ChristianLumby/Power2LabPowerSupply/Measurements/EMC/emc_setup.jpg

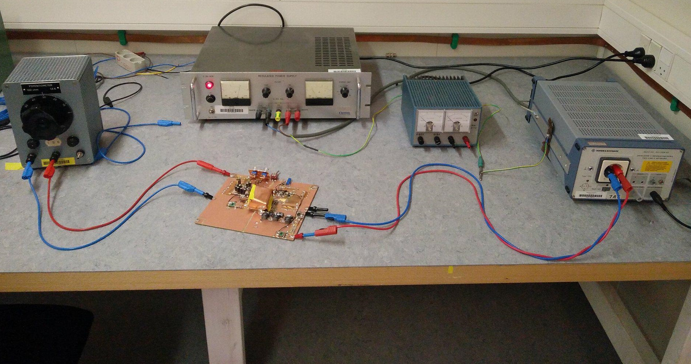
Measurements/EMC/emc_setup.jpg
