ChristianLumby/Power2LabPowerSupply/Measurements/Effeciency/eff_setup.jpg

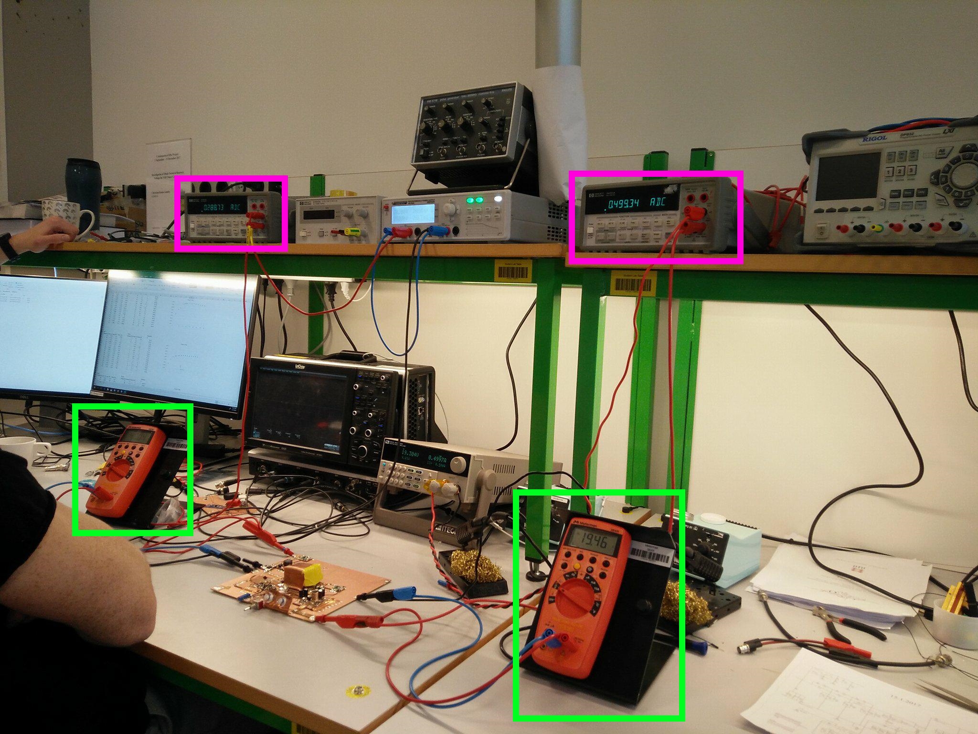
Measurements/Effeciency/eff_setup.jpg
