ChristianLumby/Power2LabPowerSupply/Notes/Notes.txt

Notes:

Pulldown resistor at gate (50k).
