ChristianLumby/Power2LabPowerSupply/31352_Power_Electronics_1_Final_Report.pdf

## Technical University of Denmark

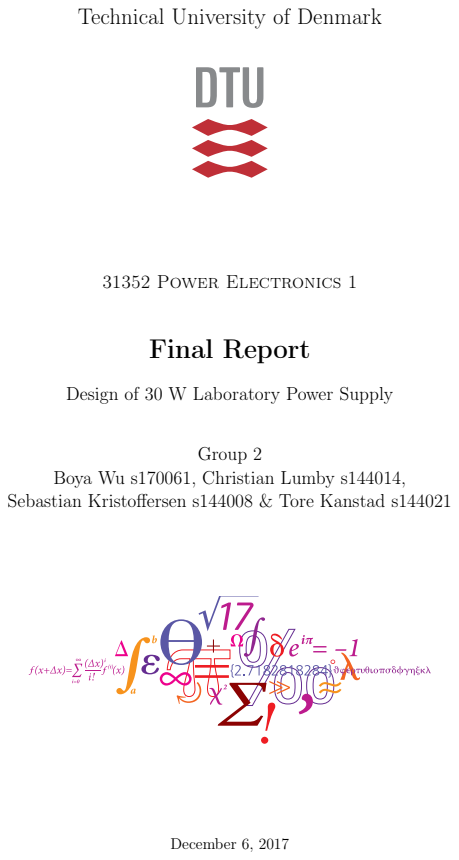
[picture p3: page 1]
31352 Power Electronics 1; Final Report; Group 2; December 6, 2017

Design of 30 W Laboratory Power Supply

Boya Wu s170061, Christian Lumby s144014,
Sebastian Kristoffersen s144008 & Tore Kanstad s144021

# Contents

1 Preface (SK, CL & TK) | 1
2 Topology Selection | 2
3 Magnetic Design (CL, SK, BW & TK) | 33

i

Contents | ii of 91
4 Filter Design | 48
5 Control Circuit (CL, SK & TK) | 68
6 Circuit Diagram and Bill of Materials (CL, SK, BW & TK) | 76
7 Performance Analysis (CL, SK & TK) | 79
8 Specification Comparison (CL, SK & TK) | 80
9 Discussion (CL, SK & TK) | 82
10 Conclusion (CL, SK & TK) | 83
A Magnetic Design: ETD-Cores | 84
B Magnetic Design: E-Cores | 86

Contents | iii of 91
C Efficiency Simulation Setup | 90

# List of Figures

2.1 The two cases of conversion ratios with the chosen transformer turns ratios marked
as black curves | | 3
2.2 Flyback converter | | 4
2.3 First subinterval of flyback converter | | 5
2.4 Second subinterval of flyback converter | | 5
2.5 Waveforms of Flyback Converter | | 6
2.6 The schematic of the SEPIC converter | | 11
2.7 First interval. Q1 is closed, D1 is blocking | | 11
2.8 Second interval. Q1 is open, D1 is conducting | | 11
2.9 Converter with LM | | 12
2.10 Waveforms of the isolated SEPIC converter | | 13
2.11 Isolated Ćuk converter with definitions of voltages and currents | | 18
2.12 Isolated Ćuk converter with MOSFET on | | 18
2.13 Isolated Ćuk converter with MOSFET off | | 18
2.14 Voltages and currents of the components in the Ćuk converter | | 19
2.15 Push-Pull converter with voltage and current definitions | | 24
2.16 First interval. Q1 is closed | | 24
2.17 Second and fourth interval. Both switches are open | | 25
2.18 Third interval. Q2 is closed | | 25
2.19 Current and voltage waveforms | | 26
3.1 Flyback converter with definitions of labels, polarities and directions | | 33
3.2 Magnetic flux density in the coupled inductor | | 33
3.3 Voltage and current waveforms | | 34
3.4 ETD-core and coil former dimension definitions | | 36
3.5 Minimum inductance to satisfy ripple current ratio | | 37
3.6 Relative core losses versus AC field flux density for N87, [1] p. 83 | | 43
3.7 Realizable ETD-core configurations with 2 primary layers | | 44
3.8 Cross section transformer. Grey: Core, Black: Bobbin, Red: Primary windings,
Yellow: Secondary windings, green: tertiary windings | | 45
3.9 Magnetization curves for N87, [1] p. 82 | | 46
4.1 Filter design overview | | 48
4.2 Minimum output capacitance, Coutmin [µF], as a function of Vin and Vout | | 50
4.3 PLECS simulation setup. Without input filter | | 52
4.4 Input Harmonics and CISPR 13 limits | | 53
4.5 Input Harmonics and CISPR 13 limits, zoomed in at the second and third harmonics.
Same colors as previous figure | | 54
4.6 Input filter topology | | 55
4.7 Small signal model of the Flyback converter | | 55
4.8 Impedance comparison for filter 2. Red: ZN , Black: ZD, Magenta: Zo2(undamped)

,
Blue: Zo2
| 56
4.9 Impedance comparison for filter 1. Red: ZN , Black: ZD, Magenta: Zo1(undamped)

,
Blue: Zo1
| 57
4.10 Impedance comparison for filter 0. Red: ZN , Black: ZD, Magenta: Zo0(undamped)

,
Blue: Zo0
| 57

iv

List of Figures | v of 91

4.11 Impedance comparison for entire filter. Red: ZN , Black: ZD, Blue: Zo, Magenta:
Margins | | 58
4.12 Filter gain, from transfer function, with the 200kHz point marked | | 59
4.13 Filter phase, from transfer function | | 59
4.14 PLECS simulation setup with input filter | | 60
4.15 Input Harmonics and CISPR 13 limits with input filter | | 61
4.16 Input Harmonics and CISPR 13 limits with filter, zoomed in at the second and third
harmonics. Same colors as previous figure | | 62
4.17 PLECS simulation setup for inrush current when starting the converter | | 63
4.18 Inrush current simulation results when starting the converter (at t = 0). Simulated
for two different input voltages | | 63
4.19 PLECS simulation setup for inrush current when connecting the converter | | 64
4.20 Inrush current simulation results when connecting the converter | | 64
4.21 Complete circuit with inrush limiter | | 65
4.22 Input current spike when connecting the converter. With inrush limiter | | 66
5.1 The TLV431 and the compensation network | | 69
5.2 Frequency response of the designed type 2 compensator | | 70
5.3 Model for loop response simulation in PLECS. Resistive parasitics are included in
this model | 70
5.4 Loop response of converter in the 4 corner cases in the case of the PLECS setup in
5.3. The vertical magenta lines are phase margins | | 71
5.5 The converter’s transient responses | | 72
5.6 The steady state ripple at output | | 72
5.7 Low pass filter for current sensing[9] | | 73
5.8 Compensating circuit[10] | | 74
6.1 Final circuit schematic | | 78
7.1 Efficiency estimation in PLECS. Based on eq. 7.1 | | 79
8.1 Output voltage during load step at 5V | | 80
8.2 Output voltage during load step at 30V | | 81
A.1 Realizable E-core configurations with 1 primary layer | | 85
B.1 Realizable E-core configurations with 1 primary layer | | 87
B.1 Realizable E-core configurations with 1 primary layer | | 88
B.2 Realizable E-core configurations with 2 primary layers | | 89
C.1 Complete circuit schematic for simulating efficiency, ripples and load steps | | 91

# List of Tables

1.1 Converter Specifications | | 1
2.1 Maximum, RMS and Average absolute values for the Components | | 9
2.2 Summary of the 4 corner cases | | 16
2.3 Maximum, RMS and average absolute values for the converter components | | 22
2.4 Maximum, RMS and average absolute values for the converter components . . . . | 29
2.5 Numerical comparison | | 32
3.1 ETD 29/16/10 parameters for N87 material | | 35
3.2 Conditions for determination of transformer configuration | | 44
4.1 Converter Specifications | | 48
4.2 Summary of transformer parameters | | 48
4.3 The four corner cases of operation | | 51
4.4 Capacitor RMS currents | | 66
4.5 Filter Parameters. See Fig. 4.21 | | 67
8.1 Converter Results | | 81
A.1 Conditions for determination of configurations in Fig. A.1 | | 84
B.1 Conditions for determination of configurations in Fig. B.1 | | 86
B.2 Conditions for determination of configurations in Fig. B.2 | | 86

vi

# 1 | Preface (SK, CL & TK)

The aim of this project was to design an isolated laboratory power supply. The converter’s efficiency and performance is for the most part considered more important than the size and weight of the laboratory supply. Firstly, four possible converter topologies are analyzed and compared for a final selection of a topology for further design. The analysis includes waveforms, modes of operation and component stress factors. For the chosen topology the magnetics are dimensioned and designed. This includes the physical configuration of windings and selection of core. This also includes an estimation of the winding and core losses based on more accurate current waveforms. An input and output filter of the converter is added to satisfy the specifications in table 1.1 while the impedance changes of the converter must also satisfy Middlebrook’s stability theorem. The design of the control loop of the converter using a peak current controller to achieve desired performance, and frequency analysis of the stability is done. Finally the report includes a review and summary of the work with a conclusion.

## 1.1 Specifications

| Condition | Minimum | Maximum
Vin | - | 20 V | 40 V
Vout | - | 5 V | 30 V
Iout | - | - | 1 A
∆Voutmax | Steady state | - | 50mV
∆Voutmax | Load step | - | 3 % of Vout
Input current harmonics | Steady state | - | CISPR 13 average
Inrush current spike | - | - | ETSI EN 300132-2

Table 1.1: Converter Specifications.

1

# 2 | Topology Selection

In this chapter, 4 different topologies for DC-DC switch mode converters are introduced and waveforms are analyzed with ideal components. The transformer ratios are determined from an analysis of the range of duty cycles required to meet the specifications in table 1.1. The stress factors of the components in the different topologies are calculated and finally a topology is chosen for the design of the laboratory power supply.

## 2.1 Transformer Turns Ratio (SK, CL & TK)

M is the DC conversion ratio.
M =

Vout

Vin

(2.1)

From the specifications it is seen that the minimum and maximum DC conversion ratios are:

Mmin =

5V
40V
= 0.125 | (2.2)

Mmax =

30V
20V
= 1.5 | (2.3)

As derived later, the conversion ratios of each converter are given by:

Mf lyback = MSEP IC = Mcuk =

nD
1 − D

(2.4)

Mpush−pull = nD | (2.5)

Where D is the duty cycle and n is the transformer ratio ns
np

. Expressions for the maximum and minimum duty cycles can be derived by using these formulas along with the minimum and maximum conversion ratios listed in equations (2.3) and (2.3).

Df lybackmin = DSEP ICmin = Dcukmin =

Mmin
n + Mmin

=

0.125
n + 0.125

(2.6)

Df lybackmax = DSEP ICmax = Dcukmax =

Mmax
n + Mmax

=

1.5
n + 1.5

(2.7)

Dpush−pullmin =

n

Mmin

=

0.125
n

(2.8)

Dpush−pullmax =

n

Mmax

=

1.5
n

(2.9)

From this it is seen that the range of duty cycles depends on the choice of transformer turns ratio. The limitations on the duty cycle are that it cannot be higher than 1 or lower than 0. One could argue that going close to zero duty cycle is preferable compared to going close to unity, because of the risk for shoot-through. But in this report, it is decided to place the range of duty cycles symmetrically. I.e. Dmax should be as close to 1 as Dmin is to 0.

D(Mmin) = 1 − D(Mmax) | (2.10)

Thus equation 2.6 and 2.7 are solved for the buck-boost types with the condition of equation 2.10. Similarly for the push-pull 2.8 and 2.9 are solved with the same conditions. The results are:

2

2.1. Transformer Turns Ratio (SK, CL & TK) | 3 of 91
nf lyback = nSEP IC = ncuk = 0.433 | (2.11)
npush−pull = 1.63 | (2.12)

Which gives the following duty cycle ranges.

Df lyback = DSEP IC = Dcuk ∈ [22%, 78%] | (2.13)
Dpush−pull ∈ [7.7%, 92%] | (2.14)

These transformer turns ratios are now chosen for the converters. Fig. 2.1 illustrates how the chosen values allow for a symmetric duty cycle to produce the needed minimum and maximum DC conversion ratios.

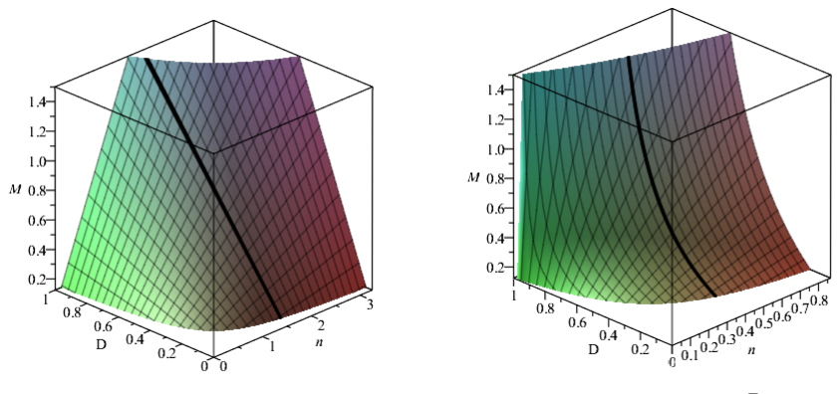
[picture p4: figure]

(a) M(n, D) = nD | (b) M(n, D) =

nD
1 − D

Figure 2.1: The two cases of conversion ratios with the chosen transformer turns ratios marked as black curves.

2.2. Flyback Converter (BW) | 4 of 91

## 2.2 Flyback Converter (BW)

### 2.2.1 Schematic & Operation

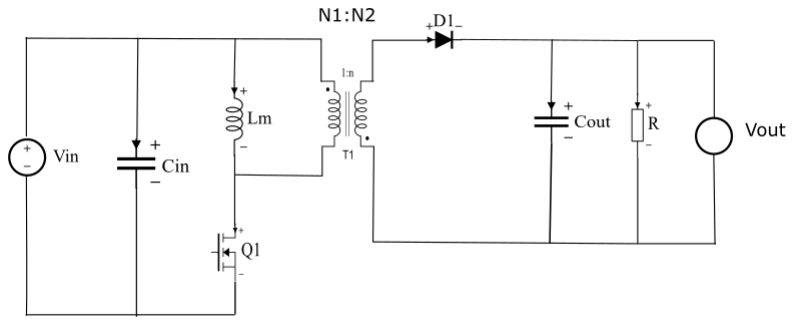
[picture p5: figure]

Figure 2.2: Flyback converter

The basic topology of flyback converter for the laboratory power supply is shown in Fig 2.2. According to introduction, the ratio is N1:N2= 1:n. There are two sub intervals in a duty circle. In the first interval, switch Q1 is turned on. The current flows from the source to the primary side of the transformer into the dot and then down to the Q1. The energy is stored into the transformer. In the secondary side, the current flows from the capacitor to the output and then go back to the capacitor. The diode D1 is in reverse bias in this condition so there is no current in D1.
In the second period, switch Q1 is turned off. The current flowing from the source to the input capacitor. And the voltage potential across Lm changes the direction. The current flowing through the primary side induces a current in the secondary side flowing from the transformer to D1, Cout, Rload and then back to the dot.

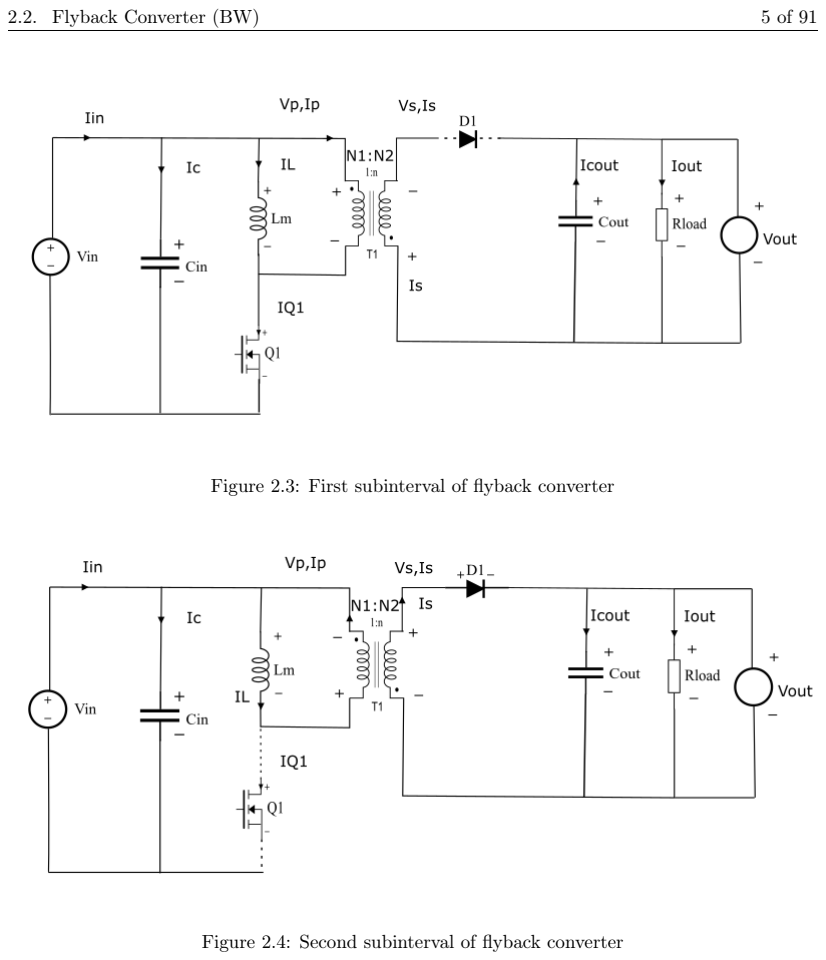
[picture p6: page 12]

2.2. Flyback Converter (BW) | 5 of 91

Figure 2.3: First subinterval of flyback converter

Figure 2.4: Second subinterval of flyback converter

2.2. Flyback Converter (BW) | 6 of 91

### 2.2.2 Voltage & Current Plots

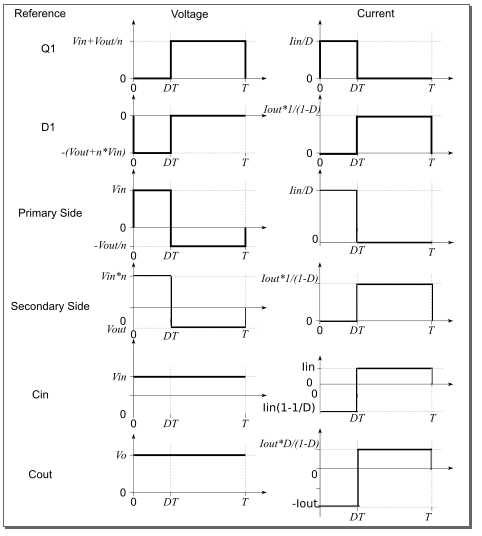
[picture p7: figure]

Figure 2.5: Waveforms of Flyback Converter

2.2. Flyback Converter (BW) | 7 of 91

### 2.2.3 Derivation of Equations

The calculation in the below are based on the CCM and the output voltage is 30V; output current is 1A. According to the Introduction, when the transformer turns ratio n = 0.43, the range of Df lyback is from 0.22 to 0.78.

Duty cycle and Transformer turns calculations:

From the voltage balance equation of primary windings the function can be got:

Vin ∗ DT = (Vo/n)(1 − D) ∗ T | (2.15)

Vo Vin
=
nD 1 − D | (2.16)

D =

Vo
Vin ∗ n + Vo

(2.17)

when Vin =40 V:

D =

Vo
Vin ∗ n + Vo

=

30
40 ∗ 0.43 + 30
= 0.63 | (2.18)

when Vin =20 V:

D =

Vo
Vin ∗ n + Vo

=

30
20 ∗ 0.43 + 30
= 0.78 | (2.19)

Input current calculations:

Because all components are consider to be ideal, therefore the input power is equal to the output power:

Vin ∗ Iin = Vo ∗ Iout | (2.20)

Iin =

Vo ∗ Iout

Vin

(2.21)

when Vin =40 V:

Iin =

30 ∗ 1
40
= 0.75 A | (2.22)

when Vin =20 V:

Iin =

30 ∗ 1
20
= 1.5 A | (2.23)

Switch voltages and currents calculations:

As it could be seen from the wave,

Vrms =

s
1
T

(

Z T

DT

((Vo/n) + Vin)

2dt = VinD

r
1
1 − D

(2.24)

Irms =

s
1
T

(

Z DT

0

(

Iin
D

)

2dt) = Iin
√
D

(2.25)

2.2. Flyback Converter (BW) | 8 of 91

Diode voltages and currents calculations

Vrms =

s
1
T

(

Z DT

0

(−(Vo + n ∗ Vin))²dt = Vout

1
√
D

(2.26)

Vmax = Vo + n ∗ Vin | (2.27)

Irms =

s
1
T

(

Z T

DT

(Iout ∗ (

1
1 − D

))²dt) = Ioutr
1
1 − D

(2.28)

Primary Windings voltages and currents calculations

Vrms =

1
T

[(Z DT

0

(Vin)dt +

Z T

DT

(Vo/n)dt] = 2Vout

1 − D
n

(2.29)

Irms =

s
1
T

(

Z DT

0

(

Iin
D

)

2dt = Iin

1
√
D

(2.30)

Secondary Windings voltages and currents calculations

Vrms =

1
T

(

Z T

DT

(Vin ∗ n)dt +

Z T

DT

kVokdt) = 2Vo(1 − D) | (2.31)

Irms =

s
1
T

(

Z T

DT

(Iout ∗

1
1 − D

)

2dt) = Ioutr
1
1 − D

(2.32)

Cin Voltages and currents calculations

Vmax = Vin | (2.33)

Irms = Irms =

s
1
T

(

Z T

DT

(Iin(1 −

1
D

))²dt +

Z T

DT

(Iin)

2dt) = Iinr
1 − D
D

(2.34)

CoutVoltages and currents calculations

Vmax = Vout | (2.35)

Irms =

s
1
T

[(Z DT

0

(−Iout)

2dt +

Z T

DT

(Iout ∗ (

D
1 − D

))²dt] = Ioutr
D
1 − D

(2.36)

2.2. Flyback Converter (BW) | 9 of 91

### 2.2.4 Summary of Formulas

| Symbol | Unit | Case 1 | Case 2 | Case 3 | Case 4 | Maximum | Expression
Turns ratio | n | - | 0.43 | 0.43 | 0.43 | 0.43 | 0.43 | -
Output voltage | Vout | V | 5.00 | 30.00 | 5.00 | 30.00 | 30.00 | -
Output current | Iout | A | 1.00 | 1.00 | 1.00 | 1.00 | 1.00 | -
Input voltage | Vin | V | 20.00 | 20.00 | 40.00 | 40.00 | 40.00 | -
Input current | Iin | A | 0.25 | 1.50 | 0.13 | 0.75 | 1.50 | VoutIout Vin
Duty-cycle | D | - | 0.37 | 0.78 | 0.23 | 0.63 | 0.78 | Vout Vin·n+V o
FET Q1 | max(VQ1) | V | 31.63 | 89.77 | 51.63 | 109.77 | 109.77 | Vo n + Vin
| RMS(IQ1) | A | 0.41 | 1.70 | 0.26 | 0.94 | 1.70 | √ Iin D
Diode D1 | |max(VD1)| | V | 13.60 | 38.60 | 22.20 | 47.20 | 47.20 | V out + nVin
| RMS(ID1) | A | 1.26 | 2.12 | 1.14 | 1.66 | 2.12 | Ioutq 1 1−D
Primary Winding | <|Vprim|> | V | 14.17 | 31.09 | 18.02 | 50.85 | 50.85 | 2Vout( 1−D n
)
| RMS(Iprim) | A | 0.41 | 1.70 | 0.26 | 0.94 | 1.70 | Iinq
| | | | | | | | 1 D
Secondary Winding | <|Vsec|> | V | 6.32 | 13.37 | 7.75 | 21.86 | 21.86 | 2Vo(1 − D)
| RMS(Isec) | A | 1.26 | 2.12 | 1.14 | 1.66 | 2.12 | Ioutq 1 1−D
Capacitor Cin | max(Vcin) | V | 20.00 | 20.00 | 40.00 | 40.00 | 40.00 | V in
| RMS(Icin) | A | 0.33 | 0.80 | 0.23 | 0.57 | 0.80 | Iinq 1−D D
Capacitor Cout | max(Vcout) | V | 5.00 | 30.00 | 5.00 | 30,00 | 30,00 | V out
| RMS(Icout) | A | 0.76 | 1.87 | 0.54 | 1.32 | 1.87 | Ioutq D 1−D
| Q1 CSF | | | | | | 38.76
| D1 CSF | | | | | | 11.11
| SCSF total | | | | | | 49.87
| Lprim CSF | | | | | | 8.32
| Lsec CSF | | | | | | 2.38
| WCSF total | | | | | | 10.7
| Cin CSF | | | | | | 1.15
| Cout CSF | | | | | | 3.49
| CCSF total | | | | | | 4.64

Table 2.1: Maximum, RMS and Average absolute values for the Components

2.2. Flyback Converter (BW) | 10 of 91

### 2.2.5 Components Stress Factor

SCSF voltages and currents calculations:

SCSFQ1 =

max(vQ1)

2 ∗ RMS(IQ1)

2
P²
= 38.76 | (2.37)

SCSFD1 =

max(vD1)

2 ∗ RMS(ID1)

2
P²
= 11.11 | (2.38)
SCSFtotal = 49.87 | (2.39)

WCSF voltages and currents calculations

W CSFLpri =

< |(vLpri| >² ∗RMS(ILpri)

2
P²
= 8.32 | (2.40)

W CSFLsec =

< |(vLsec| >² ∗RMS(ILsec)

2
P²
= 2.38 | (2.41)
W CSFtotal = 10.70 | (2.42)

CCSF voltages and currents calculations

CCSFCin =

(VCin )

2∗RMS(ICin )
2
P ² | = 1.15 | (2.43)

CCSFCo =

(VCo

)

2 ∗ RMS(ICo
)
| 2
P² | = 3.49 | (2.44)
CCSFtotal = 4.64 | | (2.45)

### 2.2.6 Advantages

- Compared with other three topologies the circuit of flyback converter is made up with fewer components which also decrease the size and the cost of the converter.
- Lower voltage rating on secondary components

### 2.2.7 Advantages

- Usually used in low power supply situation.
- Because of leakage inductance, the spike and ringing of current wave is high increasing the power loss.
- Half of core material B-H loop is utilized

2.3. SEPIC Converter (SK) | 11 of 91

## 2.3 SEPIC Converter (SK)

### 2.3.1 Schematic & Operation

The schematic of the SEPIC converter can be seen in fig 2.6. The operation mode of the converter when the switch is on can be seen in fig 2.7 and when the switch is off in fig 2.8.

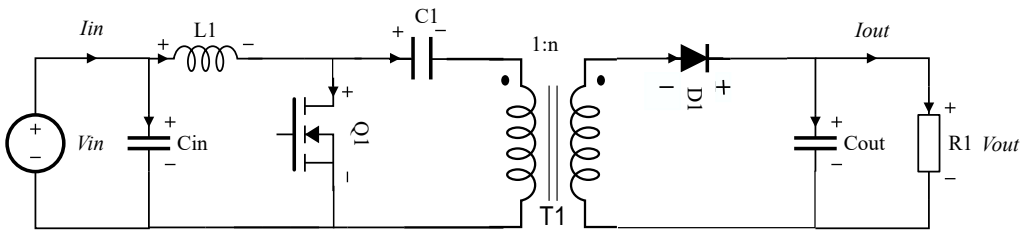
[picture p8: figure]
Vin; Iin; Iout; Cin; Cout; Vout

Figure 2.6: The schematic of the SEPIC converter

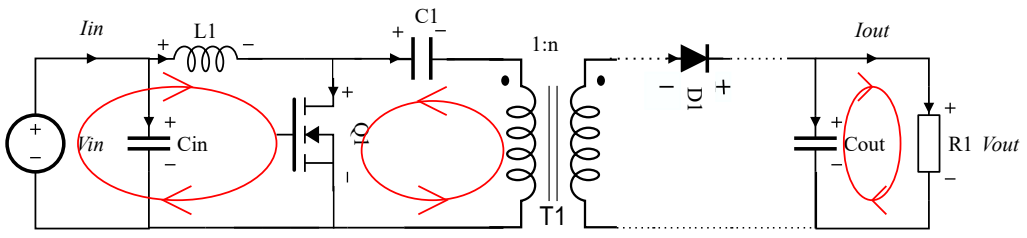
[picture p9: figure]
Vin; Iin; Iout; Cin; Cout; Vout

Figure 2.7: First interval. Q1 is closed, D1 is blocking

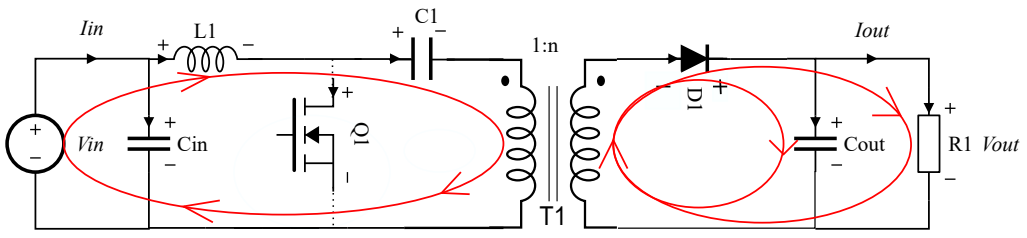
[picture p10: figure]
Vin; Iin; Iout; Cin; Cout; Vout

Figure 2.8: Second interval. Q1 is open, D1 is conducting

The analysis and calculations of the SEPIC is based on the model where the transformer primary side is replaced by an ideal transformer where all current and voltage is transformed to the secondary winding, in parallel with an ideal magnetisation inductor. This is seen in fig 2.9. The currents used for the analysis are labelled. I1 is the input current through L1 and i2 is the inductor current in LM. Both currents are assumed constant as capacitors and inductors in this analysis is assumed ideal. Is is the current through the diode on the secondary side. All currents are in the directions of the arrows in the figure.

2.3. SEPIC Converter (SK) | 12 of 91

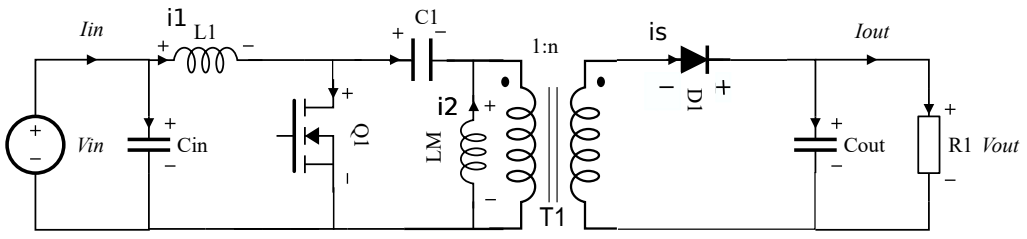
[picture p11: figure]
Vin; Iin; Iout; Cin; Cout; Vout

Figure 2.9: Converter with LM

2.3. SEPIC Converter (SK) | 13 of 91

### 2.3.2 Voltage & Current Plots

Vout (1-D)/(n D)

0
0 | DT | T

Q1

Reference | Voltage | Currrent

D1

L1

C1
-Iout n
0

Iout n D/(1-D)

Cin

Vin

0

DT | T

0
0 | DT | T

Iin

0
0 | DT | T

-Vin D/(1-D)
0

Vin

0

DT | T

Iout n/(1-D)

0
0 | DT | T

Vin/(1-D)

0
0 | DT | T

0
0 | DT | T

Iout/(1-D)

0
0 | DT | T

0

Vout/D

0 | DT | T

Primary Windings

n Iout D/(1-D)
0
0 | DT | T

-Vout (1-D)/(n D)
0

Vout/n
0
DT | T
Secondary Windings | Iout/(1-D)

0
0 | DT | T

-Vout (1-D)/D
0

Vout

0

DT | T

-Iout n

Cout

Vout

0
0 | DT | T

-Iout

0

0 | DT | T

Iout D/(1-D)

Figure 2.10: Waveforms of the isolated SEPIC converter

2.3. SEPIC Converter (SK) | 14 of 91

### 2.3.3 Derivation of Equations

The currents in the circuit were analyzed using the model of the transformer where there is a magnetization inductor in parallel with the primary windings of the transformer and then the currents are defined:
i1=Iin is the current in L1, i2 is the current in LM; the magnetisation inductor, Is is the current in the diode when it is conducting and Iout is the output current. Later the windings are just treated as the transformer in series with the capacitor; the current through C1 is equal to the current in the primary side, but when the diode is blocking on the secondary side a current still flows in the primary side, just only affecting LM.
Iin,i1,i2,Is are related to Iout:

i1 =

nD · Iout
1 − D

(2.46)

i2 = Iout · n | (2.47)

Is =

Iout 1 − D | (2.48)
Iin = i1 | (2.49)

When the switch is on the voltage across it is Vin. The voltage across the switch when it is off is found by using the voltage balance on L1, and is found to be:

V inD + (1 − D)(V in − Vq1,of f ) = 0 | (2.50)
m | (2.51)

Vq1,of f =

V in 1 − D | (2.52)

During the switch’s off-time the diode conducts; the voltage across it is 0. The voltage across the primary windings are equal to the output voltage divided by the turns ratio. The voltage across C1 is equal to Vq1,of f since the average voltage across the windings must be 0.

V in 1 − D
− V in =
V out n | (2.53)
m | (2.54)

D =

V out nV in + V out | (2.55)

RMS of currents

Iq1RMS =

s
1
T

Z T

0

iq1

2dt =

s
1
T

Z DT

0

(i1 + i2)²dt +

1
T

Z T

DT

0dt =

√
D

Ioutn
1 − D
| (2.56)

Id1RMS =

s
1
T

Z T

0

id1

2dt =

s
1
T

Z DT

0

0dt +

1
T

Z T
DT
i1 + i2
n

2
dt =

r
Iout²
1 − D

(2.57)

ICoutRMS =

s
1
T

Z T

0

Icout²dt =

s
1
T

Z DT

0

(−Iout)

2dt +

1
T

Z T

DT

(Is − Iout)

2dt = Ioutr
D
1 − D
(2.58)

2.3. SEPIC Converter (SK) | 15 of 91

IC1RMS =

s
1
T

Z T

0

IC1

2dt =

s
1
T

Z DT

0

i2

2dt +

1
T

Z T

DT

i1

2dt = nIoutr
D
1 − D

(2.59)

The primary windings are in series with C1 so they have the same currents, and the secondary windings are in series with D1 so they have the same currents. L1 is in series with the source so the RMS current is equal to the DC current Iin.

Average absolute voltage across inductors

1
T

Z T

0

|vL1|dt =

1
T

Z DT

0

|V in|dt +

1
T

Z T

DT

−V in D
1 − D

dt =

2V out(1 − D)
n

(2.60)

1
T

Z T

0

|vprim|dt =

1
T

Z DT

0

−

V out(1 − D)
nD

dt +

1
T

Z T

DT

V out
n

=

2V out(1 − D)
n

(2.61)

Since the voltage on the secondary side is transformed from the primary side the voltage is equal to the primary multiplied by n.

1
T

Z T

0

|vsec|dt = 2V out(1 − D) | (2.62)

### 2.3.4 Summary of Formulas and Component Stress Factors

A summary of the expressions for the different voltages and currents are listen below. The component stress factor is calculated from the values in the table based on the following equations, where P is the maximum output power of 30W. The maximum values are used.

Semiconductor component stress factor:

SCSF =

v

2
pk · I

2
RMS P² | (2.63)

Winding component stress factor:

W CSF =

< |v| >²
·I

2
RMS P² | (2.64)

Capacitor component stress factor:

CCSF =

v

2
pk · I

2
RMS P² | (2.65)

2.3. SEPIC Converter (SK) | 16 of 91

Table 2.2: Summary of the 4 corner cases

| Symbol | Unit | Case 1 | Case 2 | Case 3 | Case 4 | Max | CSF | Expression
Turns ratio | n | | 0,43 | 0,43 | 0,43 | 0,43 | 0,43
Output voltage | Vo | V | 5,00 | 5,00 | 30,00 | 30,00 | 30,00
Output current | Io | A | 1,00 | 1,00 | 1,00 | 1,00 | 1,00
Input voltage | Vin | V | 20,00 | 40,00 | 20,00 | 40,00 | 40,00
Input current | Iin | A | 0,25 | 0,13 | 1,50 | 0,75 | 1,50 | | V out·Iout V in
Duty cycle | D | | 0,37 | 0,22 | 0,78 | 0,63 | 0,78 | | V out V in·n+V out
FET Q1 | max(VQ1) | V | 31,55 | 51,55 | 89,28 | 109,28 | 109,28 | 38,48 | V in 1−D
| RMS(IQ1) | A | 0,41 | 0,26 | 1,70 | 0,94 | 1,70

√
| | | | | | | | | D·n·Iout 1−D
Diode D1 | max(VD1) | V | 13,66 | 22,32 | 38,66 | 47,32 | 47,32 | 11,11 | V out D
| RMS(ID1) | A | 1,26 | 1,14 | 2,11 | 1,65 | 2,11 | | √ Iout 1−D
Inductor L1 | <|VL1|> | V | 14,64 | 17,92 | 31,04 | 50,72 | 50,72 | 6,43 | 2(1−D)·V out n
| RMS(IL1) | A | 0,25 | 0,13 | 1,50 | 0,75 | 1,50 | | Iin
Primary | <|Vprim|> | V | 14,64 | 17,92 | 31,04 | 50,72 | 50,72 | 12,76 | 2(1−D)·V out n
Winding | RMS(Iprim) | A | 1,26 | 1,14 | 2,11 | 1,65 | 2,11 | | n · Iout ·

q D
| | | | | | | | | 1−D
Secondary | <|Vsec|> | V | 6,34 | 7,76 | 13,44 | 21,96 | 21,96 | 2,39 | 2(1 − D) · V out
Winding | RMS(Isec) | A | 1,26 | 1,14 | 2,11 | 1,65 | 2,11 | | √ Iout 1−D
Capacitor | max(Vcin) | V | 20,00 | 40,00 | 20,00 | 40,00 | 40,00 | 0,00 | V in
Cin | RMS(Icin) | A | 0,00 | 0,00 | 0,00 | 0,00 | 0,00 | | 0
Capacitor | max(Vcout) | V | 5,00 | 5,00 | 30,00 | 30,00 | 30,00 | 3,46 | V out
Cout | RMS(Icout) | A | 0,76 | 0,54 | 1,86 | 1,32 | 1,86 | | Iout ·

q D
| | | | | | | | | 1−D
Capacitor | max(VC1) | V | 20,00 | 40,00 | 20,00 | 40,00 | 40,00 | 1,15 | V in
C1 | RMS(IC1) | A | 0,33 | 0,23 | 0,81 | 0,57 | 0,81 | | n · Iout ·

q D
| | | | | | | | | 1−D

The total component stress factor is the sum of the individual CSF:
Semiconductor component stress factor (SCSF) is 49.58
Winding component stress factor (WCSF) is 21.58
Capacitative component stress factor (CCSF) is 4.62

2.3. SEPIC Converter (SK) | 17 of 91

### 2.3.5 Advantages

Buck-boost type converter. The input can be both higher and lower than the output.

The output is non-inverting.

Few active components.

The FET is lowside making it easier to control.

### 2.3.6 Disadvantages

All energy is transfered through a series capacitor which in turn must be able to handle the current.

Ringing is likely.

Rather high winding stresses.

Pulsating output current.

2.4. Ćuk Converter - (CL) | 18 of 91

## 2.4 Ćuk Converter - (CL)

The chapter is dedicated to the analysis of using an isolated Ćuk converter for a lab power supply with specifications as described in the introduction. For the sake of simplicity, it is assumed that all capacitors and inductors are of infinite size, and all other components are considered ideal.

### 2.4.1 Schematic & Operation

The Ćuk converter is shown in its isolated form in Fig. 2.11, where labels and directions of voltages and currents used throughout the analysis are defined.

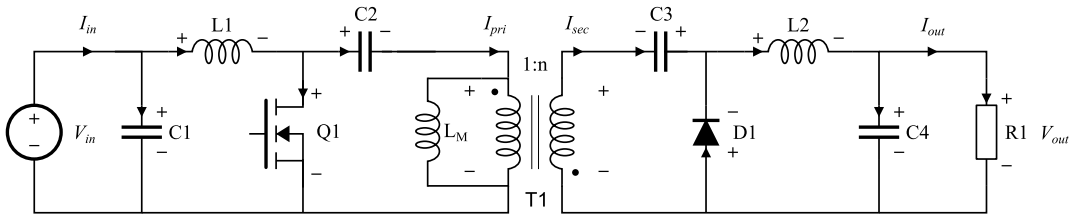
[picture p12: figure]

Figure 2.11: Isolated Ćuk converter with definitions of voltages and currents.

When the MOSFET is on (conducting), the circuit operates as shown in Fig. 2.12, where the diode is reverse biased and hence not conducting. In Fig. 2.13 the circuit operation with the MOSFET off is illustrated, in which case the diode is conducting.

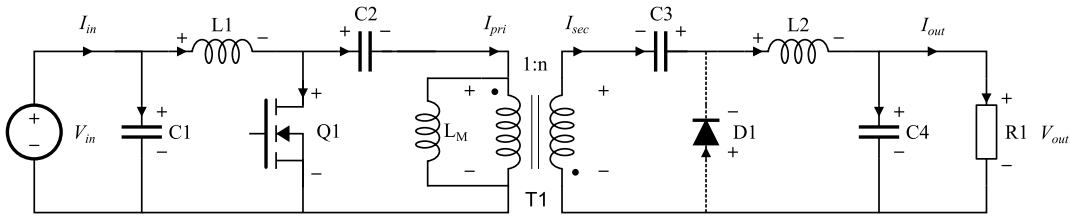
[picture p13: figure]

Figure 2.12: Isolated Ćuk converter with MOSFET on.

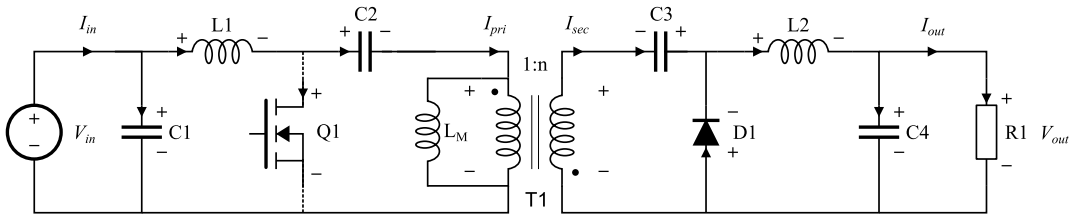
[picture p14: figure]

Figure 2.13: Isolated Ćuk converter with MOSFET off.

Since it is assumed that the inductors are infinitely large, the current through both L1 and L2 will be constant, and hence the capacitors C1 and C4 will never be charged or discharged during steady state operation. These capacitors will therefore be neglected for the rest of the analysis.

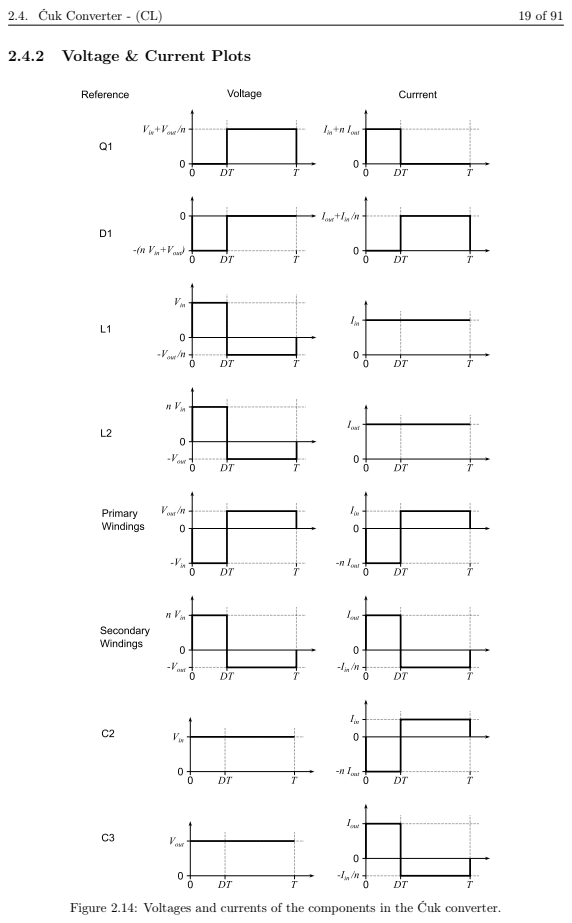
[picture p15: page 26]
2.4. Ćuk Converter - (CL)

2.4.2 Voltage & Current Plots

Figure 2.14: Voltages and currents of the components in the Ćuk converter.

2.4. Ćuk Converter - (CL) | 20 of 91

### 2.4.3 Derivation of Equations

Definitions

RMS Current
RMS(i(t)) = s
1
T

Z T

0

i(t)

2dt | (2.66)

Average Absolute Voltage

< |v(t)| >T =

1
T

Z T

0

|v(t)|dt | (2.67)

As the converter is assumed to have ideal components and 100% efficiency the power in must equal the power out. The input current is then:

Iin =

VoutIout Vin | (2.68)

Conversion Ratio

The principle of volt-second balance is applied to the inductor L2, see waveform in Fig. 2.14.

nVinDT − Vout(−DT + T) = 0 m

M(n, D) =

Vout

Vin

=

n D
1 − D

(2.69)

Reapplying the principle of conservation of power in an ideal converter, yields the following relation between input and output current, which will be used repeatedly to determine RMS currents expressed as functions of only Iout, n and D.

Iin =

Vout

Vin

Iout =

n D
1 − D
Iout | (2.70)

RMS Currents

The following calculations of RMS currents are based on the waveforms shown in Fig. 2.14.

Inductor L1
s
1
T

Z T

0

iL1(t)

2dt = Iin =

n D
1 − D
Iout | (2.71)

Inductor L2
s
1
T

Z T

0

iL2(t)

2dt = Iout | (2.72)

Primary Winding
s
1
T

Z T

0

iLpri(t)

2dt =

### vuut

1
T

Z DT

0

(−nIout)

2dt +

Z T

DT

I

2

indt!

= nIouts
D
1 − D

(2.73)

2.4. Ćuk Converter - (CL) | 21 of 91

Secondary Winding
s
1
T

Z T

0

iLsec(t)

2dt =

### vuuut

1
T

Z DT

0

I

2
outdt +

Z T

DT "
− Iin
n

#2

dt
- = Iouts
D
1 − D

(2.74)

Switch Q1
s
1
T

Z T

0

iQ1(t)

2dt =

### vuut

1
T

Z DT

0

(Iin + nIout)

2dt +

Z T

DT

0

2dt!
= nIout

√
D
1 − D

(2.75)

Diode D1
s
1
T

Z T

0

iD1(t)

2dt =

### vuuut

1
T

Z DT

0

0

2dt +

Z T

DT "

Iout +

Iin
n

#2

dt
- =

Iout √
1 − D

(2.76)

Capacitor C2
s
1
T

Z T

0

iC2(t)

2dt =

### vuut

1
T

Z DT

0

(−nIout)

2dt +

Z T

DT

I

2

indt!

= nIouts
D
1 − D

(2.77)

Capacitor C3
s
1
T

Z T

0

iC3(t)

2dt =

### vuuut

1
T

Z DT

0

I

2
outdt +

Z T

DT "
− Iin
n

#2

dt
- = Iouts
D
1 − D

(2.78)

2.4. Ćuk Converter - (CL) | 22 of 91

### 2.4.4 Summary of Formulas

The four most extreme combinations of input and output voltages are considered here.

| Symbol | Unit | Case 1 | Case 2 | Case 3 | Case 4 | Max | Expression
Turns
ratio | n | - | 0.433 | 0.433 | 0.433 | 0.433 | 0.433

Output
voltage | Vout | V | 5.00 | 30.00 | 5.00 | 30.00 | 30.00

Output
current | Iout | A | 1.00 | 1.00 | 1.00 | 1.00 | 1.00

Input
voltage | Vin | V | 20.00 | 20.00 | 40.00 | 40.00 | 40.00

Input

current | Iin | A | 0.25 | 1.50 | 0.13 | 0.75 | 1.50 | VoutIout
| | | | | | | | Vin
Duty-cycle | D | - | 0.37 | 0.78 | 0.22 | 0.63 | 0.78 | Vout
| | | | | | | | nVin + Vout
L1 | < |VL1| > | V | 14.64 | 31.04 | 17.92 | 50.72 | 50.72 | DVin + Vout(1 − D)
| | | | | | | | n
| RMS(IL1) | A | 0.25 | 1.5 | 0.13 | 0.75 | 1.50 | nD
| | | | | | | | 1 − D Iout
L2 | < |VL2| > | V | 6.34 | 13.44 | 7.76 | 21.96 | 21.96 | nDVin + Vout(1 − D)
| RMS(IL2) | A | 1 | 1 | 1 | 1 | 1 | Iout
Lpri | < |VLpri| > | V | 14.64 | 31.04 | 17.92 | 50.72 | 50.72 | DVin + Vout(1 − D)
| | | | | | | | n
| RMS(ILpri) | A | 0.33 | 0.81 | 0.23 | 0.57 | 0.81 | nIouts D
| | | | | | | | (1 − D)
Lsec | < |VLsec| > | V | 6.34 | 13.44 | 7.76 | 21.96 | 21.96 | nDVin + Vout(1 − D)
| RMS(ILsec) | A | 0.76 | 1.86 | 0.54 | 1.32 | 1.86 | Iouts D
| | | | | | | | 1 − D
Q1 | max(VQ1) | V | 31.55 | 89.28 | 51.55 | 109.28 | 109.28 | Vin + vout
| | | | | | | | n
| RMS(IQ1) | A | 0.41 | 1.7 | 0.26 | 0.94 | 1.7 | nIout

√
| | | | | | | | D
| | | | | | | | 1 − D
D1 | max(−VD1) | V | 13.66 | 38.66 | 22.32 | 47.32 | 47.32 | nVin + Vout
| RMS(ID1 ) | A | 1.26 | 2.11 | 1.14 | 1.65 | 2.11 | Iout √
| | | | | | | | 1 − D
C2 | max(VC2) | V | 20 | 20 | 40 | 40 | 40 | Vin
| RMS(IC2) | A | 0.33 | 0.81 | 0.23 | 0.57 | 0.81 | nIouts D
| | | | | | | | 1 − D
C3 | max(VC3) | V | 5.00 | 30.00 | 5.00 | 30.00 | 30.00 | Vout
| RMS(IC3) | A | 0.76 | 1.86 | 0.54 | 1.32 | 1.86 | Iouts D
| | | | | | | | 1 − D

Table 2.3: Maximum, RMS and average absolute values for the converter components.

2.4. Ćuk Converter - (CL) | 23 of 91

### 2.4.5 Component Stress Factor

The component stress factors are calculated from the results summarized in Table 2.3, while ignoring the weighting between components by setting the weighting fraction to unity in each term. The power used in these calculations is the highest output power, which is 30 W.

Winding Stress Factor

W CSFL1 =

< |(vL1| >²
·RMS(IL1)

2
P²
= 6.43 | (2.79)

W CSFL2 =

< |(vL2| >²
·RMS(IL2)

2
P²
= 0.54 | (2.80)

W CSFLpri =

< |(vLpri| >²
·RMS(ILpri)

2
P²
= 1.88 | (2.81)

W CSFLsec =

< |(vLsec| >²
·RMS(ILsec)

2
P²
= 1.85 | (2.82)
W CSFtotal = 10.7 | (2.83)

Semiconductor Stress Factor

SCSFQ1 =

max(vQ1)

2
- RMS(IQ1)

2
P²
= 38.3 | (2.84)

SCSFD1 =

max(vD1)

2
- RMS(ID1)

2
P²
= 11.1 | (2.85)
SCSFtotal = 49.4 | (2.86)

Capacitor Stress Factor

CCSFC2 =

(vC2peak )

2
- RMS(IC2)

2
P²
= 1.2 | (2.87)

CCSFC3 =

(vC3peak )

2
- RMS(IC3)

2
P²
= 3.5 | (2.88)
CCSFtotal = 4.7 | (2.89)

### 2.4.6 Advantages & Disadvantages

Some advantages and disadvantages of the Ćuk converter are:

Advantages

- Single low-side switch
- Inductors in series with input and output gives small current ripple, e.g. good for batteries

Disadvantages

- High switch blocking voltage
- Multiple LC-networks to cause resonance
- Both input and output current is transferred through capacitors, which means that they must be capable of handling quite a lot of current

2.5. Push-Pull Converter (TK) | 24 of 91

## 2.5 Push-Pull Converter (TK)

The push-pull converter is a buck type isolated converter unlike the other topologies discussed here.

### 2.5.1 Schematic & Operation

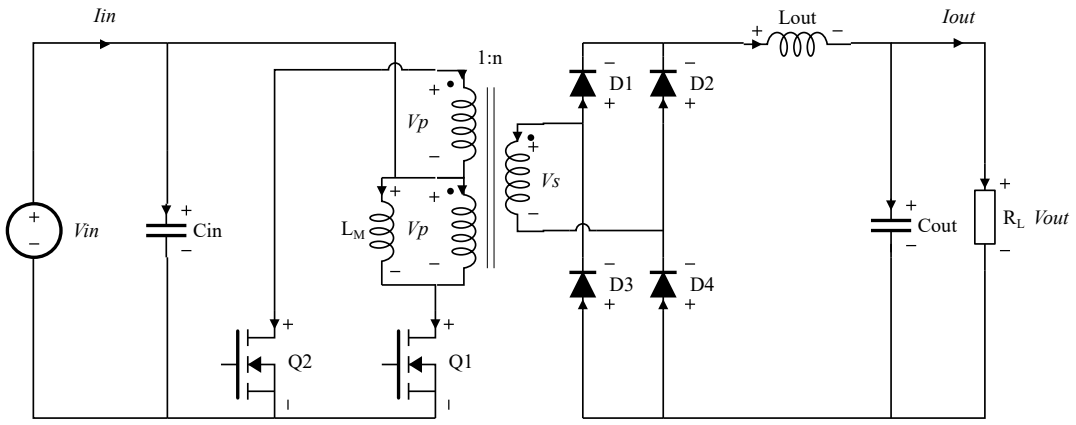
[picture p16: figure]
Vin; Iout; Vout Cin; Lout; Cout; Iin

Figure 2.15: Push-Pull converter with voltage and current definitions

The push-pull converter have two switches. The operation can be divided into four intervals. One where Q1 is closed, two where both are open and one where Q2 is closed. No current ever runs through the output capacitor because of the assumed constant inductor current.

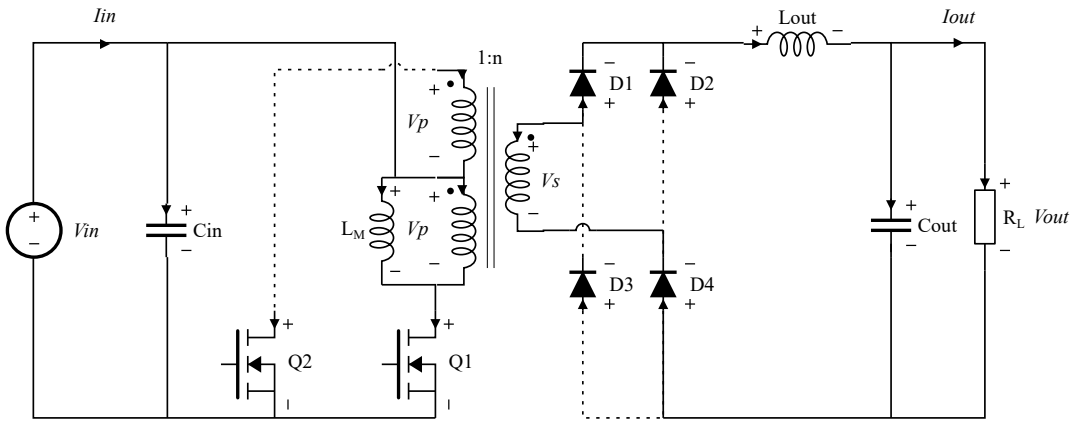
[picture p17: figure]
Vin; Iout; Vout Cin; Lout; Cout

Iin | Figure 2.16: First interval. Q1 is closed

When Q1 is closed, the voltage Vp over the primary winding is Vin. This voltage is transformed to the secondary side, Vs = nVin. This voltage forward biases D1 and D4 which makes it possible for a current to run (D2 and D3 are reverse biased). A current now runs from the voltage source and input capacitor and into the lower primary winding. The primary side current is transformed to the secondary winding with a factor 1
n

. This current runs through D1, D4, the output inductor and through the load.

2.5. Push-Pull Converter (TK) | 25 of 91

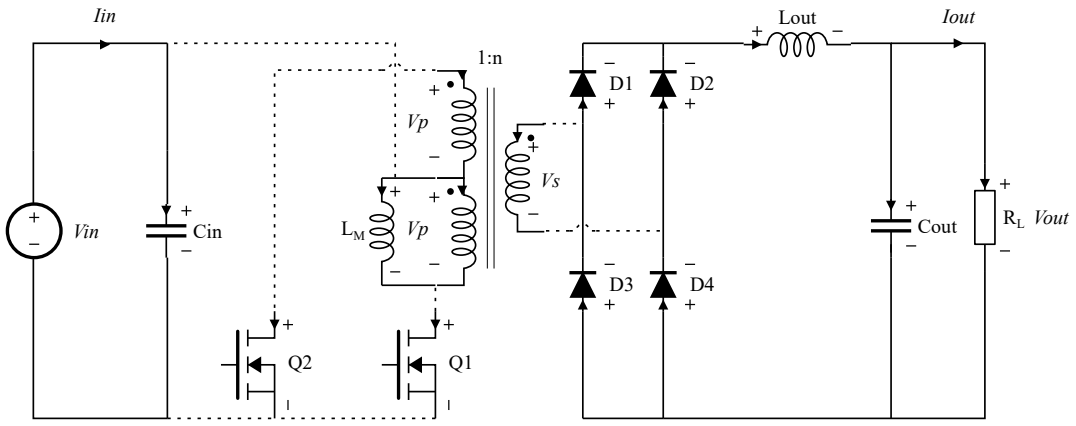
[picture p18: figure]
Vin; Iout; Vout Cin; Lout; Cout; Iin

Figure 2.17: Second and fourth interval. Both switches are open.

Both switches are open in the second interval. The output inductor causes a freewheeling current to go through all diodes and to the output. No currents are running through the transformer windings.

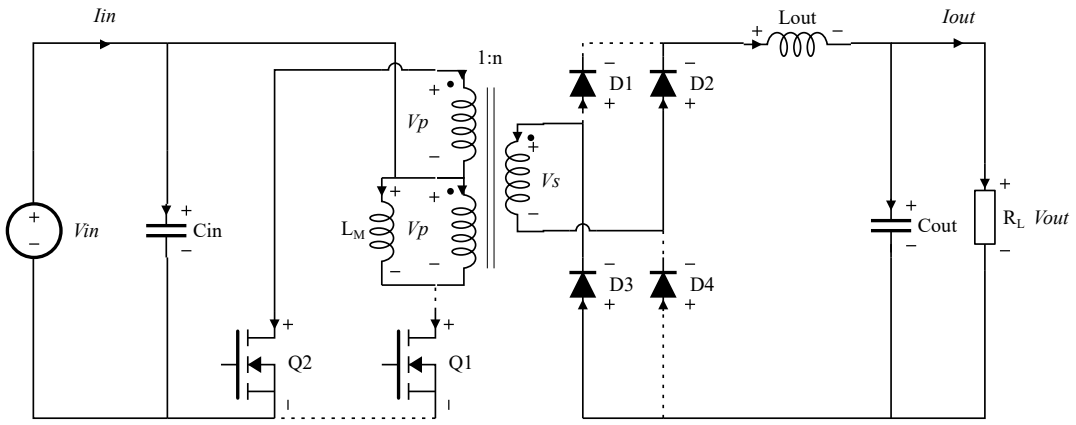
[picture p19: figure]
Vin; Iout; Vout Cin; Lout; Cout; Iin

Figure 2.18: Third interval. Q2 is closed.

In the third interval the second switch is closed. The primary winding voltage Vp is −Vin. The volt-second balance for the transformer is achieved by keeping both switches closed an equal amount of time. Interval 3 and 4 are quite similar to 1 and 2 except for the opposite transformer voltages.

### 2.5.2 Voltage & Current Plots

Q1 is closed in the interval [0, DT] and Q2 is closed in the interval [T, T + DT].

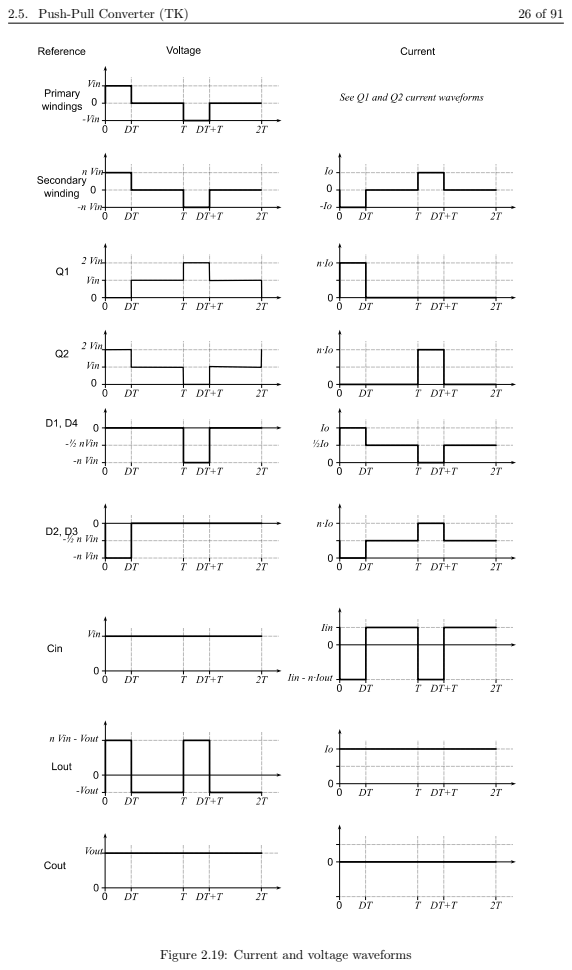
[picture p20: page 33]
2.5. Push-Pull Converter (TK)

Figure 2.19: Current and voltage waveforms

2.5. Push-Pull Converter (TK) | 27 of 91

### 2.5.3 Derivations of Equations

RMS Current Definition

RMS(i(t)) = s
1
T

Z T

0

i(t)

2dt | (2.90)

Average Absolute Voltage Definition

< |v(t)| >T =

1
T

Z T

0

|v(t)|dt | (2.91)

Input current

As the converter is assumed to have ideal components and 100% efficiency the power in must equal the power out. The input current is then:

Iin =

VoutIout

Vin

(2.92)

Conversion ratio M(D)

The principle of volt-second balance is applied to the output inductor. When one of the switches are closed its voltage is nVin − Vout. When all switches are open its voltage is −Vout.

D(nVin − Vout) = (1 − D)(−Vout) | (2.93)
⇐⇒
M(D) = Vout
Vin
= nD | (2.94)

Primary Winding Average Absolute Voltages

This is the same for the upper and lower primary windings.

< |Vp| >T =

1
T

Z DT

0

Vindt = DVin | (2.95)

RMS Current of Switches and Primary Windings

The current through the lower primary winding equals the current through Q1. The same is valid for the upper primary winding and Q2, except for the sign change. Furthermore, since both switches are closed an equal amount of time, their RMS currents will be the same.

RMS(IQ2) = RMS(IQ1) = s
1
2T

Z DT

0

(nIout)

2dt =

r
D
2
nIout | (2.96)

Secondary Winding Average Absolute Voltage

< |Vs| >T = nDVin | (2.97)

Secondary Winding RMS Current

RMS(Is) = s
1
T

Z DT

0

(Iout)

2dt =

√
DIout | (2.98)

2.5. Push-Pull Converter (TK) | 28 of 91

RMS Currents of Diodes

The notation Dx is used as the RMS currents are identical for all four diodes.

RMS(IDx) = q
1
2T

(

R DT
0

I

2

outdt + 2 R T
DT (

Iout
2

)

2dt) = q
D
2

I

2

out + (1 − D)( Iout
2

)

2
⇐⇒
RMS(IDx) = Iout
2

√
D + 1 | (2.99)

Input Capacitor RMS Current

The expression for Iout in (2.92) is used here.

RMS(ICin) = q
1
T

R DT
0

(Iin − nIout)

2dt +

R T
DT I

2
indt
⇐⇒
RMS(ICin) = Ioutq
Dn² −

2DVoutn
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
| (2.100)
⇐⇒
RMS(ICin) = Iouts
Vout · n

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
| (2.101)

Output Inductor Average Absolute Voltage

< |VLout | >T =

1
T

(

R DT
0

|nVin − Vout|dt +

R T
DT | − Vout|dt)
⇐⇒
< |VLout | >T = D · (nVin − Vout) + (1 − D) · Vout
⇐⇒
< |VLout | >T = (nVin − 2Vout)D + Vout | (2.102)
⇐⇒
< |VLout | >T = −2

V

2
out n · Vin | (2.103)

Output Capacitor RMS Current

The current through the output capacitor is zero because the output current and output inductor current are constant.

2.5. Push-Pull Converter (TK) | 29 of 91

### 2.5.4 Summary of Formulas

The four most extreme combinations of input and output voltages are considered here.

| Symbol | Unit | Case 1 | Case 2 | Case 3 | Case 4 | Maximum | Expression
Turns
ratio | n | - | 1.63 | 1.63 | 1.63 | 1.63 | 1.63 | -

Output
voltage | Vout | V | 5.00 | 30.00 | 5.00 | 30.00 | 30.00 | -

Output
current | Iout | A | 1.00 | 1.00 | 1.00 | 1.00 | 1.00 | -

Input
voltage | Vin | V | 20.00 | 20.00 | 40.00 | 40.00 | 40.00 | -

Input

current | Iin | A | 0.25 | 1.50 | 0.13 | 0.75 | 1.50 | VoutIout
| | | | | | | | Vin
Duty-cycle | D | - | 0.15 | 0.92 | 0.08 | 0.46 | 0.92 | Vout
| | | | | | | | nVin
Primary
windings | < |V p| > | V | 3.08 | 18.46 | 3.08 | 18.46 | 18.46 | DVin
Upper primary winding | RMS(Ipu) | A | 0.45 | 1.10 | 0.32 | 0.78 | 1.10 | r D
| | | | | | | | 2 nIout
Lower primary winding | RMS(Ipl) | A | 0.45 | 1.10 | 0.32 | 0.78 | 1.10 | r D
| | | | | | | | 2 nIout

Secondary
winding | < |V s| > | V | 5.00 | 30.00 | 5.00 | 30.00 | 30.00 | nDVin
| RMS(Is) | A | 0.39 | 0.96 | 0.28 | 0.68 | 0.96 | √
| | | | | | | | DIout

Switches
Qx | max(−VQx) | V | 40.00 | 40.00 | 80.00 | 80.00 | 80.00 | 2Vin
| RMS(IQs) | A | 0.45 | 1.10 | 0.32 | 0.78 | 1.10 | r D
| | | | | | | | 2 nIout

Diodes
Dx | max(VDx) | V | 32.50 | 32.50 | 65.00 | 65.00 | 65.00 | nVin
| RMS(IDx ) | A | 0.54 | 0.69 | 0.52 | 0.60 | 0.69 | 1
| | | | | | | | 2 Iout√
D + 1

Input
capacitor | max(VCin) | V | 20.00 | 20.00 | 40.00 | 40.00 | 40.00 | Vin
| RMS(ICin) | A | 0.59 | 0.43 | 0.43 | 0.81 | 0.81 | Iouts Vout · n

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
Output
inductor | < |VLout| > | V | 8.46 | 4.62 | 9.23 | 32.31 | 32.31 | −2 V
| | | | | | | | 2
| | | | | | | | out
| | | | | | | | n · Vin
| RMS(ILout) | A | 1.00 | 1.00 | 1.00 | 1.00 | 1.00 | Iout

Output
capacitor | max(Vcout) | V | 5.00 | 30.00 | 5.00 | 30.00 | 30.00 | Vout
| RMS(ICout) | A | 0.00 | 0.00 | 0.00 | 0.00 | 0.00 | 0

Table 2.4: Maximum, RMS and average absolute values for the converter components

2.5. Push-Pull Converter (TK) | 30 of 91

### 2.5.5 Component Stress Factor

The weigth factor

P
j Wj
Wi

is set to 1 for all calculations. P is the maximum total power processed

P = max(Iout) · max(Vout). The total stress factors are the sums of the individual stress factor in each category.

Semiconductor Stress Factor

The two switches experience the same stress. The same holds for the four diodes.

SCSFQx =

max(vQx)

2
- RMS(IQx)

2
P²
= 8.67 | (2.104)

SCSFDx =

max(vDx)

2
- RMS(IDx)

2
P²
= 2.26 | (2.105)
SCSFtotal = 26.36 | (2.106)

Winding Stress Factor

There are here four parts. The three windings on the transformer and the inductor.

W CSFp = 2

< |vp| >²
·RMS(Ip)

2
P²
= 0.92 | (2.107)

W CSFs =

< |vs| >²
·RMS(Is)

2
P²
= 0.92 | (2.108)

W CSFLout =

< |vLout| >²
·RMS(ILout)

2
P²
= 1.16 | (2.109)
W CSFtotal = 3.01 | (2.110)

Capacitor Stress Factor

Input and output capacitors.

CCSFC in =

(vCinpeak )

2
- RMS(ICin)

2
P²
= 1.17 | (2.111)

CCSFC out =

(vCoutpeak )

2
- RMS(ICout)

2
P²
= 0.00 | (2.112)
CCSFtotal = 1.17 | (2.113)

### 2.5.6 Advantages

- Can utilize entire BH-loop
- Can operate at duty cycles close to unity
- Linear conversion ratio M(D)
- Switches are referenced to ground

2.5. Push-Pull Converter (TK) | 31 of 91

### 2.5.7 Disadvantages

- Large transformer due to two set of windings on primary side
- Diodes on secondary side gives losses due to forward voltage drop
- Advanced control is needed to avoid transformer saturation
- Wide duty cycle range for this set of specifications
- Two switches
- High voltages over switches

The issue of forward voltage drop can be reduced by having two secondary windings and only two diodes, not four. But this would result in a larger transformer.

2.6. Summary & Selection (TK, BW, CL & SK) | 32 of 91

## 2.6 Summary & Selection (TK, BW, CL & SK)

### 2.6.1 Influence of Semiconductor Forward Voltage

The forward voltage drop of the diodes results in lowered output voltages for all converters except the Ćuk. This causes the duty cycle to be increased when feedback is applied. Because of this it might be necessary to design the converters with a higher turns ratio n. A conduction voltage in the switches (caused by on-resistance) will have the same effect. Additionally, these effects cause conduction losses of PD = Vf · ID per diode and PSW = I

2
| SW RDSON per switch in the case of a
constant current.

### 2.6.2 Topology Comparison

| Flyback | Sepic | Ćuk | Push-pull
SCSF | 49.87 | 49.58 | 49.4 | 26.36
WCSF | 10.7 | 21.58 | 10.7 | 3.01
CCSF | 4.64 | 4.62 | 4.7 | 1.17
Sum CSF | 65.21 | 75.78 | 64.8 | 30.54
Duty Cycle Range | 22% - 78% | 22% - 78% | 22% - 78% | 7.7% - 92%

Table 2.5: Numerical comparison

From table 2.5 it is seen that the push-pull converter have the drawback of a duty cycle range close to 0 and 100%. This might be hard to realize in practice as the duty cycle depends on load etc. This wide range is caused by the fact that the push-pull is a buck-type converter, and this application is a typical buck-boost application. The push-pull was analyzed anyways, since a correct choice of turns ratio can make a buck-type topology work. Another drawback of the push-pull is that it has one more switch than the other topologies. The reason for the low stress factor is probably that it utilizes the available duty cycle range greatly. This causes many of the RMS currents to become small.
Compared with SEPIC converter, flyback converter has lower component stress factors, and on the other hand, the number of the components in this type of converter is less than Ćuk converter and SEPIC converter. Its main disadvantage is ringing issues.
The SEPIC and Ćuk converters are complex with many components compared to the flyback. The calculations also suggests that their component stress is higher, which suggest a low efficiency. One might argue that the simplified use of CSF, with weighting factor 1, gives topologies with many components an unreasonably bad figure.
One advantage for the SEPIC and Ćuk converters are that they have a capacitor in series with the transformer which removes any DC voltage offset on the windings. This makes it easier to avoid transformer core saturation.
The SEPIC and Ćuk topologies are now disregarded as efficiency is the number one priority in this course. This leaves the flyback and push-pull. And since the push-pull converter has a wide duty cycle range, the flyback is considered the best choice.

# 3 | Magnetic Design (CL, SK, BW &

TK)

In Chapter 2 the Flyback topology was chosen as the best converter for the task at hand. This chapter serves to describe the design process for the transformer, which is the only magnetic component in a Flyback converter. The Flyback transformer functions as both galvanic isolation and energy storage - it’s a coupled inductor. This property complicates the design a bit, as will be obvious in the following sections. Note, as customary in discussions of Flyback converters, we will use the terms coupled inductor and transformer interchangeably throughout this work.

## 3.1 Non-Ideal Circuit Operation

In the previous analysis of the Flyback converter, a simplified ideal circuit operation with no ripple was assumed. For the magnetic design, however, current ripple must be taken into account as this will be a design parameter. Hence, the converter is analyzed once more, and the schematic with definitions of component labels, voltage polarities and current directions is repeated in Fig. 3.1 for

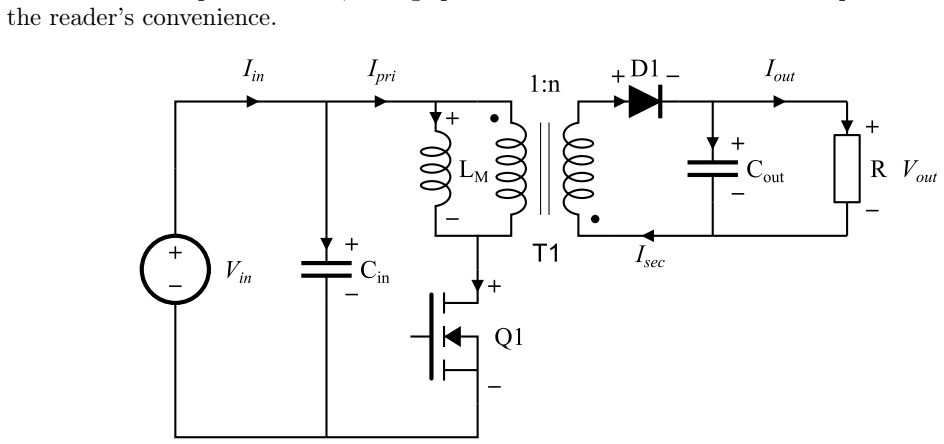
[picture p21: figure]
the reader’s convenience.

Figure 3.1: Flyback converter with definitions of labels, polarities and directions.

With these definitions the circuit operation (voltage and current waveforms) including current ripple is depicted in Fig. 3.3. From the current waveforms of the primary and secondary windings, it can be shown that the magnetic flux density in the coupled inductor behaves according to the waveform in Fig. 3.2.

Figure 3.2: Magnetic flux density in the coupled inductor.

33

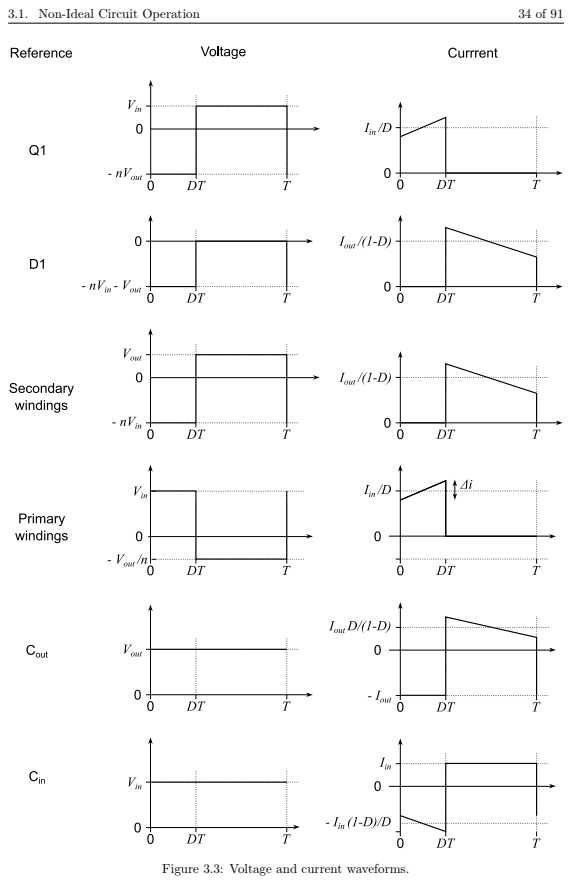
[picture p22: page 41]
3.1. Non-Ideal Circuit Operation

Figure 3.3: Voltage and current waveforms.

3.2. Numerical Solution for Optimal Design | 35 of 91

## 3.2 Numerical Solution for Optimal Design

Design of magnetic components has no obvious optimal design, since most configuration decisions are in practice a trade-off between lowering one cause of losses while increasing another. For instance, increasing core size usually results in room for thicker wires with lower copper loss, while also increasing the cores loss. Likewise, decreasing the number of winding layers leads to fewer losses due to the proximity effect, but also decrease the wire diameter for the same number of turns, which is a cause for increasing losses. Furthermore, the parasitic components of the transformer are highly dependent on physical construction of the device. Hence, choosing the best design (or even just an acceptable one) is a task of evaluation advantages and disadvantages for the specific use case. For this design, we will mainly focus on reducing power loss in the transformer, while keeping in mind that using a physically large core has disadvantages such as increasing production costs and product weight.
To get a good result for the transformer design, it was decided to do a numerical search for the optimal solution to these trade-offs by brute force evaluation of all possible configurations within some predetermined limiting parameters. This evaluation of all solutions was done using MATLAB scripting to handle an arbitrary (and large) amount of configurations, which depends on the chosen design limitations. Throughout the following sections, it is described, how the design theory was implemented in the script, whenever this is relevant for arguing to the validity of the calculations and thereby the comparability of the results.

## 3.3 Core Shape & Material

The core shape of interest was selected based on the following:

- EPCOS recommends the use of U or E-type core shapes for Flyback converters, [1] p. 156.
- Only E-type and RM core shapes are considered in this course.
- The RM, ER and ETD shapes have the advantage of round core centers, which gives most turns per wire length resulting in lower winding losses.

Thus the ETD core shape was selected. Furthermore, the N87 core material was selected, since this is recommended for use in flyback converters where low losses are of high priority, [1] p. 156. The core dependent parameters le, Ae, Ve, µe and Rth as well as coil former window size and center diameter was extracted from the manufacturer’s databook[1] into the MATLAB script for each of the considered cores. The three smallest available ETD cores (29/16/10, 34/17/11 and 39/20/13) were chosen for the analysis to keep the component cost and weight low. Experience from similar analysis of larger cores has shown that increasing cores sizes further has negligible efficiency improvements.
The ETD 29/16/10 is used to exemplify the automated calculations performed for each core. The above mentioned parameters for this core and the appropriate coil former are summarized in Table 3.1 with size definitions as in Fig. 3.4. These parameters are based on the information given in the manufacturer’s databook [1].
le | Ae | Ve | µe | Rth | h | w | cf
70.4 mm | 76 mm² | 5350 mm³ | 1610 | 28 ◦C/W | 19.4 mm | 5 mm | 11.8 mm

Table 3.1: ETD 29/16/10 parameters for N87 material.

3.4. Winding Configuration | 36 of 91

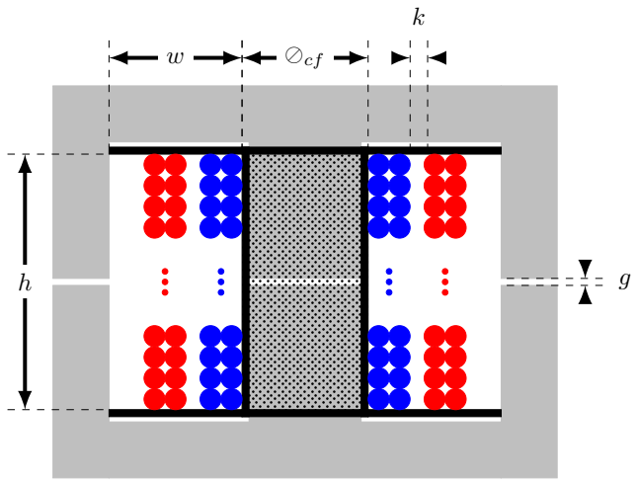
[picture p23: figure]

Figure 3.4: ETD-core and coil former dimension definitions.

Note that the air gap in Fig. 3.4 is identical for all core legs, which is contrary to how gapped cores are usually produced by the manufacturer. This implementation model was used to enable precise air gap sizing by stacking pieces of paper in between the two cores pieces. Hence, we could choose from a large set of gap sizes rather than the restrictive number of configurations offered by the manufacturer. Obviously, this approach is not feasibly for mass production, but it enables an easily automated and thorough first approximation of many designs.

## 3.4 Winding Configuration

### 3.4.1 Minimum Inductance

The range of possible number of primary windings have minimum and maximum bounds respectively determined by: Getting enough inductance to keep the current ripple below a certain point while still avoiding saturation of the core by keeping the flux density below an acceptable level. Based on experience from preliminary and approximating calculations, we were quite certain that adding an air gap the size of a single piece of paper (100 µm thickness) would keep the core from saturating within reasonable limits for winding configurations. Hence, we first addressed the sat-isfaction of minimum inductance requirement, knowing that the configuration chosen based on these findings would subsequently have to be checked against the non-saturation requirement. The design process for the former criteria is outlined in the following.
The minimum inductance needed to keep the primary winding ripple current smaller than some predefined level ∆i (peak to peak) for a certain value of the input voltage, duty cycle and switching frequency is given by eq. 3.2.

VL = L

di(t)
dt = L

∆i
D T
VL=Vin

(3.1)

⇓

L ≥ Vin

D
f ∆i

(3.2)

We wish to design for a ripple factor of 2. Referring to the ∆i definition on the primary winding current waveforms of Fig. 3.3, this criteria leads to eq. 3.3.

3.4. Winding Configuration | 37 of 91
iin,pk = 2 ∆i | (3.3)

Furthermore, eq. 3.4 is derived from the fact that input current must be equal to the primary winding current.

Iin =

1
T

Z D T

0

iin(t) dt +

1
T

Z T

D T

0 dt =

1
T

Z D T

0

iin,pk − ∆i +

∆i
D T
t dt | (3.4)

Substituting eq. 3.3 into eq. 3.4 show that the maximum allowable ∆i to satisfy the ripple ratio criteria (or better) is dependent on the average input current and duty cycle by the relation:

∆imax =

2
3
Iin D | (3.5)

Hence, the ripple current can be determined for a given input/output scenario using the DC conversion ratio and ideal power transfer assumption, eq. 3.6 and 3.7 respectively.

M(D) =

Vout

Vin

=

n D
1 − D

⇔ D =

Vout

Vin n + Vout

(3.6)

Iin =

Vout Iout

Vin

(3.7)

The minimum inductance requirement in eq. 3.2 can now be plotted as a function of the input voltage (assuming maximum output power) to determine the worst case scenario, see figure 3.5.

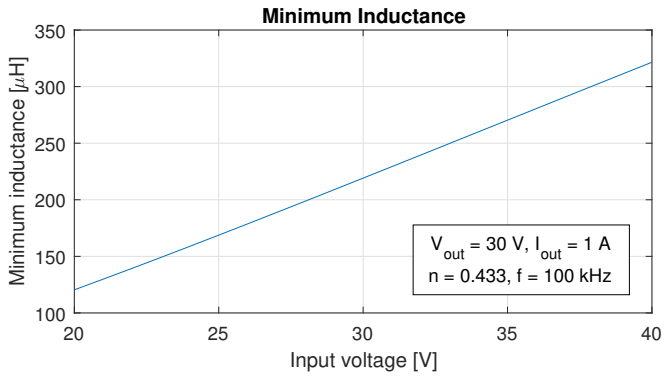
[picture p24: figure]
Input voltage [V]; Minimum inductance [ H]; Minimum Inductance; Vout = 30 V, Iout = 1 A; n = 0.433, f = 100 kHz

Figure 3.5: Minimum inductance to satisfy ripple current ratio.

The worst case value of the inductance is obviously for the input voltage Vin = 40 V. The minimum inductance is calculated by evaluating eq. 3.2 and eq. 3.5 through 3.7 under this condition. Note that the desired turns ratio n = 0.433 (see section 2.1) is assumed in this initial analysis, before the actual turns ratio is decided.

3.4. Winding Configuration | 38 of 91

D40 =

30 V
40 V · 0.433 + 30 V
= 0.63 | (3.8)

Iin,40 =

30 V · 1 A
40 V
= 0.75 A | (3.9)

∆imax =

2
3

0.75 A
0.63
= 0.79 A | (3.10)

⇓

L ≥ 40 V

0.63
100 kHz · 0.79 A = 321 µH | (3.11)

### 3.4.2 Minimum Number of Turns

Next, the goal is to figure out a minimum number of windings that will provide the required inductance. Since the minimum inductance was calculated using primary side current ripple conditions, the number of windings as calculated below must be used to determine the primary winding configuration. The inductance and number of windings are related by reluctance:

L =

N² R | (3.12)

With reluctance as defined in eq. 3.13 and taking into an added air gap, the total reluctance can be calculated by eq. 3.14. In the latter, the magnetic path cross section area of the air gap is assumed to be equal to that of the core by ignoring the fringing effect.

R =

le µe Ae | (3.13)

Rtotal = Rcore + Rgap =

lcore

µcore Acore

+

2 g

µair Acore

(3.14)

For the ETD 29/16/10 core, the total reluctance is evaluated using µair = µ0 = 4 π 10⁻⁷ H/m:

Rtotal =

70.4 mm
1610 · 4 π 10⁻⁷ H/m · 76 mm² +

2 · 100 µm
4 π 10⁻⁷ H/m · 76 mm² = 2.55 · 10⁶ H

−1
(3.15)

Next, this result is validated by comparing with EPCOS’s similarly gapped core [1] p. 518. They have specified the relative effective permeability including air gap as µe = 281 H/m. Solving for permeability in eq. 3.13 leads to eq. 3.16, which can be used to calculate the permeability of our gapped core.

µtotal =

ltotal

Rtotal Acore

=

lcore + 2 g

lcore

µcore Acore

+

2 g

µair Acore!
Acore

=

µair µcore(2 g + lcore)

lcore µair + 2 g µcore

(3.16)

For the ETD 29/16/10 with an air gap of g = 100 µm, the absolute and relative permeability is evaluated in eq. 3.17 and 3.18 respectively.

µtotal =

4 π 10⁻⁷ H/m

2
- 1610 · (2 · 100 µm + 70.4 mm) 70.4 mm · 4 π 10⁻⁷ H/m + 2 · 100 µm · 1610 · 4 π 10⁻⁷H/m
= 364 µH/m | (3.17)

3.4. Winding Configuration | 39 of 91

µr,total =

µtotal
µ0

=

364 µH/m
4 π 10⁻⁷ H/m
= 289.7 | (3.18)

The calculated relative permeability is very close to EPCOS’s value of a similar core construction, and hence it is concluded that the calculated reluctance is correct. Using eq. 3.12 as well as the results in eq. 3.11 and 3.15, the minimum number of primary windings is determined:

Np ≥

q
321 µH · 2.55 · 10⁶ H
−1 = 28.6 | (3.19)

For the subsequent calculations used to exemplify the method, Np = 30 will be used. Furthermore, the number of secondary windings Ns = 13 is used, which results in turns ratio n = 0.433. However, the automated scripted solutions considers all possible number of primary windings from the calculated minimum up to some reasonable limiting value that is manually defined. The range of considered secondary side windings is determined by a specified turns ratio deviation from the desired value, which sets min and max secondary windings as a function of the number of primary windings. Hence, many possible configurations are considered for a large allowable turns ratio deviation, and very few are considered for a strict deviation requirement.

### 3.4.3 Wire Diameters & Lengths

The wire diameters of both primary and secondary side windings has significant influence on the power loss of the transformer. Hence, it is generally desirable to maximize wire diameters, but the size of the coil former window limits the design freedom somewhat as explained in the following. Refer to Fig. 3.4 and table 3.1 for dimension definitions and values for the ETD 29/16/10 core.

In general, the wire diameters are determined by the conditions:

- Each layer of the windings must almost perfectly fill the whole window height (h), i.e. no partially filled layers.
- When all layers are wound on top of each other, there should still be some room left in in the window width (w) to allow for insulation tape between primary and secondary layers (k).
- The majority of the window area should be used for secondary side windings, which has greater current than the primary side windings.

The determination of feasible wire diameter for each core with each considered Np/Ns configuration was carried out using the following method:

1. Assume number of primary and secondary layers.
2. Calculate number of windings per layer. If they cannot be divided equally, reject the current considered configuration as unsuitable.
3. Determine the largest wire diameter incl. insulation that fits inside the window height for both primary and secondary windings. A discrete set of wire diameters is considered (Von Roll, IEC 60317-0-1, grade 1 [2] p. 5).
4. Add up the widths of all layers. If the sum is greater than w − k (i.e. there is not enough room in the window width for windings and insulation tape), reject the current considered configuration as unsuitable.

For the ETD 29/16/10 core with 30 primary windings in 2 layers, 13 windings in 1 secondary layer and kmin = 200 µm, the above method results in the wire diameters:

3.5. Winding Losses | 40 of 91
outer,p = 1.246 mm , cu,p = 1.18 mm | (3.20)
outer,s = 1.468 mm , cu,s = 1.4 mm | (3.21)

The resulting window height and width margins (not considering insulation tape) are:

hmargin,p = 710 µm | (3.22)
hmargin,s = 316 µm | (3.23)
wmargin = 1.04 mm | (3.24)

The copper cross section areas of the selected wires are:

Acu,p = 1.094 mm²
(3.25)
Acu,s = 1.539 mm²
(3.26)

Finally, the winding lengths must be determined for later use in resistance calculations. The insulation tape is not taken into account for this calculation, as its thickness is assumed to have negligible influence. The length of the primary wire is given by eq. 3.27 and evaluated for the ETD 29/16/10 core in eq. 3.28.

lwinding,p =

nlayers,p X

i=1

π (cf + i outer,p)

Np

nlayers,p

(3.27)

lwinding,p =

X

2

i=1

π (11.8 mm + i · 1.246 mm)

30
2
= 128.8 cm | (3.28)

Similarly, the secondary wire length is given by 3.29 and evaluated in eq. 3.30.

lwinding,s =

nlayers,s X

i=1

π (cf + 2 outer,p nlayers,p + i outer,n)

Ns

nlayers,s

(3.29)

lwinding,s =

X

1

i=1

π (11.8 mm + 2 · 1.246 mm · 2 + i · 1.468 mm)

13
1

= 74.5 cm (3.30)

Based on the determined winding configuration as well as wire diameter and length, the transformer’s winding and core losses can be calculated as described in the following sections.

## 3.5 Winding Losses

AC Resistance - Dowell

Dowell’s formula[3] is used to estimate the AC-resistance at the switching frequency (100kHz). Here, the presence of harmonic currents are ignored.
Dowell’s formula gives an estimate based on the number of layers p and ϕ. ϕ is the ratio between foil thickness and skin depth. But as round wires are to be used, the ϕ must be modified[3]. The following expression is then found.

3.5. Winding Losses | 41 of 91

Dowell(ϕ, p) = ϕ ·

sinh(2ϕ) + sin(2ϕ)
cosh(2ϕ) − cos(2ϕ)

+

2(p

2 − 1)

3

sinh(ϕ) − sin(ϕ)
cosh(ϕ) + cos(ϕ)

!
(3.31)
RAC = Dowell(ϕ, p) · RDC | (3.32)

ϕ =

√η ·

r
π
4

δ

(3.33)

η =

r
π
4
- · nwindings per layer

h

(3.34)

RDC =

lwire · ρ

Awire

(3.35)

Here is the copper wire diameter, η is the porosity factor, delta is the skin depth, Awire is the wire cross section area, hwindow is the height of the magnetic window and lwire is the length of the winding. This is calculated for both the primary side and the secondary side winding. The resistivity is ρ = 1.68 · 10⁻⁸Ω m (copper at 20◦C). The length and wire areas are given in eq. 3.25 to 3.30. The skin depth at 100kHz is 237µm.
The resistances for both windings are now found

RDCp =

128.8 cm · 1.68 · 10⁻⁸Ω m
1.094 mm² | = 19.8mΩ | (3.36)

RDCs =

74.5 cm · 1.68 · 10⁻⁸Ω m
1.539 mm² | = 8.13mΩ | (3.37)

ηp =

r
π
4
- 1.18 mm · 2

19.4mm

= 0.809 | (3.38)

ηs =

r
π
4
- 1.40 mm · 1

19.4mm

= 0.831 | (3.39)

ϕp =

√
0.809 ·

r
π
4
- 1.18 mm

237µm

= 3.97 | (3.40)

ϕs =

√
0.831 ·

r
π
4
- 1.40 mm

237µm

= 4.77 | (3.41)
RACp = Dowell(3.97, 2) · 19.8mΩ = 12.3 · 19.8mΩ = 244mΩ | (3.42)
RACs = Dowell(4.77, 1) · 8.13mΩ = 4.77 · 8.13mΩ = 38.8mΩ | (3.43)

RMS currents

The maximum losses are in the case of the biggest inductor currents and output power which is at 20V in and 30V out. The winding loss is the sum of the DC and AC loss for both sides. The DC current is the average current in the winding. iDCp = iin = 1.5A, and iDCs = iout = 1A.
The AC current is found by using the following relationship:

i

2
RMS = i

2
DC + i
2 ACRMS | (3.44)
m

iACRMS =

p
i

2
RMS − i

2
DC | (3.45)

The DC currents are known as the input current on the primary side and the output current on the secondary side. The total RMS current is found by calculating the root mean square of the

3.5. Winding Losses | 42 of 91

signal over a period, where it is changing with a ripple current subtracted from the peak current. The expression is simplified as the peak current where the ripple current is substracted during the on period for both sides, as this gives the same RMS as the actual waveform but is a simpler expression. The expressions for the peak current and ripple current are described in subsection 3.7.2.

ip,RMS =

### vuut

1
T

Z DT

0

ip,pk −

∆ip
DT
- t

!
dt | (3.46)

is,RMS =

### vuut

1
T

Z (1−D)T

0

ip,pk
n

−

∆ip
n(1 − D)T
- t

!
dt | (3.47)

Using equation 3.46 and 3.47 in equation 3.45 with the known DC currents the AC rms currents can be calculated for the primary side:

iACp,RMS =

1
6

s
3(D⁴T

2Vin + 12I

2

inLm, p²
)
L²

m,pn²D²

− 36I

2
in | (3.48)

=

1
6

s
3(0.78⁴
- (10µs)²
- 20V + 12(1.5A)²
- (352µH)²
)
(352µH)² · 0.78²
− 36(1A)² = 0.814A | (3.49)

Similarly the iACRMS is calculated for the secondary side.

iACs,RMS =

1
6

s
3(1 − D)(D⁴T

2Vin + 12I

2
inLm, p²
)
L²

m,pn²D²

− 36I

2
out | (3.50)

=

1
6

s
3(1 − 0.78)(0.78⁴
- (10µs)²
- 20V + 12(1.5A)²
- (352µH)²
)
(352µH)² · 0.43² · 0.78²

− 36(1A)² = 1.865A (3.51)

Calculation of Winding Loss

The winding loss is then estimated by the sum of the AC and DC losses in the primary and secondary side.

Pwinding = PDC,p + PAC,p + PDC,s + PAC,s | (3.52)

Pwinding = RDC,p · i

2
DC,p + RAC,p · i

2
RMSAC,p + RDC,s · i

2
DC,s + RAC,s · i

2
RMSAC,s
= 19.8mΩ · (1.5A)² + 244mΩ · (0.814A)² + 8.13mΩ · (1A)² + 38.8mΩ · (1.865A)²
= 349mW | (3.53)

3.6. Core Losses | 43 of 91

## 3.6 Core Losses

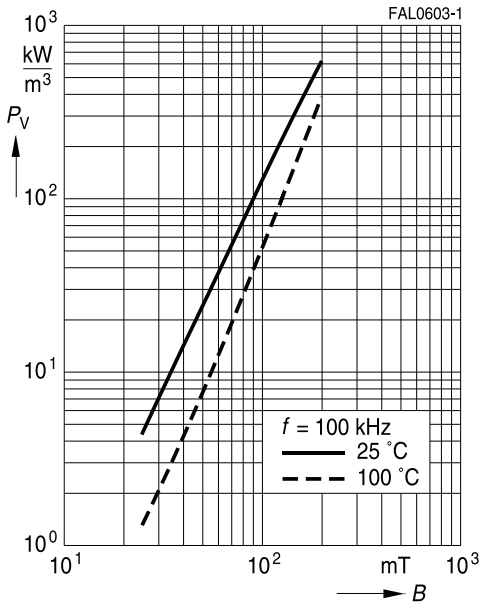
[picture p25: figure]

Figure 3.6: Relative core losses versus AC field flux density for N87, [1] p. 83.

The worst case scenario of 25 degrees is used and regression is performed on the solid line in Fig.
3.6. This give the following formula for core losses.

Pc = 34 · 10⁶ Ve ∆B

2.42
max | (3.54)

Here, Ve is the effective volume of the core.

For the selected design: ∆ip =

20V
352µH
- 0.776 · 10⁻⁵
s = 0.441A (formula explained in subsection

3.7.2). This gives:

∆B =

Np · ∆ip · µ

ltotal

=

30 · 0.441A · 290 · 4π · 10⁻⁷

70.6mm

= 68.0mT | (3.55)

Pc = 34 · 10⁶

- 5350mm³
- (68.0mT)².42 | (3.56)
Pc = 272mW | (3.57)

This gives a total loss for the coupled inductor and a temperature of:

Pmagnetic = Pc + Pw = 272mW + 349mW = 621mW | (3.58)
Tinductor = Ta + Pmagnetic · Rth = 25◦C + 621mW · 28◦C/W | (3.59)

Tinductor = 43.4

◦C | (3.60)

## 3.7 Selection of Core & Configuration

Determination of realizable winding configurations, winding losses and core losses was determined for several ETD-cores using an automated script as exemplified in the previous sections of this chapter. Table 3.2 summarizes the conditions under which the analysis was performed.

3.7. Selection of Core & Configuration | 44 of 91
Primary layers | 2
Secondary layers | 1
Max primary windings | 32
Air gap (each leg) | 100 µm
Ideal turns ratio | 0.433
Max turns ratio deviation | 0.033
Primary/secondary insulation | 200 µm

Table 3.2: Conditions for determination of transformer configuration.

The resulting total power loss for each of the considered cores is plotted for varying winding configurations in Fig. 3.7. Another analysis of the ETD-cores was performed with doubled air gap and similar calculations were performed for several E-cores (taking into account the different physical construction of these core). Plots from these other analyses can be found in Appendix A

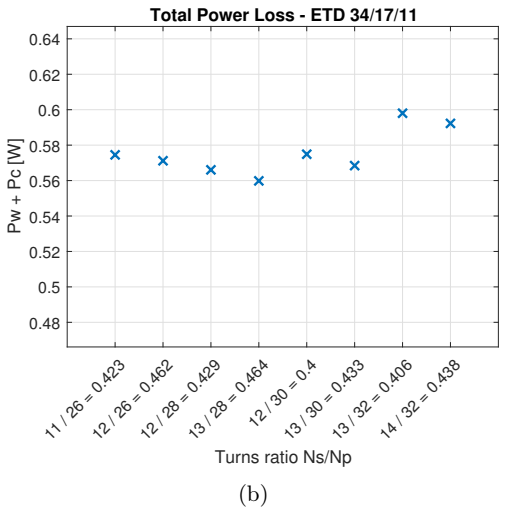
[picture p26: figure]
Turns ratio Ns/Np; Total Power Loss - ETD 34/17/11
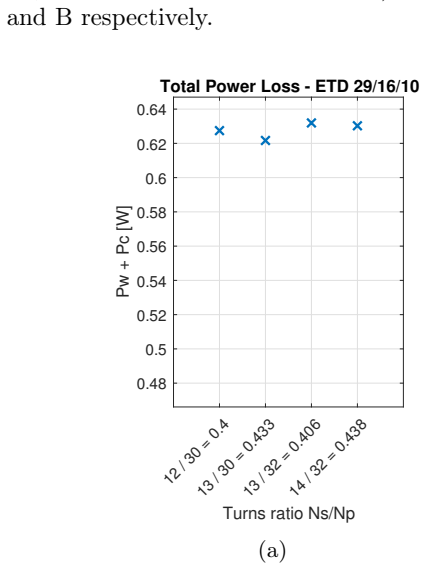
[picture p27: figure]
and B respectively.; Turns ratio Ns/Np; Total Power Loss - ETD 29/16/10
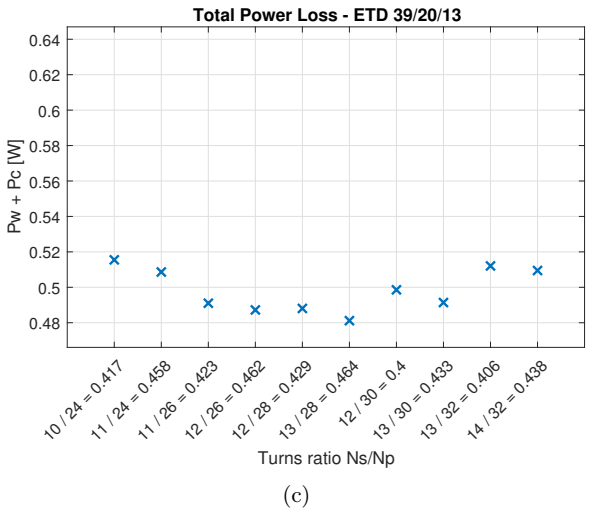
[picture p28: figure]
Turns ratio Ns/Np; Total Power Loss - ETD 39/20/13

Figure 3.7: Realizable ETD-core configurations with 2 primary layers.

3.7. Selection of Core & Configuration | 45 of 91

From Fig. 3.7 it is obvious that increased core size reduces losses. Similar behaviour is observed for the results of the other analyses in appendix A and B. However, efficiency is not the only parameter of importance in the process of selecting the transformer core. It must also be noted that the larger cores has disadvantages such as increased production cost as well as product volume and weight. Hence, since the difference between the lowest power loss of the largest and smallest considered ETD-cores is only around 140 mW, which is less than 0.5 % of the max output power, the disadvantages of a large core is deemed to be of greater importance. Therefore, the ETD 29/16/10 with 30 primary windings and 13 secondary windings is chosen for the transformer. This design is shown in Fig. 3.8. The illustration is taken from ANSYS PEmag were the correct core, bobbin, and wire sizes are selected. This confirms that the calculations regarding size are correct.

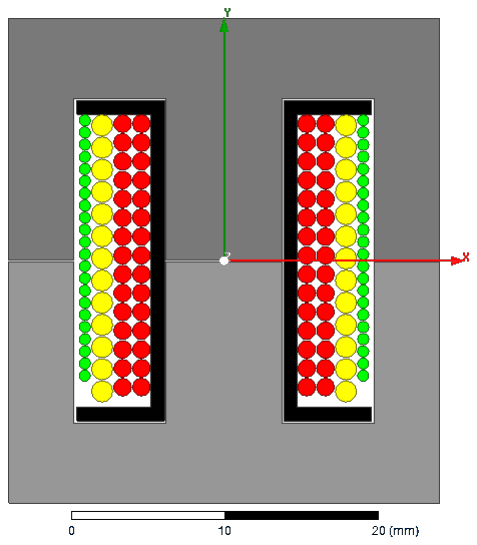
[picture p29: figure]

Figure 3.8: Cross section transformer. Grey: Core, Black: Bobbin, Red: Primary windings, Yellow: Secondary windings, green: tertiary windings

Note: The tertiary winding in this illustration is explained in section 5.4.1 in the control chapter.

### 3.7.1 Resulting Inductance

Eq. (3.11) gives a minimum inductance of 321 µH. Using the relation from eq. (3.12) and the calculated reluctance from eq. (3.15) the actual primary side magnetizing inductance can be found:

Lm p =

N²
p
Rtotal

=

30²
2.55 · 10⁶ H⁻¹

(3.61)

Lm p = 352µH | (3.62)

3.7. Selection of Core & Configuration | 46 of 91

### 3.7.2 Avoidance of Saturation

Primary Side Peak Current

The peak current at the primary side is found by assuming Pin = Vin and that the shape of this current is a square with a triangle on top:

Iin =

Vout · Iout

Vin

| (3.63)

Ip,pk =

Iin
D
+ ∆ip | (3.64)

∆ip =

Vin

Lm,p

- D · T | (3.65)
m | (3.66)

Ip,pk =

Vout · Iout
D · Vin

+

Vin

Lm,p

- D · T | (3.67)
| (3.68)

Furthermore, the relation D =

Vout

n · Vin + Vout

is used. The worst case is now calculated:

D =

30V
0.433 · 20V + 30V
= 0.776 | (3.69)

Ip,pk =

30V · 1A
0.776 · 20V

+

20V
352µH
- 0.776 · 10⁻⁵
s | (3.70)
Ip,pk = 2.37A | (3.71)

Peak Magnetic Flux Density

The maximum allowable peak magnetic flux density is found by looking at the figures below. This shows the saturation of the core. As shown earlier, the transformer losses only cause a small temperature rise. This makes it most relevant to look at the 25 ◦C.

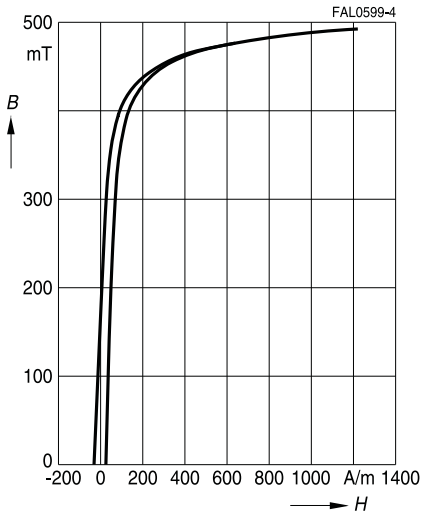
[picture p30: figure]

(a) 10 kHz, 25 ◦C

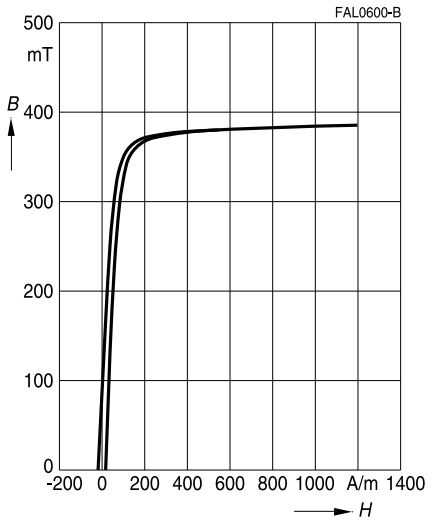
[picture p31: figure]

(b) 10 kHz, 100 ◦C

Figure 3.9: Magnetization curves for N87, [1] p. 82.

3.8. Summary | 47 of 91

The peak magnetic flux density Bpk is found by using the effective permeability and the peak current:

Bp,k =

Np · Ip,pk · µtotal

ltotal

(3.72)

Where ltotal = 70.4mm is the magnetic length of the transformer.

Bp,k =

30 · 2.37A · 289 · 4π · 10⁻⁷H/m

70.4mm

(3.73)

Bp,k = 365mT | (3.74)

By looking at Fig. 3.9a it is seen that the worst case of 365mT still is less than what is required to saturate the core.

## 3.8 Summary

The selected design uses a TDK EPCOS 29/16/10 N87 core with a turns ratio of 30 : 13 : 22 (n = 0.433). The number of layers for each winding is 2:1:1.
With the chosen design, the magnetic flux density reaches a worst case peak value of 365mT which gives a margin to avoid saturation. The inductor power dissipation of 621mW results in a core temperature of 43.4

◦C which is far below it’s temperature rating. The primary side magnetizing inductance is Lm p = 352µH.

# 4 | Filter Design

## 4.1 Introduction (CL, SK, BW & TK)

In order to attenuate the switching harmonics and eliminate the ripples, input and output filters need to be added to the converter. The converter must meet the specifications of the introduction also repeated here.

| Condition | Minimum | Maximum
Vin | - | 20 V | 40 V
Vout | - | 5 V | 30 V
Iout | - | - | 1 A
∆Voutmax | Steady state | - | 50mV
∆Voutmax | Load step | - | 3 % of Vout
Input current harmonics | Steady state | - | CISPR 13 average
Inrush current spike | - | - | ETSI EN 300132-2

Table 4.1: Converter Specifications.

The transformer parameters in table 4.2 was determined from the magnetic design in Chapter 3.

Parameter | Symbol | Value
Number of primary side turns | Np | 30*
Number of secondary side turns | Ns | 13*
Turns ratio | n | 0.433*
Primary side inductance | LMp
| | | 352 µH*
Secondary side inductance | LMs
| | | 66 µH*

Table 4.2: Summary of transformer parameters.

*These are the values of the final design however some simulations prior to this decision was made with the values Np = 26, Ns = 12, n = 0.462, LMp = 264.9µH and LMs = 56.4µH.

The following figure shows the placement of the inrush limiting circuit, input filter and output

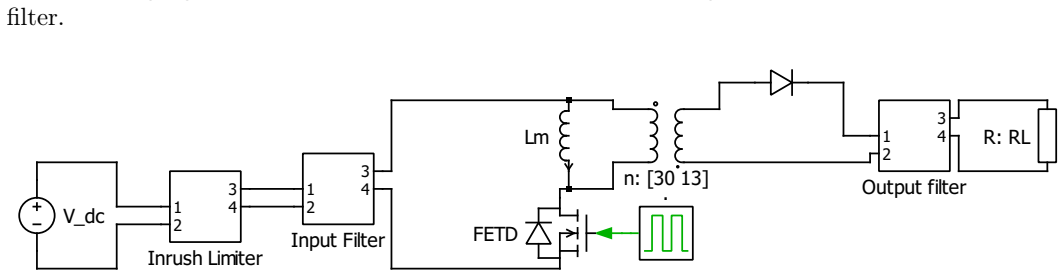
[picture p32: figure]
filter.; FETD; Inrush Limiter; Input Filter; Output filter

Figure 4.1: Filter design overview

48

4.2. Output Filter (CL, SK, BW & TK) | 49 of 91

## 4.2 Output Filter (CL, SK, BW & TK)

Normally, the only design parameters in the output filter of a flyback converter are the output capacitance and its ESR. But in this case it might be necessary with an extra filter due to the strict output ripple limitation.

### 4.2.1 Steady State Ripple

The steady state voltage ripple is caused by both the charging and discharging of the output capacitance and the corresponding current going through its ESR. First the minimum capacitance is found, then the maximum ESR. Since the ripple voltage is the sum of the two components, the implemented design must be stricter than these individual calculated restrictions.

∆vout = ∆voutC + ∆voutESR | (4.1)

The output capacitor supplies the output with current when the diode is reverse biased. Thus, in the interval 0 < t < DT, the capacitor current is −Iout. Using the following equation, an expression for the minimum output capacitance is found.

∆voutC =

1

Cout Z DT

0

iCout dt | (4.2)

In our case, ∆Vmax = 50 mV. And iCout = −Iout when the diode is reverse biased (0 < t < DT). These values are set into (4.2) and it is solved for the capacitance. The expression for minimum capacitance is given below.

Cmin =

Iout · D
∆V · fs

=

1A · 0.765
50mV · 100kHz = 153µF | (4.3)

The maximum ESR can be found by using the peak to peak ripple current going through the outpu capacitor.

∆voutESR = Ip2p Cout · ESR | (4.4)

The peak to peak current in the capacitor is the same as the peak to peak current in the output diode. This is valid when assuming a constant load current. By looking at the diode current shape it can be seen that:

Ip2p Cout = Ip2p Diode =

Iout
1 − D

+

1
2

Vout

Lms

- (1 − D)T | (4.5)

This gives a worst case scenario of Ip2p Cout = 5.0A (validated by simulating). Combining this with equation (4.4) gives a maximum ESR of:

ESRmax = 10mΩ | (4.6)

### 4.2.2 Loadstep Consideration

In the load step, the output current instantly changes from 1 A to 0.5 A. The voltage overshoot is calculated based on the fact that the total stored energy cannot change instantly, and hence the energy of the inductor must be transferred to the capacitor, when the output current is halved. The inductor peak current is used as a worst case scenario.

4.2. Output Filter (CL, SK, BW & TK) | 50 of 91

Before step:

ET OT = EC + EL =

1
2
- Cout · Vout

2 +

1
2
- Ls · Ipks

2
(4.7)

After step:

ET OT⁰ = EC⁰ + EL⁰ =

1
2
- Cout · (Vout + Vov)

2 +

1
2
- Ls · (Ipks −

1
2
- Iout)

2
(4.8)

According to previous report:

Ipks =

Iout
1 − D

+

Vout · (1 − D)
2 · Ls · fs | (4.9)
Ls = 56.4 µH | (4.10)

With a restriction of Vov = 3% · Vout the minimum value of Cout can be derived.

Coutmin =

LsIout ·

4Iout
1 − D

−

2Vout(1 − D)
Ls · fs

+ Iout!

4Vov(2Vout + Vov

) | (4.11)

Here, the duty cycle is a function of the voltages. This expression for the capacitance is plotted for the ranges of input and output voltages in Fig. 4.2.

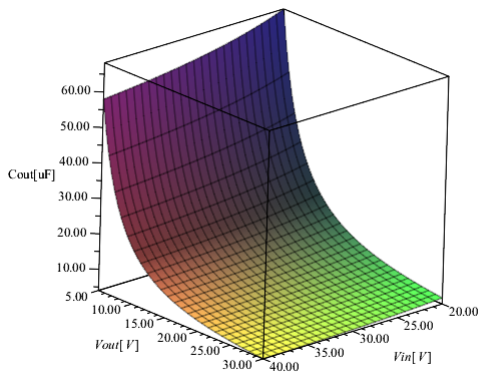
[picture p33: figure]

Figure 4.2: Minimum output capacitance, Coutmin [µF], as a function of Vin and Vout.

As seen in figure 4.2, the worst case design situation, which has the largest necessary output capacitor requirement, occurs for the conditions Vin = 20 V, Vout = 5 V, where D = 0.35 Hence, the minimum output capacitance is:

Coutmin =

56.4µH · 1A ·

4 · 1A
1 − 0.35

−

2 · 5V(1 − 0.35)

56.4µH · 100kHz + 1A!

4 · 0.15V(2 · 5V + 0.15V) | = 58.5µF | (4.12)

4.3. Input Filter (CL, SK & TK) | 51 of 91

### 4.2.3 Equivalent Series Resistance Calculation

The maximum ESR for a loadstep from from 100% to 50% is obtained from the maximum voltage overshoot and the current change in the secondary winding.

ESRmax =

Vov Ioutstep change
=
0.03 · Vout Ipks − 0.5Ioutmax | (4.13)

The maximum ESR is obtained when Vin = 40V and Vout = 30V :

ESRmax =

0.15V
3.68A − 0.5 · 1A = 287mΩ | (4.14)

It is seen that this ESR requirement is less strict than the steady state requirement.

### 4.2.4 Output Capacitor Selection

Based on this, six parallel connected 50V, 405mA rated Panasonic 56µF electrolytic capacitors[4] are chosen. This gives an ESR of 67mΩ and a current rating of 2.43A as the calculations below show:

ESReach =

tan(δ)

2πfdatasheetCout

=

0.10
2π · 120Hz · 330µF
= 400mΩ | (4.15)

ESRout1 =

ESReach
6

=

400mΩ
6
= 67mΩ | (4.16)
Icapabillity = 6 · Irated each = 6 · 405mA = 2.43A | (4.17)

The ESR requirement of 10mΩ is difficult to satisfy with electrolytic capacitors only. Therefore an extra second order filter is added at the output. It is placed sufficiently low in frequency so that it gives around 20dB of attenuation.

Cout2 = 122µF (2 × 56µF (electrolytic) + 10µF (ceramic)) | (4.18)
Lout2 = 2.2µH | (4.19)
ESRout2 = 200mΩ | (4.20)

At the end of this chapter, the RMS currents in the capacitors will be simulated and compared to their current ratings. This extra second order filter is assumed to not alter the input characteristics noticeably, and is therefore not considered in the rest of this chapter.

## 4.3 Input Filter (CL, SK & TK)

### 4.3.1 Simulated Input Harmonics

The conducted EMI is investigated by simulating the flyback converter in PLECS and measuring the input current. First simulations is done without an input filter. See Fig. 4.3. This simulation is done for all four corner cases as listed in table 4.3.

Case | Vin | Vout | Iout | D
1 | 20V | 30V | 1A | 0.76
2 | 40V | 30V | 1A | 0.62
3 | 40V | 5V | 1A | 0.21
4 | 20V | 5V | 1A | 0.35

Table 4.3: The four corner cases of operation

4.3. Input Filter (CL, SK & TK) | 52 of 91

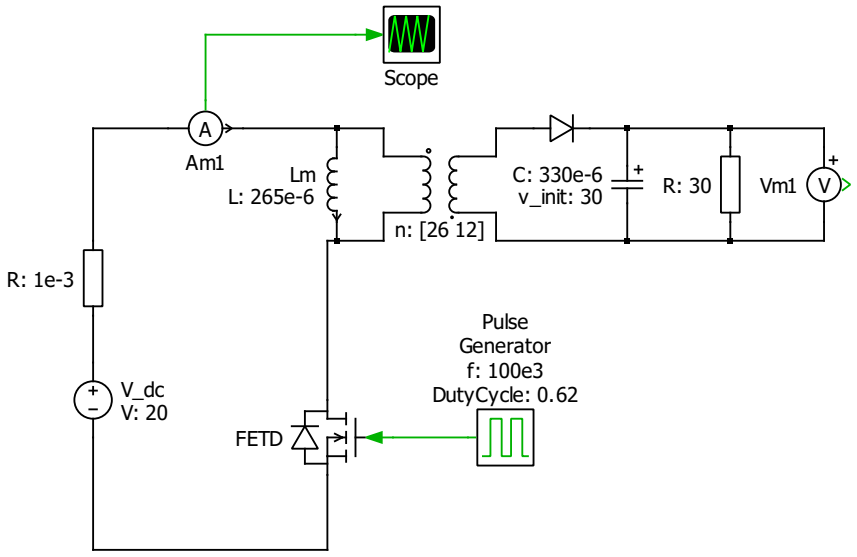
[picture p34: figure]
C: 330e-6 v_init: 30; Pulse; Generator f: 100e3 DutyCycle: 0.62; FETD; Scope

Figure 4.3: PLECS simulation setup. Without input filter.

The current simulation results is exported to MATLAB where a FFT is performed. The time sample is 0.1µs long, which results in a spectral resolution of 10kHz. This is more than sufficient as the fundamental frequency is ten times as large. Now the current is converted to dB µV. This is done to simulate a LISN network measurement. The following formula is used.

VLISN = 20 · log10(|Iin| ·

50Ω
1µV
) | (4.21)

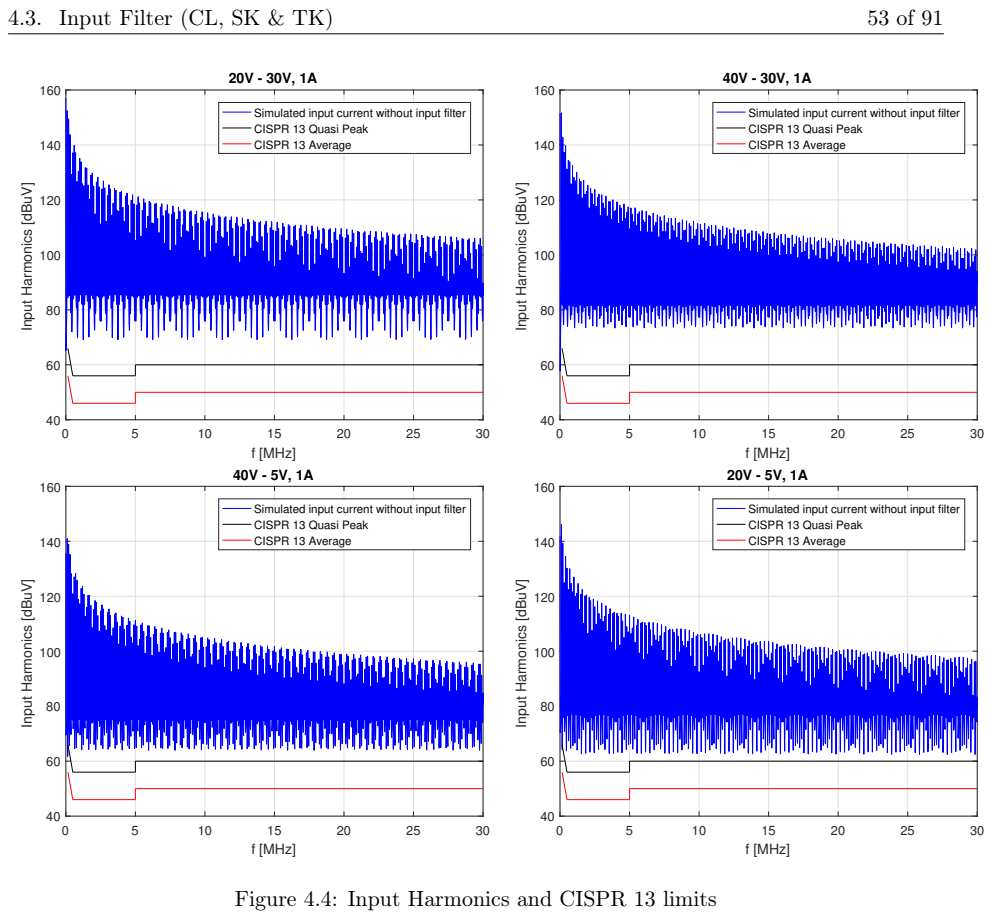
[picture p35: page 60]
4.3. Input Filter (CL, SK & TK); f [MHz]

Simulated input current without input filter
CISPR 13 Quasi Peak
CISPR 13 Average

Input Harmonics [dBuV]

Figure 4.4: Input Harmonics and CISPR 13 limits

4.3. Input Filter (CL, SK & TK) | 54 of 91

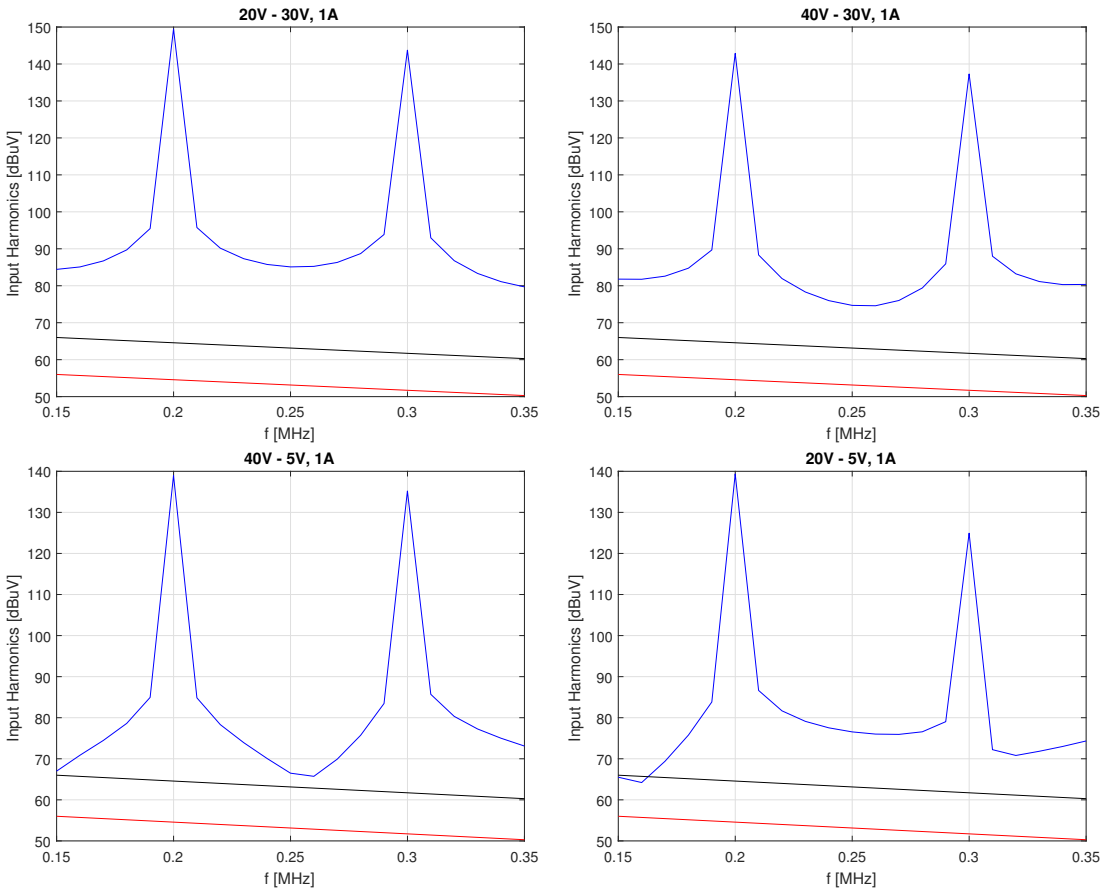
[picture p36: figure]
f [MHz]; Input Harmonics [dBuV]

Figure 4.5: Input Harmonics and CISPR 13 limits, zoomed in at the second and third harmonics. Same colors as previous figure.

It is obvious that the input side must have a filter in order to meet the CISPR 13 limits. The worst violation is at the second harmonic (200kHz) for the first case. As seen in the first part of Fig. 4.5, a damping of 149.5dB − 54.5dB = 95dB is required.

### 4.3.2 Designing the filter

Undamped Filter

Three second order low pass filters are cascaded in order to achieve enough dampening. One second-order filter can achieve 40dB dampening per decade but by placing the cut-off frequency at very low frequency requires very big components so it was decided that cascading several would be a better choice.
It is the current from the converter to the source that requires dampening. The transfer function of this is equal to the voltage transfer function from the source (the opposite way).
The first filter from the left has the highest cut-off frequency because then the gain and phase of a signal at lower frequency is approximately unchanged. However this is just a simplification for placing the designing the component values, as there is current flowing in between the second-order filters their transfer functions cannot be cascaded and need to calculated for the entire filter. But resonances of the sixth-order filter is made by cascading three second-order filters with descending cut-off frequency spaced sufficiently apart to lower the affect they have on each other.

4.3. Input Filter (CL, SK & TK) | 55 of 91

As mentioned a damping of 95dB is required at 200kHz. If this requirement is fulfilled the nature of the filter also satisfies all other requirements of dampening, as higher frequencies are damped more and the required damping from 150kHz to 200kHz are low.
The cutoff frequency of the individual second-order filters are 10⁰.5 apart. The first filter is designed to give roughly 60dB attenuation the second filter to give 40dB attenuation and the the 3rd filter 20dB attenuation. This should give enough attenuation for the overall filter.

Damped Filter

Rf - Lb parallel damping is chosen as it requires smaller components than Rf - Cb damping[5](chapter 10.4).
Filter 0 | Filter 1 | Filter 2

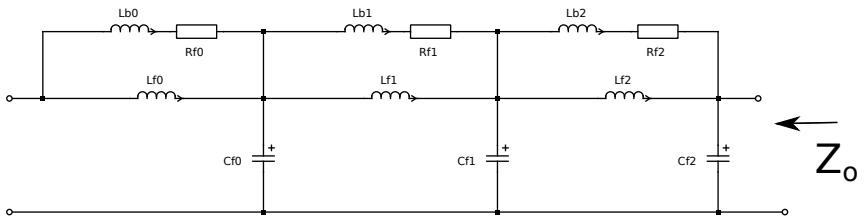
[picture p37: figure]

Figure 4.6: Input filter topology

Now, the stability of the filter is investigated. The output impedance of the filter must be meet Middlebrooks’s impedance inequalities.

||Zo|| ||ZD|| | (4.22)
||Zo|| ||ZN || | (4.23)

While the output impedance is calculated by shorting the input side of the filter, ZN and ZD is found from the small signal model of the Flyback converter. This model is given in Erickson[5]. Repeated here for convenience:

Figure 4.7: Small signal model of the Flyback converter

All components, currents and voltages is transformed into the middle of this converter in order to remove the transformers. Furthermore, the on-resistance of the switch is neglected. ZD is now found as the input impedance with the duty cycle perturbation ˆd set to zero. ZN is found as the input impedance when ˆd is adjusted such that the output perturbation vˆ is zero. These impedances were found by solving KVL and KCL equations.

ZD =

D⁰²
- RL
D²(1 + s · RL · Cout)

(

1
n²

+ s ·

LMp
D⁰²RL

+ s

2

LMp

- Cout
D⁰²
) | (4.24)

ZN = −

RL · D⁰²
D²

(

1
n²

− s ·

D · LMp
RL · D⁰²
) | (4.25)

4.3. Input Filter (CL, SK & TK) | 56 of 91

These expressions fits with the expression for the Buck-Boost converter[5] when the turns ratio is set to n = 1.
When damping the filter there is a trade-off between the amount of damping and the degradation of the HF attenuation of the filter. The following procedure is used to obtain the optimal damping (selecting Lb and Rf according to section 10.4.2 in Erickson). This is done for all three filters separately. Then the stability is analyzed for the combined filter.
1. Finding the lowest of ZN and ZD at the resonance frequency of the undamped filter.
2. Setting maximum impedance, ||Zo||mm, 20dB lower than this to achieve a margin.
3. Calculating n =

Lb
Lf

according to eq. 10.35 and 10.26 in Erickson.

4. Setting Lb = n · Lf
5. Calculating the optimal Rf0 from eq. 10.37 in Erickson.

ZN and ZD are plotted for the four corner cases as they are affected by the duty cycle. The following plots show the stability analysis for the three filters.

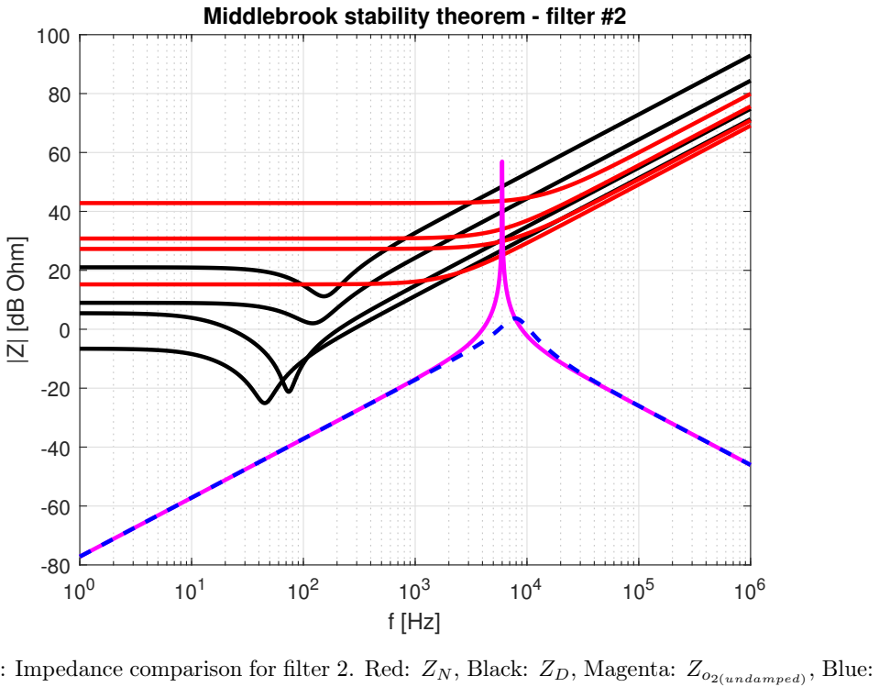
[picture p38: figure]
|Z| [dB Ohm]; , Blue:

Middlebrook stability theorem - filter #2

Figure 4.8: Impedance comparison for filter 2. Red: ZN , Black: ZD, Magenta: Zo2(undamped) Zo2

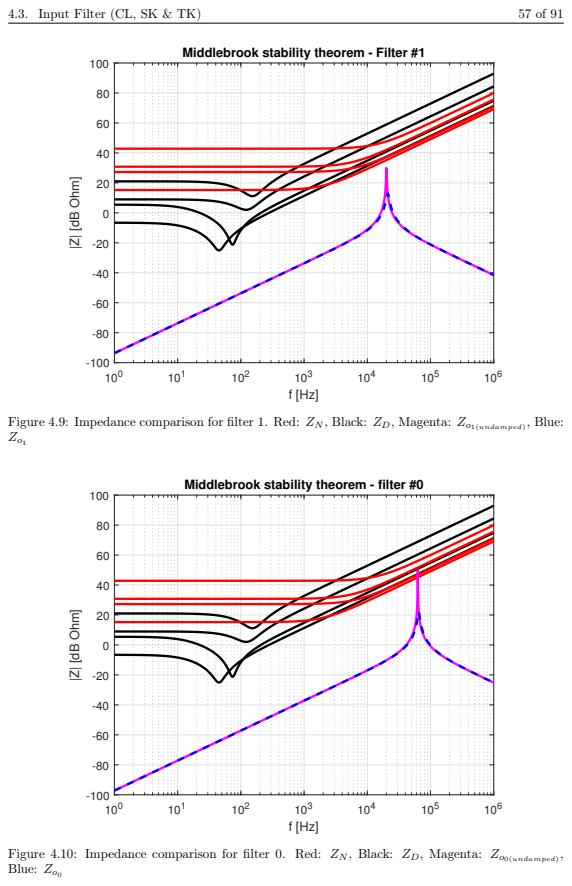
[picture p39: page 64]
4.3. Input Filter (CL, SK & TK); |Z| [dB Ohm]; , Blue:

Middlebrook stability theorem - Filter #1

Figure 4.9: Impedance comparison for filter 1. Red: ZN , Black: ZD, Magenta: Zo1(undamped)

Middlebrook stability theorem - filter #0

Figure 4.10: Impedance comparison for filter 0. Red: ZN , Black: ZD, Magenta: Zo0(undamped)
Blue: Zo0

4.3. Input Filter (CL, SK & TK) | 58 of 91

### 4.3.3 Validation of the Filter

Stability

The combined filter (filter 2, filter 1 and filter 0 cascaded) output impedance is now used to check

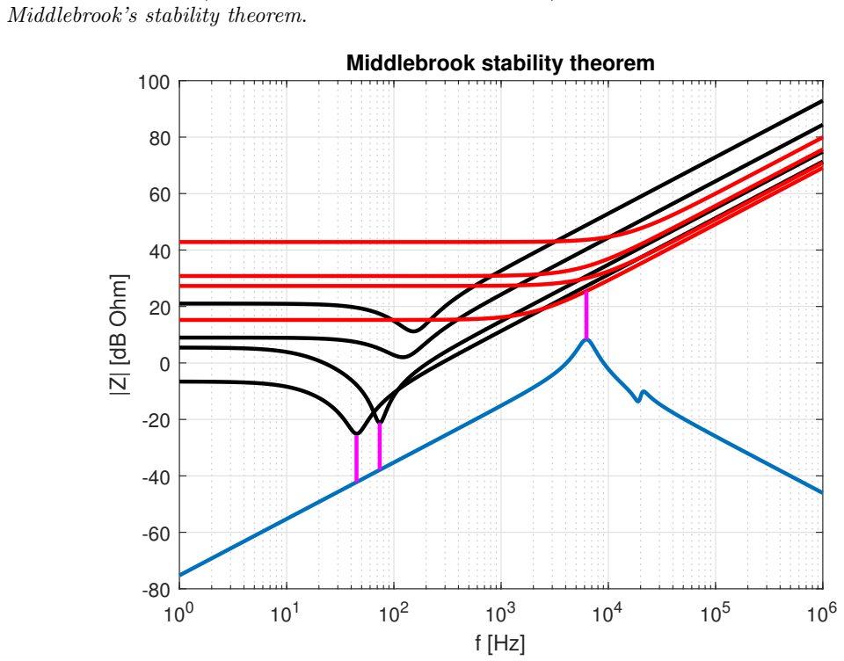
[picture p40: figure]
Middlebrook’s stability theorem.; |Z| [dB Ohm]; Middlebrook stability theorem

Figure 4.11: Impedance comparison for entire filter. Red: ZN , Black: ZD, Blue: Zo, Magenta: Margins

Fig. 4.11 shows the stability margins. They are 16.6dB, 16.5dB and 17.1dB from left to right.

Calculated Harmonics Damping

The transfer function of the designed filter is now calculated without using the independent filter assumption. Its gain and phase are plotted below.

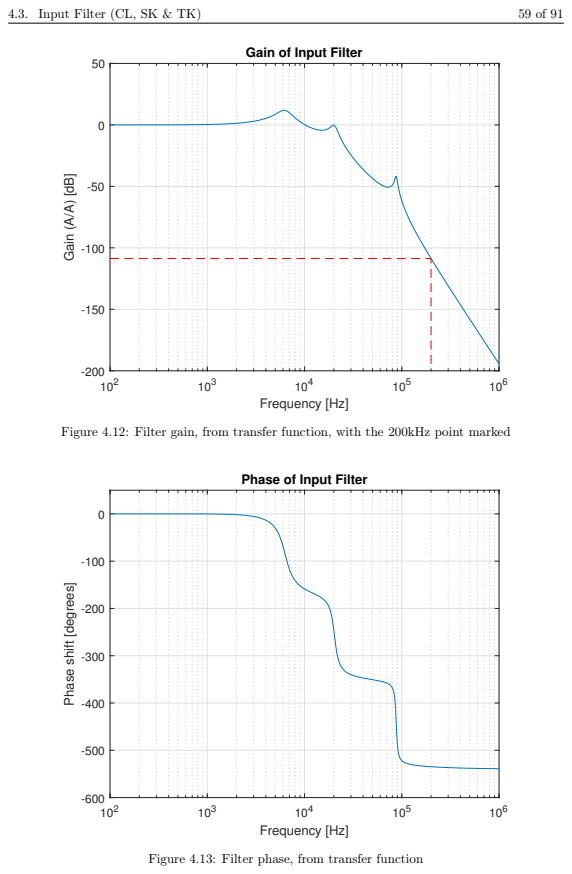
[picture p41: page 66]
4.3. Input Filter (CL, SK & TK); Frequency [Hz]; Gain (A/A) [dB]

Gain of Input Filter

Figure 4.12: Filter gain, from transfer function, with the 200kHz point marked

Phase of Input Filter

Phase shift [degrees]

Figure 4.13: Filter phase, from transfer function

4.3. Input Filter (CL, SK & TK) | 60 of 91

From this it is seen that the attenuation at 200kHz is 108.6dB which is more than the required 95dB.

Simulated Harmonics Damping

The input filter is now added to the PLECS simulation. The harmonics are measured the same way as without the filter. Fig. 4.14 show the simulation setup.

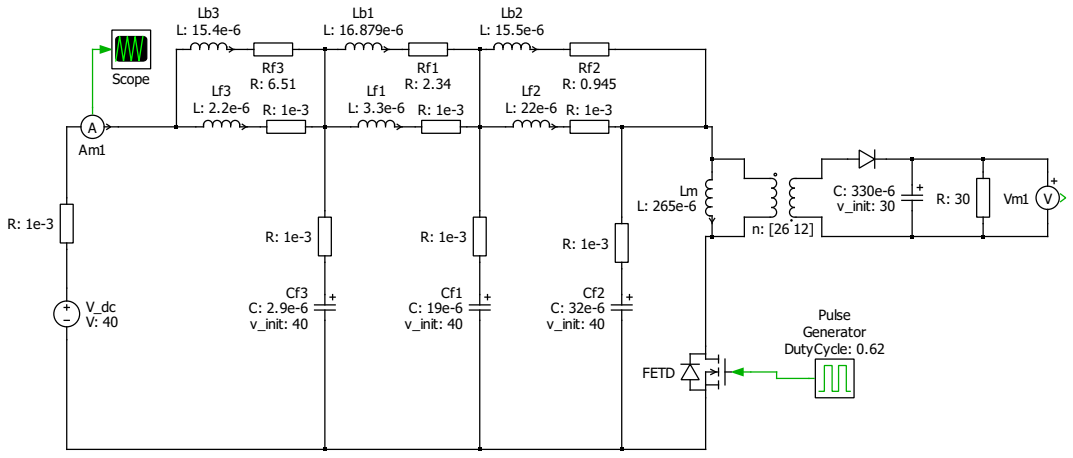
[picture p42: figure]
v_init: 30; Pulse; Generator DutyCycle: 0.62; FETD; Scope; Cf1 C: 19e-6 v_init: 40; Cf2 C: 32e-6 v_init: 40; Cf3 C: 2.9e-6 v_init: 40

Figure 4.14: PLECS simulation setup with input filter.

The simulations results are shown in the following two figures.

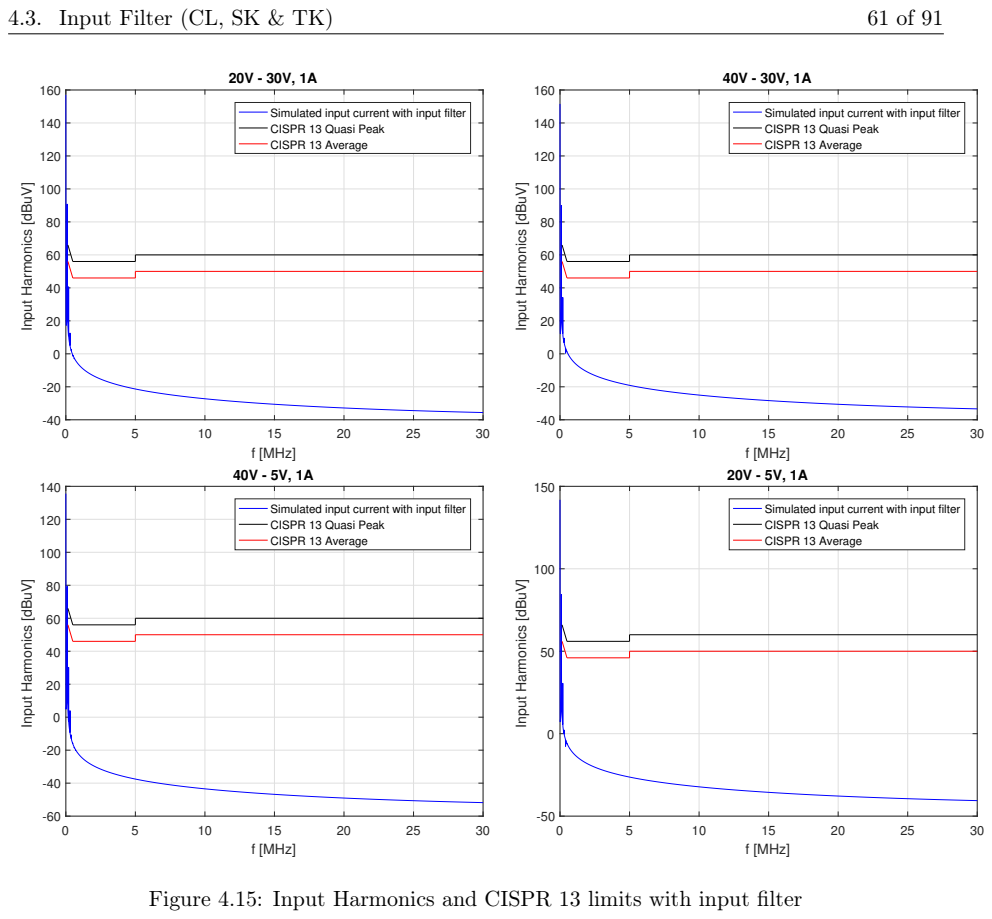
[picture p43: page 68]
4.3. Input Filter (CL, SK & TK); f [MHz]

Simulated input current with input filter
CISPR 13 Quasi Peak
CISPR 13 Average

Input Harmonics [dBuV]

Figure 4.15: Input Harmonics and CISPR 13 limits with input filter

4.3. Input Filter (CL, SK & TK) | 62 of 91

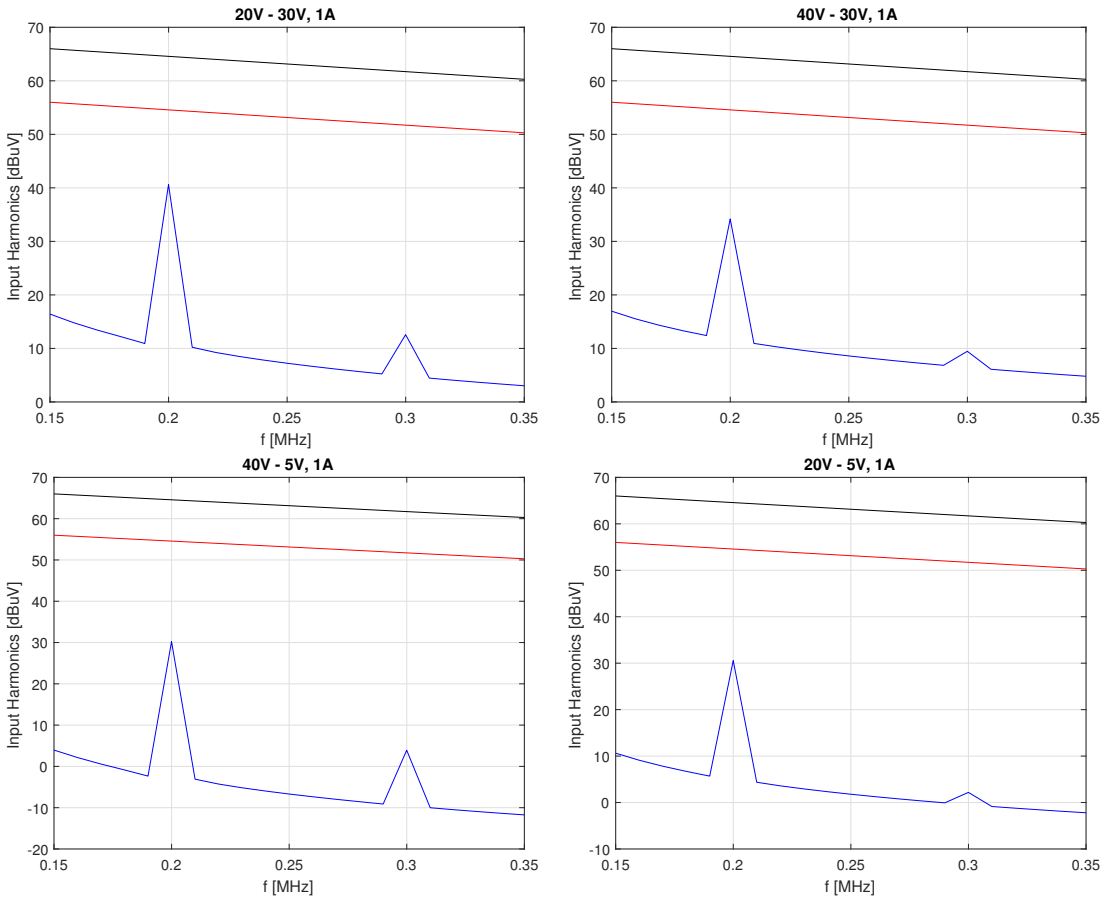
[picture p44: figure]
f [MHz]; Input Harmonics [dBuV]

Figure 4.16: Input Harmonics and CISPR 13 limits with filter, zoomed in at the second and third harmonics. Same colors as previous figure.

From this it is seen that the harmonics now are below the CRISPR 13 limits. The smallest margin is again for case 1, now with a margin of 14dB.

Inrush Current

There will be two significant spikes in the input current. One when connecting the converter to the DC supply voltage. This will be because of the rapid charging of the capacitors at the input side of the DC-DC converter. Likewise, there will be a spike when starting up the converter. Then the output side capacitor is charged. Both spikes are investigated according to the ETSI EN 300132-2 [6] standard. Here the input current is normalized to the maximum nominal current of the converter which for our case is 1.5A.

Starting the Converter

The worst case for this current spike is when the output voltage is high and the load current is high. Two cases are tested, one with low and one with high input voltage. The load is assumed to be purely resistive.

4.3. Input Filter (CL, SK & TK) | 63 of 91

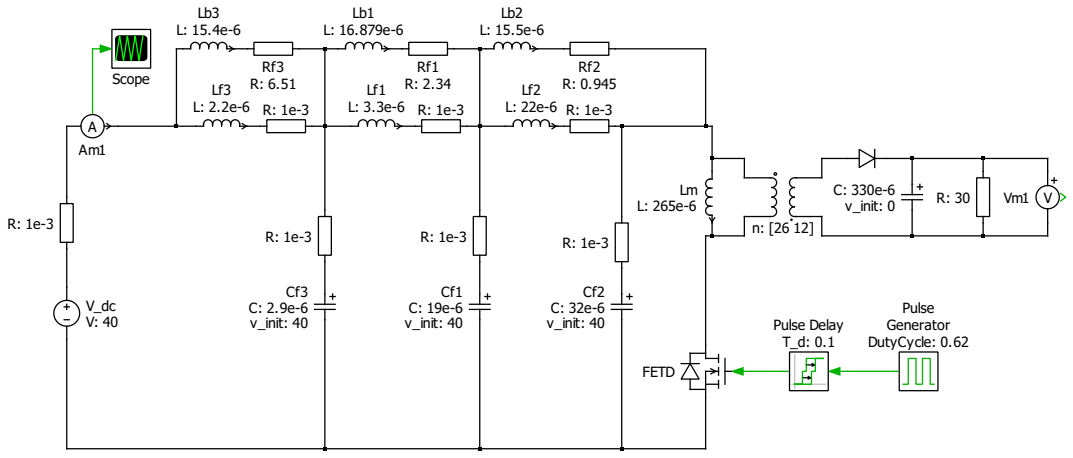
[picture p45: figure]
v_init: 0; Scope; Cf1 C: 19e-6 v_init: 40; Cf2 C: 32e-6 v_init: 40; Cf3 C: 2.9e-6 v_init: 40; Pulse; Generator DutyCycle: 0.62; FETD; Pulse Delay T_d: 0.1

Figure 4.17: PLECS simulation setup for inrush current when starting the converter.

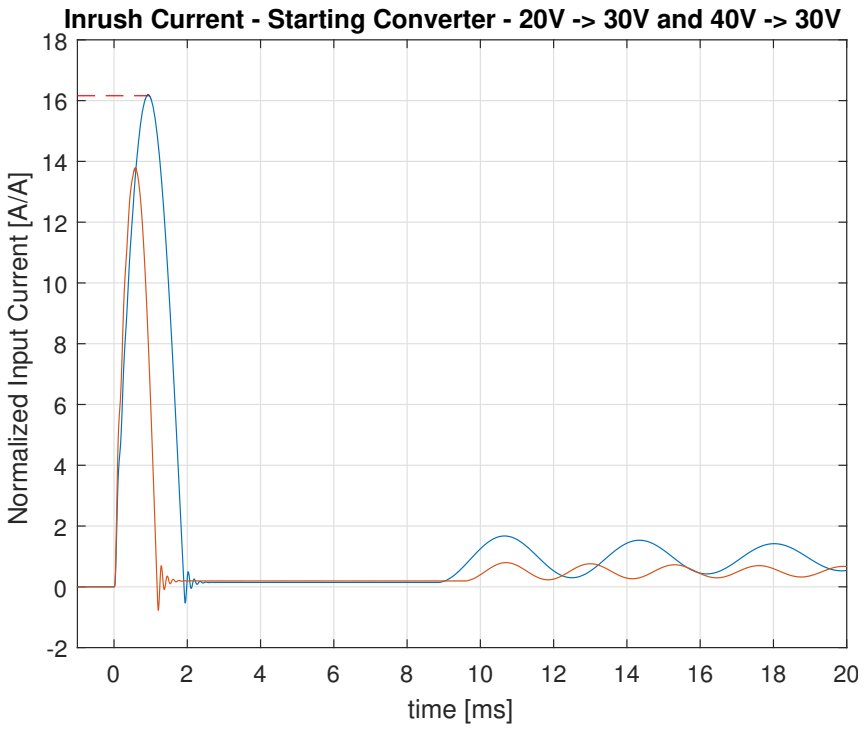
[picture p46: figure]
time [ms]; Normalized Input Current [A/A]

Inrush Current - Starting Converter - 20V -> 30V and 40V -> 30V

Figure 4.18: Inrush current simulation results when starting the converter (at t = 0). Simulated for two different input voltages.

The oscillations are some short term resonance in the input filter.

Connecting the Converter

The worst case for this current spike is when the input voltage is high. Because of this, the case of Vin = 40V is simulated. The switch is removed and the initial capacitor voltages and inductor

4.3. Input Filter (CL, SK & TK) | 64 of 91

currents are set to zero. Then the voltage supply is suddenly connected. The following figures show the simulation setup and results.

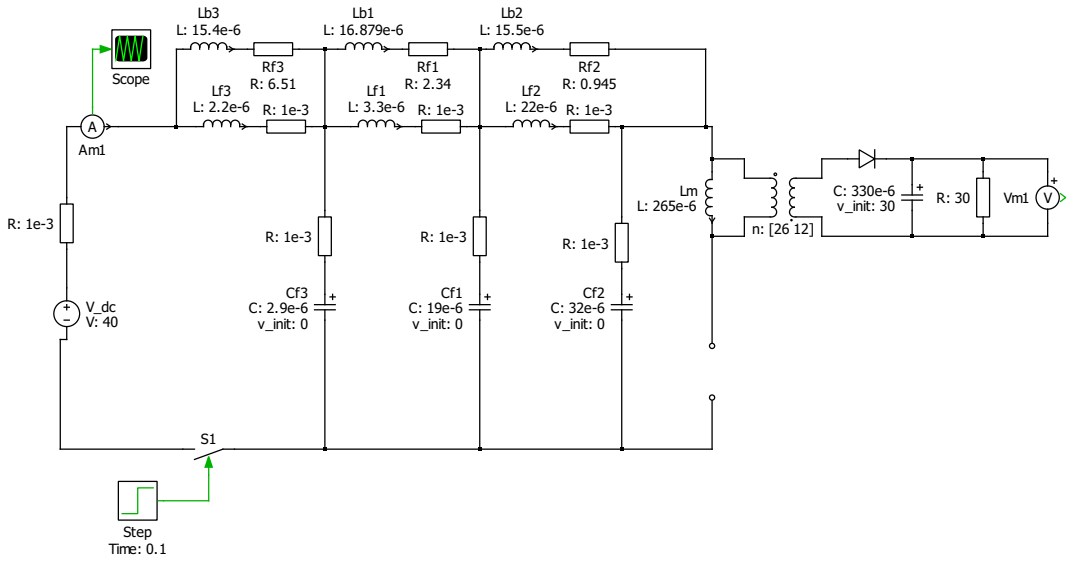
[picture p47: figure]
v_init: 30; Scope; Cf1 C: 19e-6 v_init: 0; Cf2 C: 32e-6 v_init: 0; Cf3 C: 2.9e-6 v_init: 0; Step Time: 0.1

Figure 4.19: PLECS simulation setup for inrush current when connecting the converter.

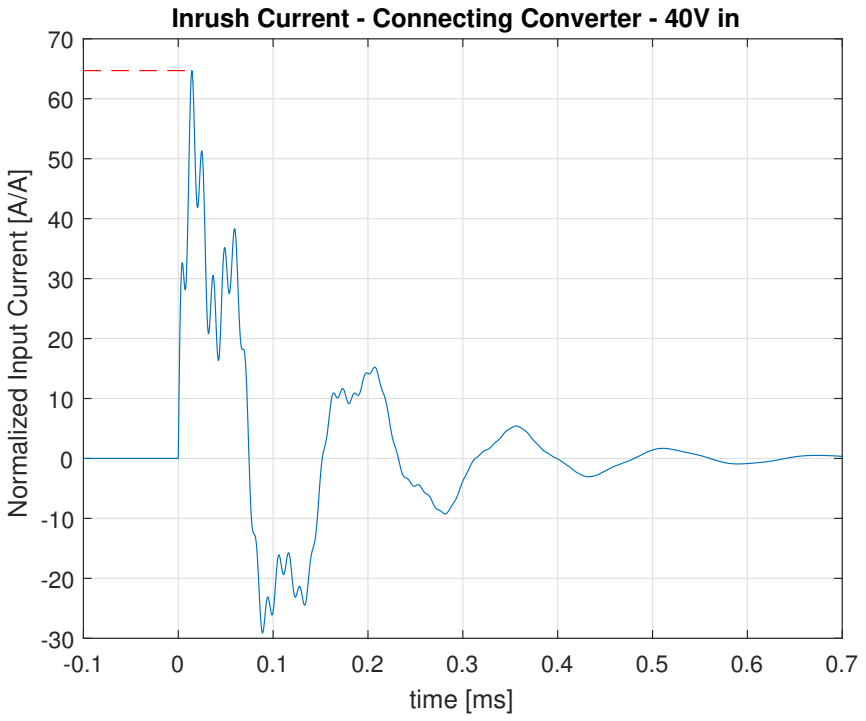
[picture p48: figure]
time [ms]; Normalized Input Current [A/A]

Inrush Current - Connecting Converter - 40V in

Figure 4.20: Inrush current simulation results when connecting the converter.

Here it is seen that the input current spikes to 65 times the nominal maximum input current. This is above the maximum of 48 given by ETSI EN 300132-2. Anyway, it is interesting to see that the

4.3. Input Filter (CL, SK & TK) | 65 of 91

fundamental frequency of the waveform in Fig. 4.20 fits with the dominating resonance frequency of the input filter (6kHz).

Inrush Limiting Circuit

The simulations showed that some sort of inrush limiting is needed. However, the power loss should still be low. Because of this it is decided to place an NMOS with a low RDSON in the negative lead of the input terminals. This switch will close when a capacitor at its gate is charged. A zener diode is used to limit the gate voltage. The FDD8444_F085TR-ND MOSFET[7] is selected due to its low on resistance of RDSON = 5.2mΩ. The zener diode is set to 11volt to keep the MOSFET

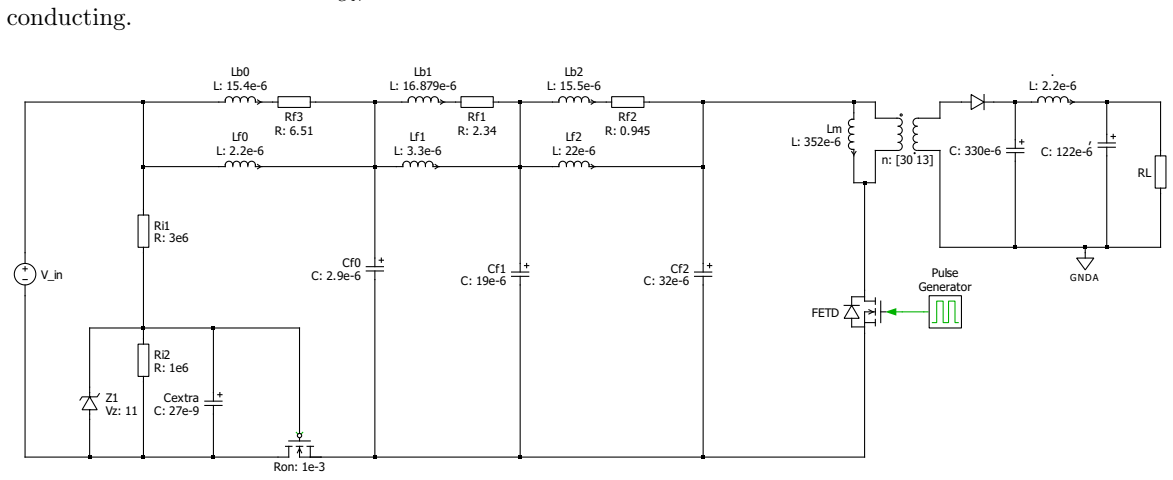
[picture p49: figure]
conducting.; GNDA; Cextra C: 27e-9; Ron: 1e-3; Pulse Generator; FETD

Figure 4.21: Complete circuit with inrush limiter

Simulations of the new inrush current were performed in LTSpice due to P LECS limitations. These simulations show sufficient limitation of inrush current spike (4A) and a steady state loss of ≈ 2mW. Fig. 4.22 show the normalized current spike when connecting the converter to the DC source.

4.4. RMS Currents of Capacitors (CL, SK & TK) | 66 of 91

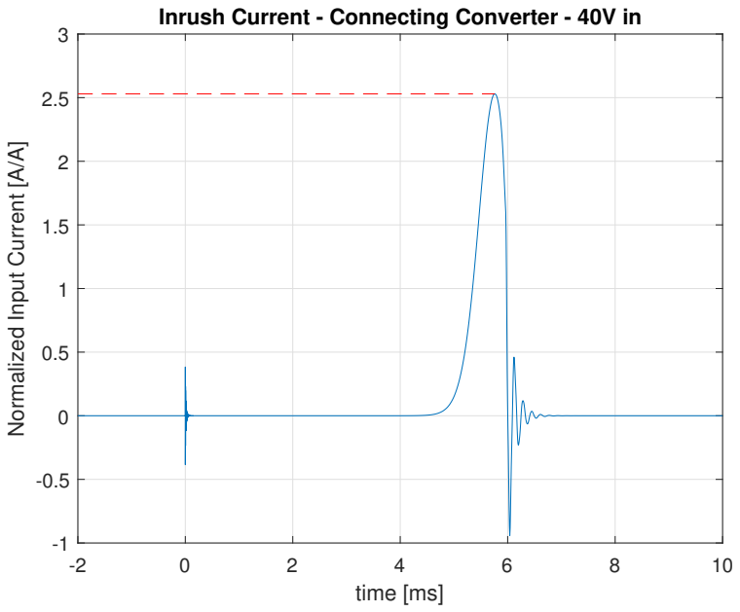
[picture p50: figure]
time [ms]; Normalized Input Current [A/A]

Inrush Current - Connecting Converter - 40V in

Figure 4.22: Input current spike when connecting the converter. With inrush limiter

### 4.3.4 Selection of Components

All capacitors at the input side are chosen to be ceramic capacitors. This is done because they have a small ESR. This is important as ESR in the input filter changes the filter behaviour. Furthermore, ceramic capacitors are small in size. But as the small signal capacitance deteriorates with the bias voltage, 100V rated capacitors are chosen for the input filter.

## 4.4 RMS Currents of Capacitors (CL, SK & TK)

The RMS currents of the capacitors closest to the transformer are investigated by simulation in the four cases.

Case | Vin | Vout | Iout | ICf2RMS | ICoutRMS
1 | 20V | 30V | 1A | 0.818A | 1.75A
2 | 40V | 30V | 1A | 0.342A | 0.745A
3 | 40V | 5V | 1A | 0.238A | 0.539A
4 | 20V | 5V | 1A | 0.635A | 1.34A

Table 4.4: Capacitor RMS currents

The worst cases for the input side and output side capacitor currents are 0.818A and 1.75A respectively.
Thus, it would for example be sufficient to have the selected capacitor at the output.[4]. Furthermore, the capacitor current is no issue in the primary side capacitor Cf2
| | | | | as ceramic capacitors are
chosen. (Lower ESR gives lower power losses).

4.5. Filter Design Summary (CL, SK, BW & TK) | 67 of 91

## 4.5 Filter Design Summary (CL, SK, BW & TK)

This summarizes the design of the input and output filter of the Flyback converter. A single capacitor was selected as an output filter. Three low-pass filters were cascaded as input filters. They were Rf -Lb parallel damped in order to meet Middlebrook’s stability theorem. Additionally, small value ceramic capacitors will be used for HF damping. Finally ,an inrush limiting circuit is used.

Parameter | Value
Cout1 | 6 × 56µF
Cout2 | 2 × 56µF + 1 × 10µF
Lout2 | 2.2µH
Cf2 | 32µF
Lf2 | 22µH
Rf2 | 0.95Ω
Lb2 | 155µH
Cf1 | 19µF
Lf1 | 3.3µH
Rf1 | 2.3Ω
Lb1 | 16.9µH
Cf0 | 2.9µF
Lf0 | 2.2µH
Rf0 | 6.5Ω
Lb0 | 15.4µH
Ri1 | 3MΩ
Ri2 | 1MΩ
Vz | 11V
Cextra | 27nF

Table 4.5: Filter Parameters. See Fig. 4.21.

Simulations show that the design criteria given in table 4.1 are met. Furthermore, the filters are not unreasonably large in size as a higher order filter were used.

# 5 | Control Circuit (CL, SK & TK)

## 5.1 Control Scheme

Current mode control is chosen. This makes a type 2 compensator favorable compared to type 1 and 3. Type 2 has better phase margin than type 1, with a phase boost of 90 degrees. Type 3 is not necessary as type 2 gives sufficient phase margin.
To regulate the output voltage a TLVH431 shunt regulator is used as an error amplifier. This compares the output voltage with a reference voltage of 1.24V. The output voltage is changed by varying the lower resistor in the voltage divider. The reason for using this instead of the standard TLV431 is that it allows for a wider voltage swing.
When the output voltage is too large and the divided voltage is larger than 1.24V the regulator passes more current. Which in turn causes a larger current to flow through the optocoupler. Increased current causes a lowered voltage at the output of the optocoupler. This lowered voltage gives a lower reference current to the peak current controller. This reduces the duty cycle which causes an reduction in the output voltage. Thus, the converter will be stable if only the phase margin is sufficiently large.
The optocoupler makes it possible to keep the primary side isolated from the secondary side. The FET current is measured with a series resistor which gives a voltage to the peak current controller. When this current measurement is larger than the limit set by the signal from the optocoupler, the FET switches off until the next switching period. Furthermore, subharmonic oscillation is avoided by using slope compensation.

## 5.2 Open Loop Analysis and Compensator Design

### 5.2.1 Plant Analysis

1. Analyse plant
2. Set wanted crossover frequency
3. Place poles and zeros to give desired phase behavior
4. Adjust gain to get wanted crossover frequency
5. Double check phase margin

The duty cycle to output voltage transfer function of a flyback can be derived from the small signal model given by Erickson.[5] The transfer function has a low frequency horizontal asymptote, an LC resonance peak and a second order decaying high frequency asymptote. However, the algebraic expression is not used as open loop characteristics can be analyzed in PLECS simulations.
As a rule of thumb, the crossover frequency can be set to a 10th of the switching frequency or a bit lower. This frequency should be high enough to have a quick system, but low enough so that noise doesn’t influence the performance. Another possible way is to decide the crossover frequency based on the converters output impedance and the maximum undershoot at a given load step. For this application it is decided to set it to 2kHz and then simulate the closed loop behaviour. Also, it is desired to boost the phase around this frequency to achieve a phase margin of at least 45◦ .

68

5.2. Open Loop Analysis and Compensator Design | 69 of 91

### 5.2.2 Compensator Design

The compensation is achieved by adding a network of resistors and capacitors around the TLV431 as seen in Fig. 5.1.

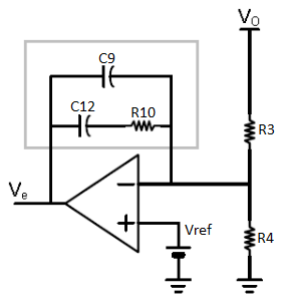
[picture p51: figure]

Figure 5.1: The TLV431 and the compensation network

Here, the pole caused by the output capacitance of the optocoupler is not considered. However, it is considered when simulating. The presence of this pole causes some extra high frequency damping. The transfer function of the type 2 compensator is

G(s) = −

1 + sR10C12

sR3(C12 + C9)
1 + sR10

C12C9
C12 + C9
! | (5.1)

The transfer function of the type 2 compensator consists of a zero and a pole, a pole at origin and a gain. The pole at origin will give the compensator a 90 degree phase lag at low and high frequencies. If the zero is placed before the pole it will shift the phase towards 0 degrees before the pole will the shift it back towards 90 degrees.
The pole and zero are placed such that the phase is boosted at the desired crossover frequency. If C12 >> C9 the pole and zero of the compensator are:

ωp1 =

1

R10C9

(5.2)

ωz1 =

1

R10C12

(5.3)

Changing R3 changes the gain across all frequencies. ωz1 is placed lower than the crossover frequency to boost the phase and ωp1 at higher frequencies. A zero at ωz1 = 50rad/sandapoleatωp1 = 10·10³
rad/s achieves a phase boost around the desired crossover frequency. Choosing R10 = 160kΩ and solving eq. 5.2 and 5.3 with the chosen values of ωz1andωp1 The capacitances are calculated to be C12 = 20nF and C9 = 100pF. The gain is then adjusted to achieve the desired crossover frequency with R3 = 800kΩ. The bode plot of the designed compensator is shown in figure 5.2.

5.2. Open Loop Analysis and Compensator Design | 70 of 91

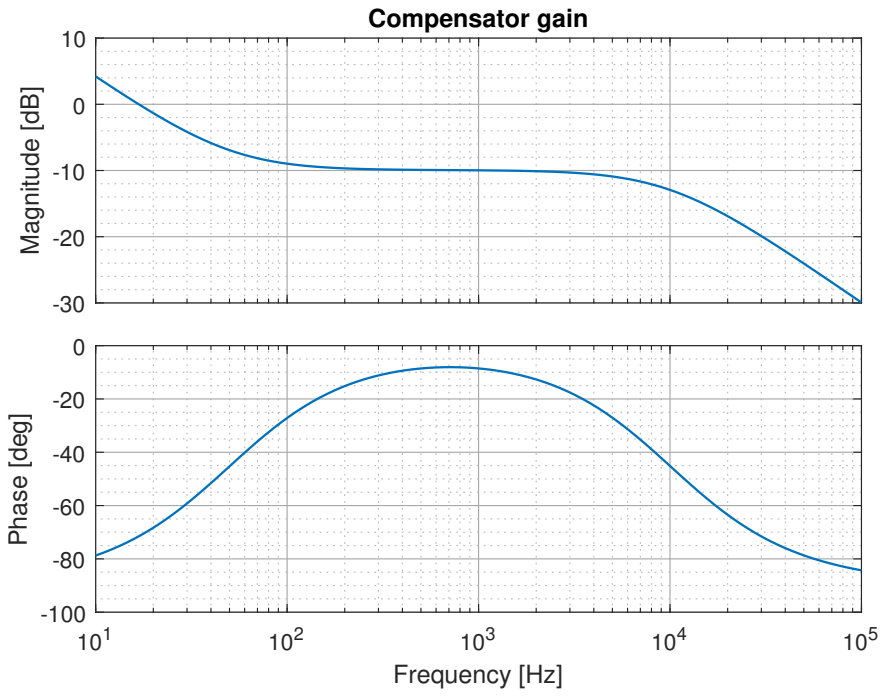
[picture p52: figure]
Magnitude [dB]; Compensator gain; Frequency [Hz]; Phase [deg]

Figure 5.2: Frequency response of the designed type 2 compensator

The chosen components are now used to simulate the open loop behaviour in PLECS. Fig. 5.3 shows the simulation setup. Here a loop gain meter is used. It finds the closed loop operating point and then performs an open loop measurement.

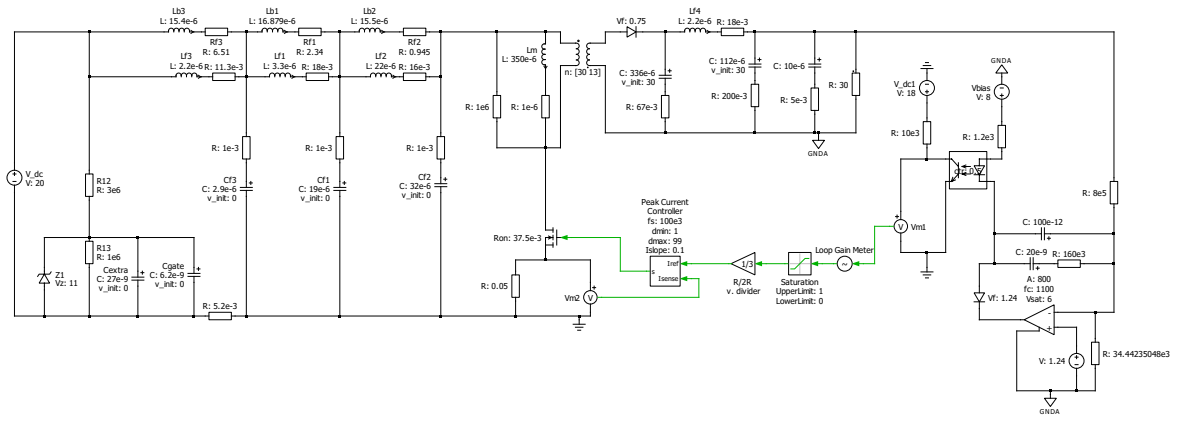
[picture p53: figure]
C: 336e-6 v_init: 30; Ron: 37.5e-3; v. divider; Peak Current; Controller fs: 100e3 dmin: 1; dmax: 99; Islope: 0.1; Isense; Iref s; fc: 1100 Vsat: 6; ctr: 0.5; Saturation UpperLimit: 1; LowerLimit: 0; Vbias V: 8; GNDA; Cextra C: 27e-9; v_init: 0; Cgate C: 6.2e-9; Cf1 C: 19e-6 v_init: 0; Cf2 C: 32e-6 v_init: 0; Cf3 C: 2.9e-6 v_init: 0; C: 112e-6 v_init: 30; Loop Gain Meter ~

Figure 5.3: Model for loop response simulation in PLECS. Resistive parasitics are included in this model

The simulated loop gain (both plant and feedback) is shown in fig. 5.4 in the 4 corner cases (max load). The crossover frequency varies from ≈ 1kHz to 3.4kHz and the phase margin is 60 degrees for the worst case.

5.2. Open Loop Analysis and Compensator Design | 71 of 91

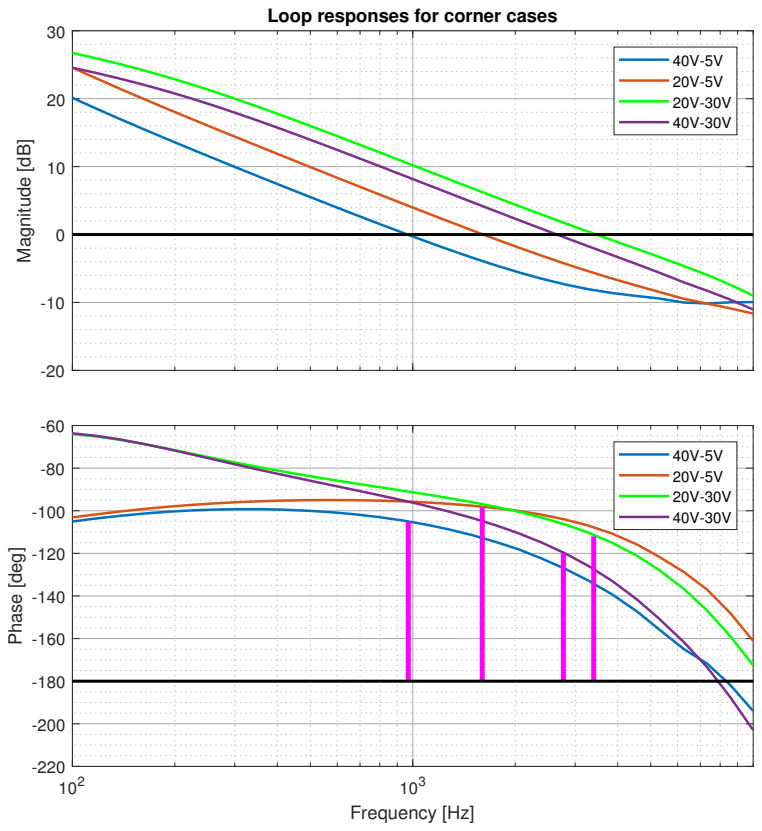
[picture p54: figure]
Magnitude [dB]; Loop responses for corner cases; Frequency [Hz]; Phase [deg]

Figure 5.4: Loop response of converter in the 4 corner cases in the case of the PLECS setup in 5.3. The vertical magenta lines are phase margins

5.3. Closed Loop Performance | 72 of 91

## 5.3 Closed Loop Performance

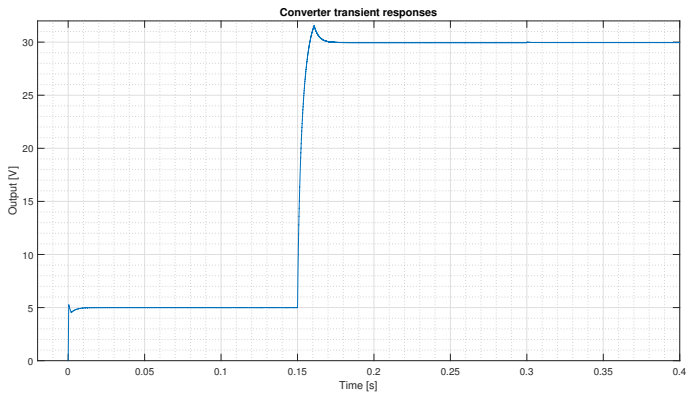
[picture p55: figure]
Time [s]; Output [V]; Converter transient responses

Figure 5.5: The converter’s transient responses

In fig 5.5 the transient responses of the converter can be seen. At t = 0 the converter is turned on with a reference that should give 5V on the output. At t = 0.15s the reference is stepped to 30V and at t = 0.3s the load is stepped from 50% to 100%. As the figure shows the response is fast with a negligible steady state error, and the loadstep is barely detectable.

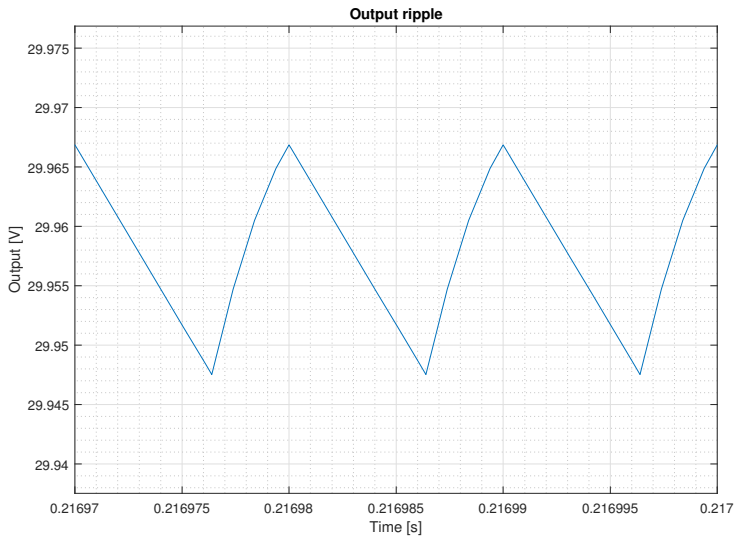
[picture p56: figure]
Time [s]; Output [V]; Output ripple

Figure 5.6: The steady state ripple at output

In Fig. 5.6 the output ripple with input of 40V and an output of 30V, 1A is seen. The peak to peak voltage is 20mV.

5.4. Implementation | 73 of 91

## 5.4 Implementation

### 5.4.1 Powering the active components

The control circuitry on the primary side is supplied with 18V from a linear regulator (TPS79801-Q1) which uses the input voltage as supply. As the current controller has a built in gate driver this will also be the voltage which will be used to switch the MOSFET. 18V is chosen as it gives a low ON-resistance.

The circuitry on the secondary side is powered by the same type of linear regulator as above, except that this is supplied by a tertiary winding in the transformer (Ntertiary = 22 turns). The tertiary winding is connected to a rectifying diode and a smoothing capacitor. The windings would not take up much space in the transformer window since almost no power is required for the control circuit and very thin wires can be used without significant winding loss. A tertiary winding is used to get high enough voltage, and a voltage regulator is used to keep the feedback gain independent of the output voltage. The linear regulator delivers a voltage of 8V from an input of 8.3V to 49.8V.

### 5.4.2 MOSFET - BSF450NE7NH3

This 75V, 15A rated Infineon Optimos MOSFET[8] is chosen as it has an excellent figure of merit (FOM). As the switching frequency here is rather low, emphasis is here on having a low Rdson, which is also quite good (45mΩ).

### 5.4.3 Optocoupler - 4N35-37

Isolation of the signal feedback to the current controller is obtained by using an optocoupler to transfer the control signals from the isolated output to the control circuit on the input side. This is found to have a current transfer ratio of 0.50mA/mA.

### 5.4.4 Peak Current Controller - UC3842AD8TR

Current sensing

A current spike can happen on when switching in the flyback converter and since we’re using peak current control such a spike would interfere with the control. A lowpass filter is therefore applied to the current sensing resistor. It is dimensioned such that the filter’s time constant is equal to 5% of the switching period, as that is a rough estimate to the current spike we want to dampen.

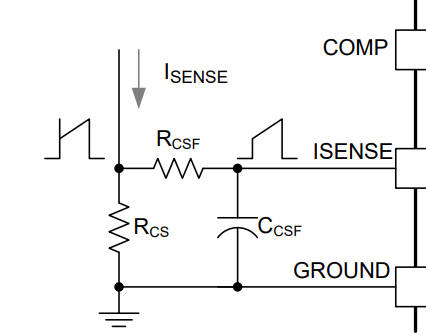
[picture p57: figure]

Figure 5.7: Low pass filter for current sensing[9]

5.4. Implementation | 74 of 91

Furthermore, the current sense resistor is selected to be Rsense = 50mΩ (called Rcs in Fig. 5.7). This low value is selected so that the losses are low and the peak current controller does not saturate. The filter components are set to be Rlp = 10kΩ and Clp = 50pF (called Rcsf and Rcsf in the figure).

Slope Compensation

Slope compensating is necessary as the duty cycle will go higher than 0.5. The compensating slope is set to m = m2 = 464kA/s which ensures no subharmonic oscillation. Here, m2 is the falling slope of the inductor current transformed to the primary side.

m2 =

Vout,max
Ls · n
| (5.4)

This compensation is implemented as adding a slope to the voltage feedback (from the optocoupler). This is done by connecting a resistor from the "RT/CT" timing port of the controller. Fig. 5.8 show this circuit.

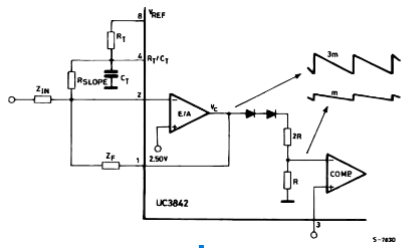
[picture p58: figure]

Figure 5.8: Compensating circuit[10]

The impedance Zf and Zin are set to Rf = Rin = 50kΩ. This gives unity gain of the internal inverting amplifier. Now, Rslope is found[10]:

Rslope =

2.2 · mvZf

fsw

= 24.3kΩ | (5.5)

Here, mv is the current compensating slope multiplied with the sense resistor, mv = Rsense · m.

Frequency of Operation

In order to achieve 100kHz operation of the switch, equation 5.6 must be satisfied.

fosc =

1.72
RT · CT
= 100kHz | (5.6)

Where RT is kept much smaller than Rslope to keep the compensating ramp linear.[10] RT = 1kΩ and CT = 17.2nF is chosen. When implementing, the value of CT can be adjusted to get exactly the desired frequency.

5.5. Control Design Discussion | 75 of 91

Drive capabilities

The chosen MOSFET will draw an average gate current of Qg ·fsw. With a gate charge of maximum 10nC[8] the current becomes 1mA, which is smaller than the maximum drive capability of 200mA. Thus it is not required to have an external gate driver IC.

### 5.4.5 Over Current Limiter

The converter is designed such that the core should not saturate. Nevertheless, a protective circuit is added as the current is measured anyways. This is done with a op-amp that compares the measurement voltage to a voltage that corresponds to a current of 5A ( twice the worst case peak current). If the current goes above this limit, the op-amps output goes high which enables an MOSFET which in turn forces the COMP pin to ground. This shuts down the current controller, until the current is below this threshold again.

## 5.5 Control Design Discussion

### 5.5.1 Sense Resistor

The small size of the current sense resistor makes the measured voltage susceptible to noise as the voltage level is low. It might become necessary to use a differential amplifier to reduce the influence of noise. Furthermore, simulations show that close to 0.2W is dissipated in this resistor in the worst case. This is below the common rating of 0.25W.

### 5.5.2 Results

The designed control scheme gives promising simulation results with a phase margin of 60 degrees for the worst case, zero steady state offset and a steady state ripple of 20mV.

### 5.5.3 Schematic

The final schematic of the converter is seen in fig. 6.1 in chapter 6.

# 6 | Circuit Diagram and Bill of Materials (CL, SK, BW & TK)

## 6.1 Bill of Materials

1 x TDK EPCOS ETD 29/16/10 N87 Transformer core

1 x TDK EPCOS ETD 29/16/10 Transformer coil former (magnetic axis horizontal)

2 x TDK EPCOS ETD 29/16/10 Transformer yoke

50 cm 30mm kapton tape

200 cm Von Roll 0317-0-1 grade 1, = 1.18mm Copper wire

100 cm Von Roll 0317-0-1 grade 1, = 1.40mm Copper wire

8 x 56µF, 50V Panasonic EEU-FM1H560, Electrolytic Capacitor

5 x 10µF, 100V TDK CGA9N3X7S2A106K230KB Ceramic Capacitor

3 x 1µF, 100V TDK C3216X7R2A105K160AA Ceramic Capacitor

2 x 2.2µH, Wurth 744316220 Power Inductor

1 x 3.3µH, Delevan SPD127R-332M Power Inductor

1 x 22µH, Wurth 744750460220 Power Inductor

2 x 15µH, SC63LCB-150 Signal Inductor

1 x 17µH, Sumida CLS4D23B-170NC Signal Inductor

2 x TPS79801-Q1 Linear Regulators

1 x 4N35(Short) Optocoupler

1 x TLVH431IDBZT Shunt Regulator

1 x UC3842AD8TR Current Mode PWM Controller

1 x IN4741A Zener diode

1 x IN4148W Diode

1 x CDBB5100 Diode

1 x LM293D Operational Amplifier

1 x 2N7002 NMOS

1 x FDD8444_F085TR-ND NMOS

1 x BSF450NE7NH3 Power NMOS

1 x NKK G3T12AH-R SPDT signal switch

76

6.2. Circuit Diagram | 77 of 91

1 x 300k Rotary Potentiometer

4 x 4mm Banana Jack Connector

4 x 200mΩ, 125mW Resistors

The rest of the components are generic components (0805 SMD capacitors and resistors) which are available in most electronics labs.

## 6.2 Circuit Diagram

See the following page for a full size schematic of the converter.

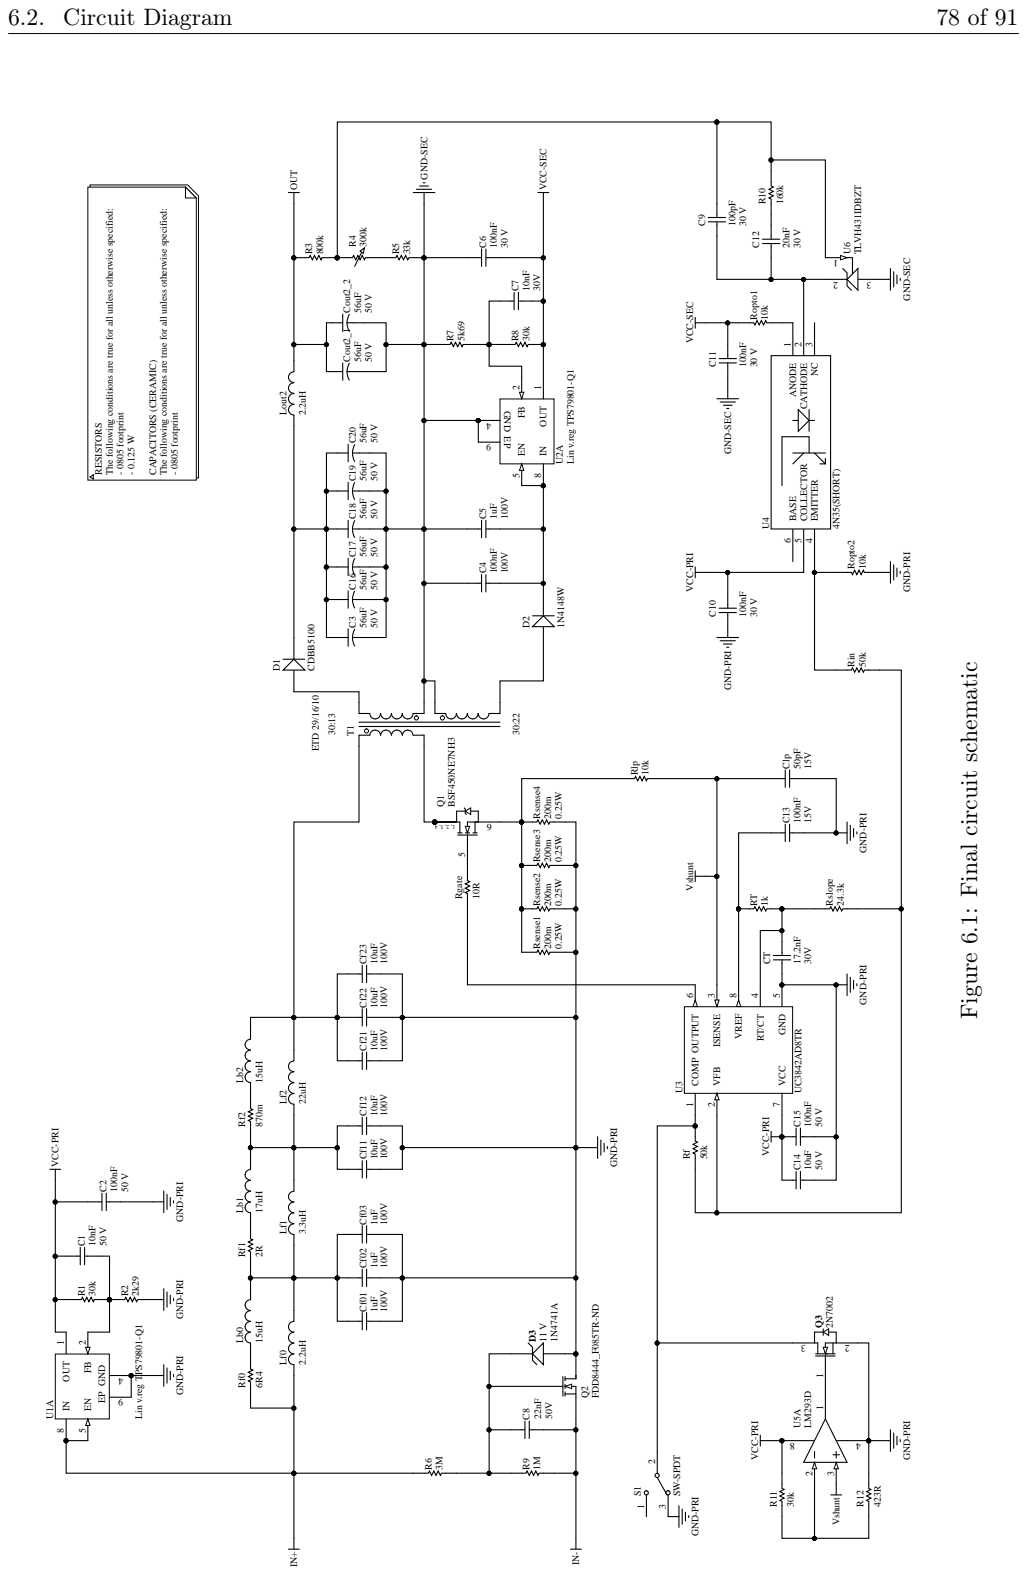
[picture p59: page 85]

The following conditions are true for all unless otherwise specified:

NC 3 EMITTER 4 COLLECTOR 5 BASE 6

Figure 6.1: Final circuit schematic

GND-PRI GND-PRI GND-PRI

# 7 | Performance Analysis (CL, SK &

TK)

An estimate of the converter efficiency is found by using a combination of calculated losses and simulated losses. The transformer losses calculated for the worst case operating point in the magnetic section is used together with a PLECS simulation. The simulation accounts for the losses in the filters, the MOSFET and most of the logic. The following formulas show how the efficiency are estimated.

η =

Pout

Pin

ηestimated =

Pout simulated

Pin simulated + Ptransformer loss calculated + Pextra loss simulated

(7.1)

Where Ptransformer loss calculated is the sum of core and winding losses, Pextra loss simulated represent the logic and switching losses. The switching losses are approximated by simulating a switching of the capacitances Ciss and Coss from 0V to 18V and Vin respectively.
Figure 7.1 shows a part the simulation setup. For the entire simulation circuit and values of component parasitics, see appendix C.

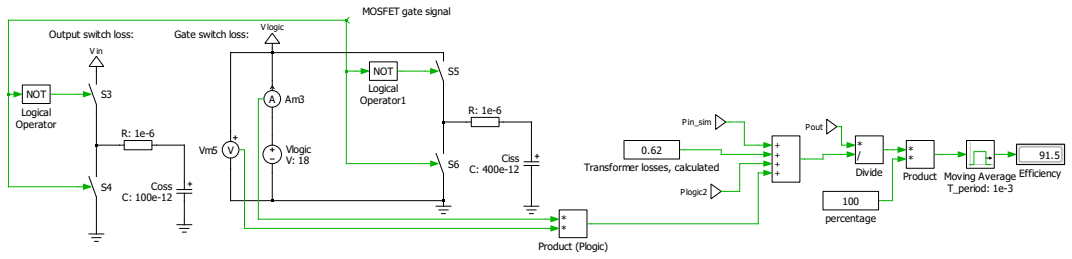
[picture p60: figure]
NOT; Logical Operator; Coss C: 100e-12; Logical Operator1; Ciss C: 400e-12; Vlogic V: 18; Transformer losses, calculated; Pin_sim; Pout; Divide; Product; percentage; Moving Average T_period: 1e-3; V logic; Product (Plogic); Plogic2; Efficiency; Output switch loss:; Gate switch loss:; MOSFET gate signal

Figure 7.1: Efficiency estimation in PLECS. Based on eq. 7.1.

This simulation results in an estimated efficiency of ηestimated = 92% for the case of Vin = 20V, Vout = 30V and Iout = 1A.

79

# 8 | Specification Comparison (CL, SK

& TK)

Here, the final converter design is tested with intrinsic parameters (ESR of capacitors, DCR of inductors etc.). Inrush current and input current harmonics are not tested again, as it seems unlikely that the damping of the input current degrades with extra resistances.
The same simulation setup is used as in the performance analysis (schematic in appendix C). A

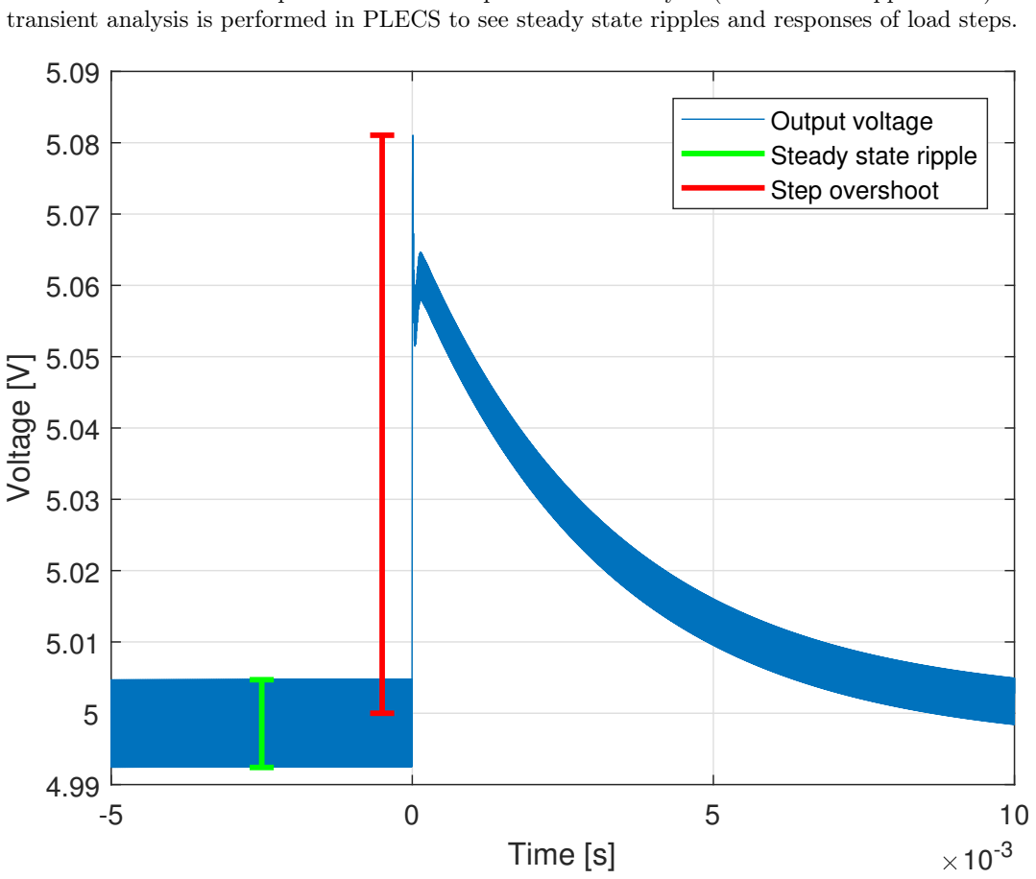
[picture p61: figure]
Time [s]; Voltage [V]; Output voltage; Steady state ripple Step overshoot

transient analysis is performed in PLECS to see steady state ripples and responses of load steps.

Figure 8.1: Output voltage during load step at 5V

Steady state ripple of 12.7mV, step overshoot of 81.1mV (1.62%).

80

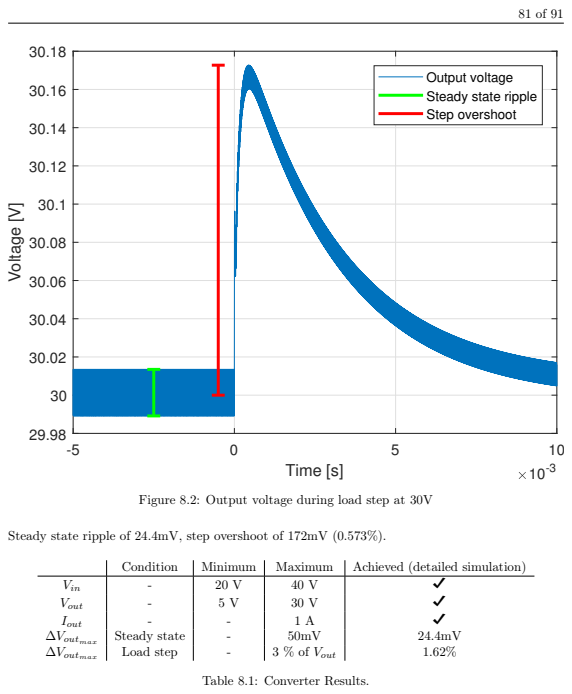
[picture p62: page 88]
Time [s]; Voltage [V]; Condition; Minimum; Maximum; Achieved (detailed simulation); Vin; Vout; Iout; ∆Voutmax; Steady state; Load step; 3 % of Vout

Output voltage
Steady state ripple Step overshoot

Figure 8.2: Output voltage during load step at 30V

Steady state ripple of 24.4mV, step overshoot of 172mV (0.573%).

Table 8.1: Converter Results.

# 9 | Discussion (CL, SK & TK)

Several assumptions and approximations are done during this work. Some of them might have been less valid than initially expected. This might not give any consequences as all design choices include safety margins. For example: In the filter design chapter, an extra filter was added at the output of the converter. When doing this it was assumed that this did not change the converter’s "input impedance" ZD significantly. In reality it is probably lowered a bit. But as the stability margins (Middlebrook) are large it will probably not cause any issues.
Some design choices could also have been done differently. An differential amplifier can be added to the current sensing resistor for improved noise rejection. One might also argue that a smaller magnetic core with more turns and larger airgap might be wiser although the calculations here indicate that this would lower the efficiency.
One important thing to consider is if the circuit is able to start when the secondary side logic is unpowered. When the secondary side is unpowered, no current runs through the optocoupler and thus the voltage is 0 at the VFB pin of the controller IC. This will probably cause this IC to start switcing the FET as the VFB is connected to the negative input of an internal amplifier.

82

# 10 | Conclusion (CL, SK & TK)

The converter has an estimated efficiency of 92% at maximum load, which is promising. The transient, stability and steady state analyses have been thorough, and the analyses has considered intrinsic resistances for the relevant components. Furthermore, parasitic MOSFET capacitances are considered to account for switching losses at the gate and drain. This suggest that the design is realizable with a performance close to the estimated one.

83

# A | Magnetic Design: ETD-Cores

The following contains considerations of using ETD-cores for the transformer design. A MATLAB script was used to conduct a comprehensive investigation of all the available ETD-cores up to size 39/20/13 and related coil formers listed in [1] as well as all the possible wire diameters in [2] taking into account the insulation of the wires. The procedure for determining whether or not a certain configuration would be practically realizable was identical to the one described in Chapter 3. The conditions in Table A.1 set the limits of the design parameters.

Primary layers | 1
Secondary layers | 1
Max primary windings | 32
Air gap (each leg) | 100 µm
Ideal turns ratio | 0.433
Max turns ratio deviation | 0.033

Table A.1: Conditions for determination of configurations in Fig. A.1.

The results of this analysis are shown in Fig. A.1.

84

85 of 91

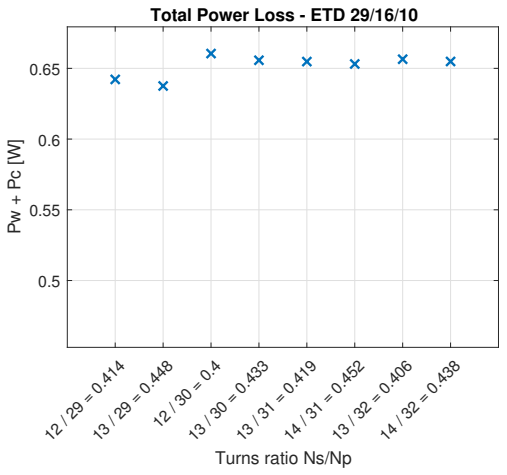
[picture p63: figure]
Turns ratio Ns/Np; Total Power Loss - ETD 29/16/10

(a)

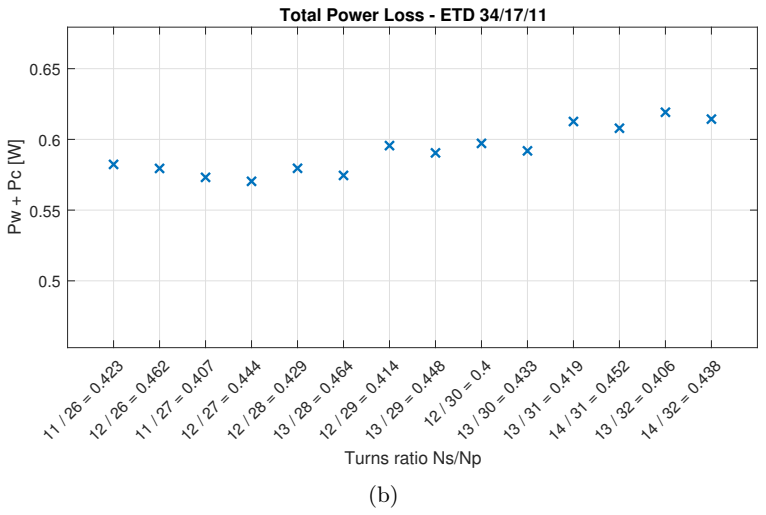
[picture p64: figure]
Turns ratio Ns/Np; Total Power Loss - ETD 34/17/11
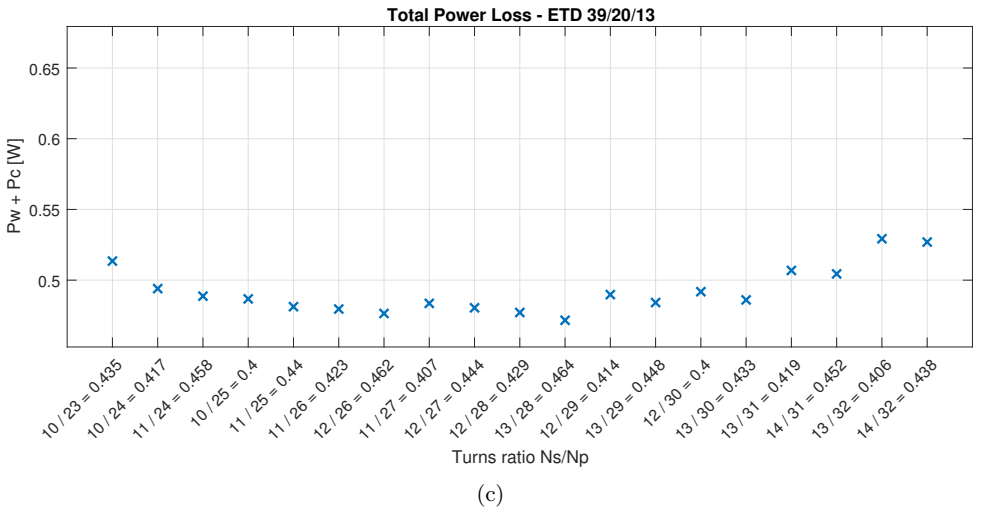
[picture p65: figure]
Turns ratio Ns/Np; Total Power Loss - ETD 39/20/13

Figure A.1: Realizable E-core configurations with 1 primary layer.

# B | Magnetic Design: E-Cores

The following contains considerations of using E-cores for the transformer design. A MATLAB script was used to conduct a comprehensive investigation of all the available E-cores smaller up to size 36/18/11 and related coil formers listed in [1] as well as all the possible wire diameters in [2] taking into account the insulation of the wires. The procedure for determining whether or not a certain configuration would be practically realizable was identical to the one described for ETD-cores in Chapter 3. However, the script was modified to take into account the square coil former center leg when calculating winding lengths. Furthermore, the calculations were done using both 1 and 2 primary layers with the condition of Table B.1 and Table B.2 setting the limits of the design parameters.

Primary layers | 1
Secondary layers | 1
Max primary windings | 30
Air gap (each leg) | 100 µm
Ideal turns ratio | 0.433
Max turns ratio deviation | 0.033

Table B.1: Conditions for determination of configurations in Fig. B.1.

Primary layers | 2
Secondary layers | 1
Max primary windings | 30
Air gap (each leg) | 100 µm
Ideal turns ratio | 0.433
Max turns ratio deviation | 0.033

Table B.2: Conditions for determination of configurations in Fig. B.2.

The results of these analyses are shown in Fig. B.1 and Fig. B.2. This figure contains the possible solutions for five cores, which is less than the number of E-cores in the EPCOS Databook, but the cores not shown have no realizable solutions that fits the limiting parameters of Table B.1 and Table B.2.

86

87 of 91

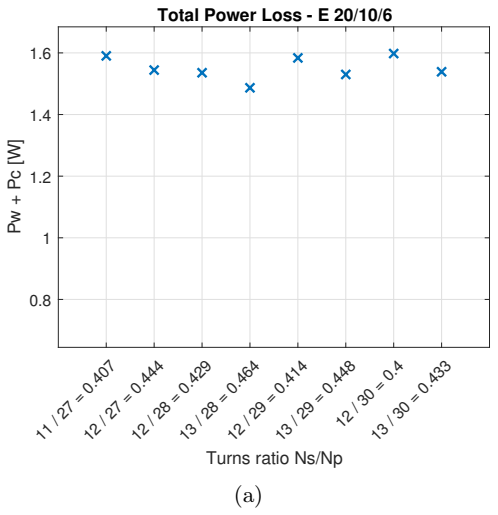
[picture p66: figure]
Turns ratio Ns/Np; Total Power Loss - E 20/10/6
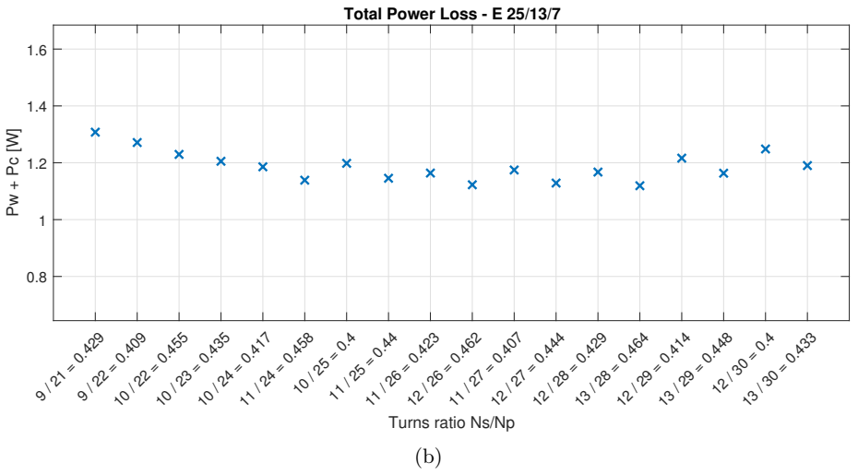
[picture p67: figure]
Turns ratio Ns/Np; Total Power Loss - E 25/13/7
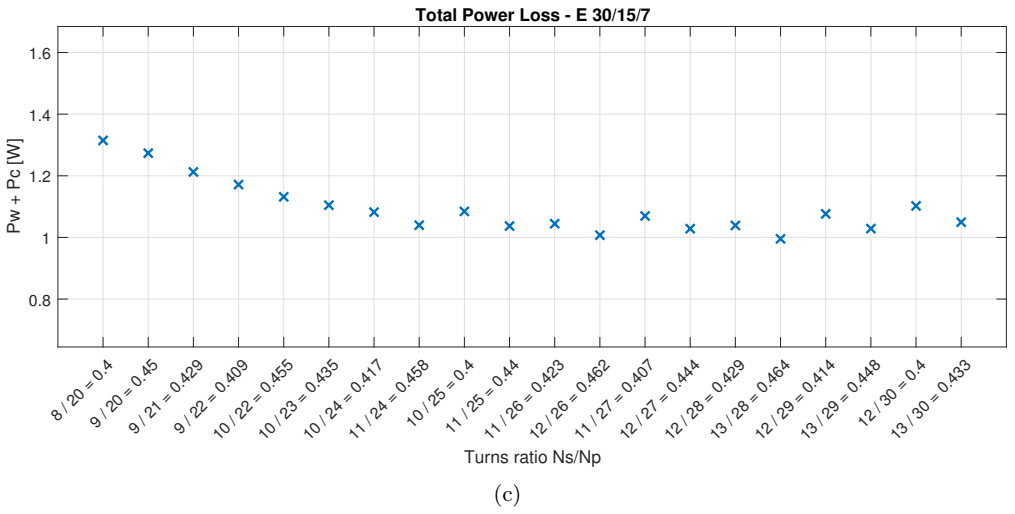
[picture p68: figure]
Turns ratio Ns/Np; Total Power Loss - E 30/15/7

Figure B.1: Realizable E-core configurations with 1 primary layer.

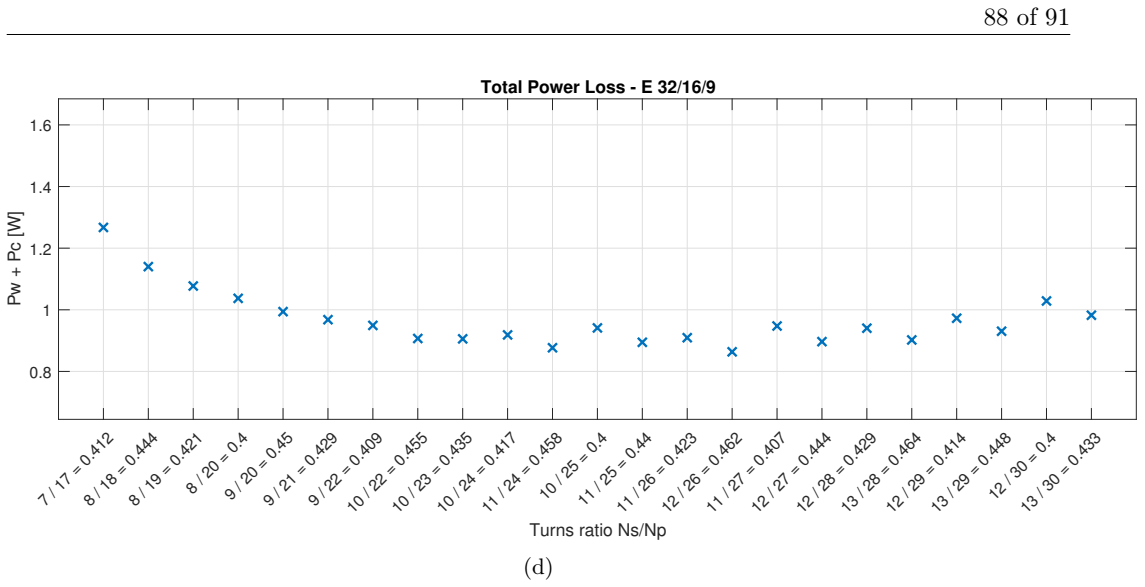
[picture p69: figure]
Turns ratio Ns/Np; Total Power Loss - E 32/16/9
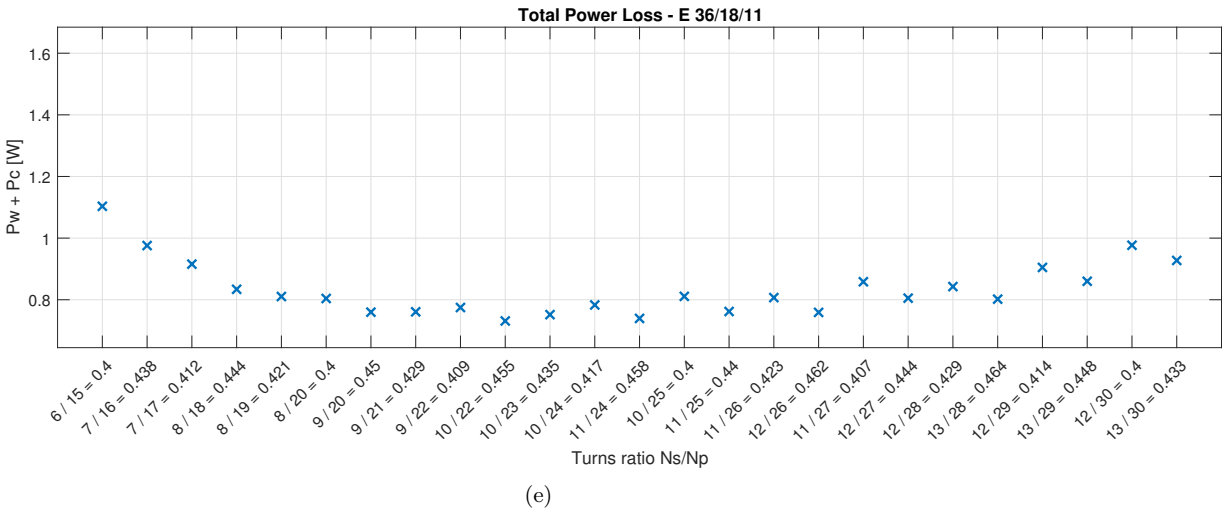
[picture p70: figure]
Turns ratio Ns/Np; Total Power Loss - E 36/18/11

Figure B.1: Realizable E-core configurations with 1 primary layer.

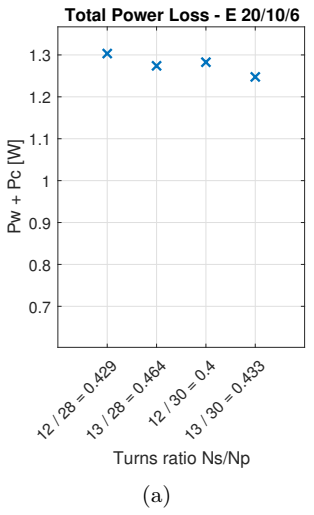
[picture p71: figure]
Turns ratio Ns/Np; Total Power Loss - E 20/10/6
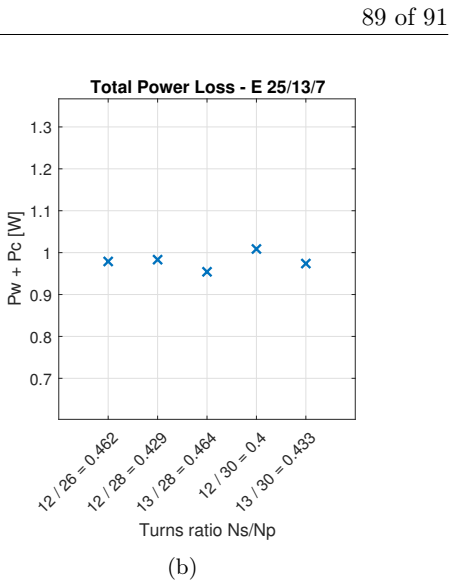
[picture p72: figure]
Turns ratio Ns/Np; Total Power Loss - E 25/13/7
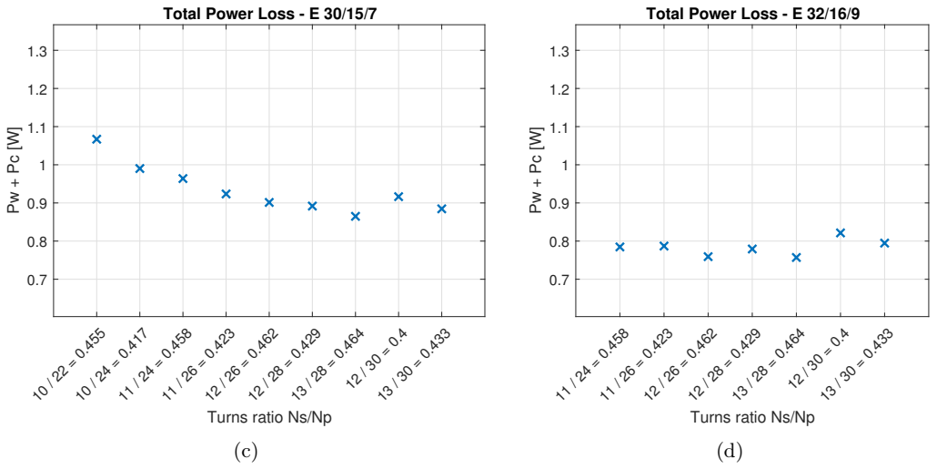
[picture p73: figure]
Turns ratio Ns/Np; Total Power Loss - E 30/15/7; Total Power Loss - E 32/16/9
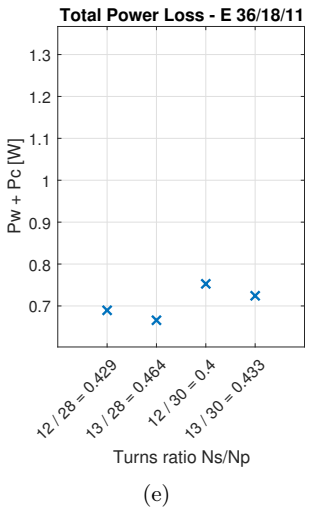
[picture p74: figure]
Turns ratio Ns/Np; Total Power Loss - E 36/18/11

Figure B.2: Realizable E-core configurations with 2 primary layers.

# C | Efficiency Simulation Setup

## C.1 Component Parasitic Parameters

The following parameters are found in the components datasheets.

C.1.1 FET

RDSON = 37.5mΩ Ciss = 400pF Coss = 100pF Simulating Ciss and Coss.

C.1.2 Output Diode

CDBB5100-HF
Vf = 0.75V.
Probably smaller than this.

C.1.3 Output Capacitor

|Z|100k = 22mΩ
Dissipation factor: tan(δ) = 0.10@120Hz
ESR = | 0.10 2πfdatasheetCout =
| 0.10 2π · 120 · 330 · 10⁻⁶ Ω = 0.40Ω

ESRcombined =

| ESR
| 6 = 67mΩ
C.1.4 | Input Filter

DC resistance for three of the filter inductances. These are the three which have the most current flowing through them. DCRLf0 = 11.3mΩ
DCRLf1 = 18mΩ
DCRLf2 = 16mΩ

90

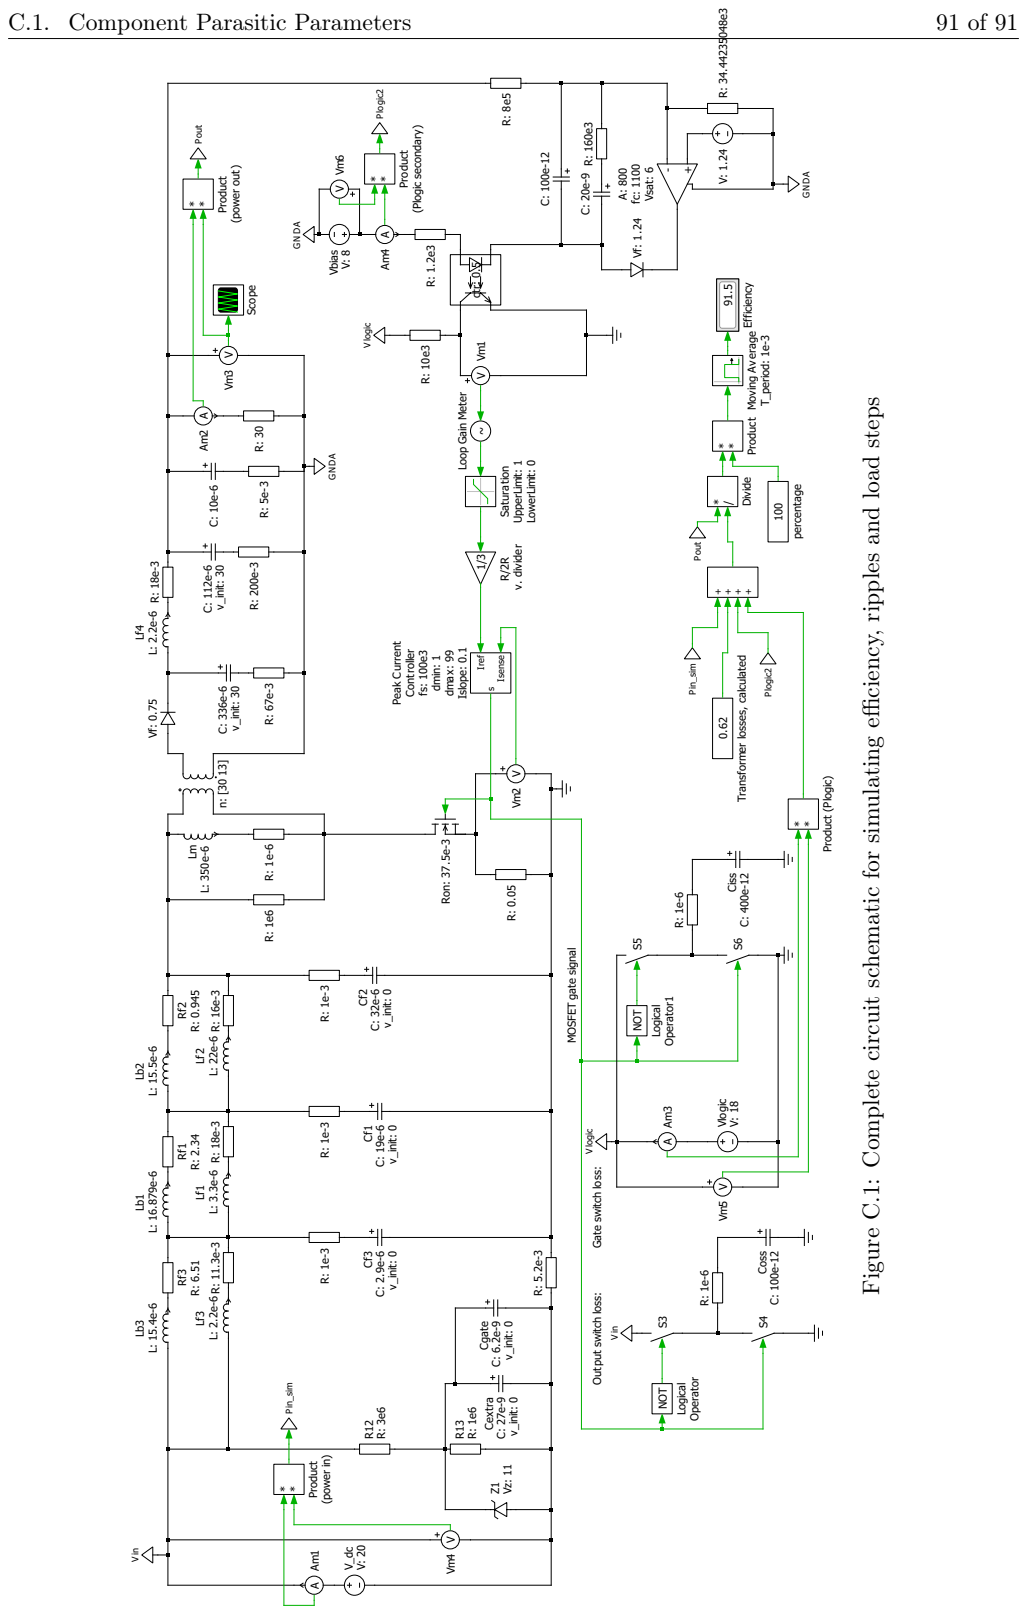
[picture p75: page 98]
C.1. Component Parasitic Parameters; v_init: 30; Ron: 37.5e-3; v. divider; Peak Current; Controller; dmin: 1; dmax: 99; Islope: 0.1; Isense; Iref; Vsat: 6; ctr: 0.5; Saturation; UpperLimit: 1; LowerLimit: 0; Vbias; GNDA; Cextra; v_init: 0; Cgate; Scope; S3 NOT; Logical; Operator; Coss; S5 NOT; Operator1; Ciss; Vlogic; Product; (power in); (power out); Pin_sim; Pout; Divide; percentage; Moving Average; T_period: 1e-3; V logic; Product (Plogic); (Plogic secondary); Plogic2; Efficiency

Loop Gain Meter

MOSFET gate signal Figure C.1: Complete circuit schematic for simulating efficiency, ripples and load steps

Transformer losses, calculated

Output switch loss: Gate switch loss:
