ChristianLumby/Power2LabPowerSupply/31352_Flyback/Sheet2_19-01-17.pdf

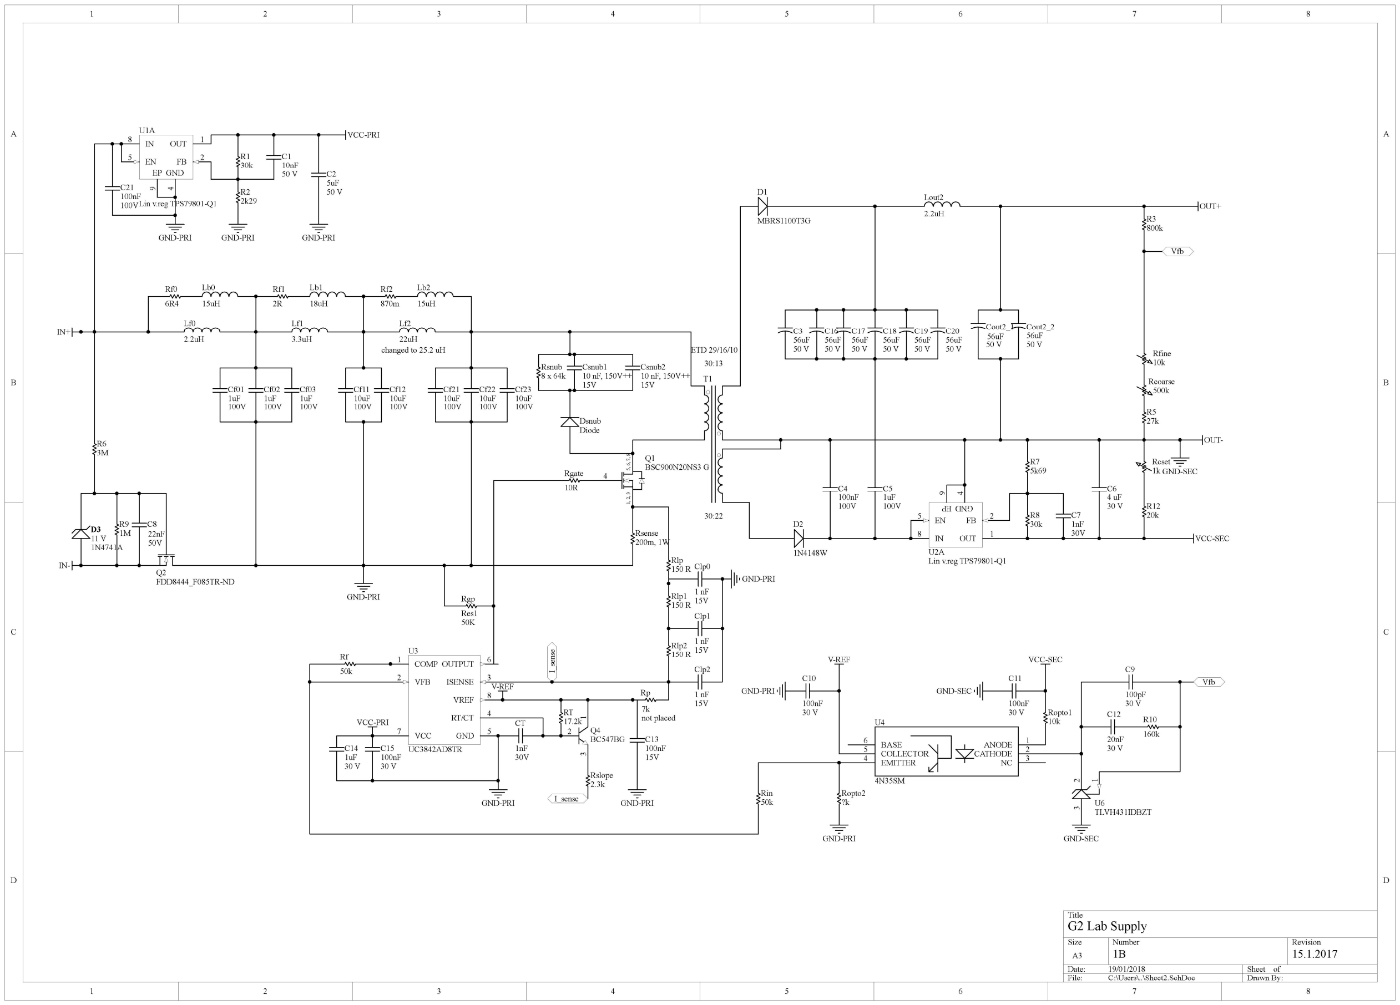
[picture p76: page 1]

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
Title

Size | Number | Revision
A3
Date: | 19/01/2018 | Sheet of
File: | C:\Users\..\Sheet2.SchDoc | Drawn By:

R6
3M

R9
1M
50V

C8
22nF

Q2
FDD8444_F085TR-ND

1N4741A

D3

### 11 V

Lf0
2.2uH

Lf1
3.3uH

Lf2
22uH

Lb0
15uH

Lb1
18uH

Lb2
15uH

Rf0
6R4

Rf1
2R

Rf2
870m

100V

Cf01
1uF
100V

Cf02
1uF
100V

Cf03
1uF
100V

Cf11
10uF

COMP 1

VFB 2

ISENSE | 3
RT/CT | 4
GND | 5
OUTPUT | 6

VCC 7

VREF 8

U3

UC3842AD8TR

Rgate
10R

GND-PRI

D1

MBRS1100T3G | R3 800k

R5
27k

OUT+

100V

C5
1uF

D2

1N4148W

R8
30k

R7
5k69

30V

C7
1nF

### 30 V

C6

### 4 uF

100V

C4
100nF

30:13

30:22

GND-SEC

ANODE | 1
CATHODE | 2
NC | 3 EMITTER 4

COLLECTOR 5

BASE 6

U4

4N35SM

Ropto1
10k

R1
30k

R2
2k29

### 50 V

C1
10nF

### 50 V

C2
5uF
OUT | 1
FB | 2 4

EN 5

IN 8

GND 9

EP

U1A

Lin v.reg TPS79801-Q1

GND-PRI | GND-PRI | GND-PRI

Ropto2
?k

GND-PRI

Rsense
200m, 1W

Rlp
150 R

15V

Clp0

### 1 nF

RT
17.2k

30V

CT

1nF

Rin
50k

Rf
50k

### 30 V

C15

100nF | 15V C13
| 100nF

### 30 V

C11

100nF

GND-SEC

### 30 V

C10

100nF

GND-PRI

## G2 Lab Supply

1B

ETD 29/16/10

VCC-SEC

IN+

IN-

2

1

3

U6
TLVH431IDBZT

### 30 V

C14
1uF

100V

Cf12
10uF
100V

Cf21
10uF
100V

Cf22
10uF
100V

Cf23
10uF

VCC-PRI

T1

VCC-SEC

Rcoarse
500k

56uF

### 50 V

C3

OUT | 1
FB | 2 ⁴

EN 5

IN 8 | GND

### 9 EP

U2A
Lin v.reg TPS79801-Q1

GND-PRI

### 30 V

C12

20nF

### 30 V

C9

100pF

R10
160k

GND-PRI

VCC-PRI

56uF

### 50 V

C16
56uF

### 50 V

C17
56uF

### 50 V

C18
56uF

### 50 V

C19
56uF

### 50 V

C20 56uF 50 V

Cout2_1
56uF

### 50 V

Cout2_2

Lout2
2.2uH

7k

Rp

not placed

4 5, 6, 7, 8 1, 2, 3
Q1
BSC900N20NS3 G

100V

C21
100nF

50K

Rgp
Res1

R12
20k

Rcset
1k

Rfine
10k

GND-SEC

OUT-

Vfb

Vfb

## 15.1.2017 I_sense 1

2 3

Q4
BC547BG

2.3k

Rslope

I_sense

GND-PRI

Rlp1
150 R

15V

Clp1

### 1 nF Rlp2

150 R

15V

Clp2

### 1 nF

Dsnub
Diode

Rsnub

### 8 x 64k

15V

Csnub1

### 10 nF, 150V++

15V

Csnub2

### 10 nF, 150V++

V-REF

V-REF

changed to 25.2 uH
