ChristianLumby/Power2LabPowerSupply/31352_Flyback/Sheet2_15-01-17.pdf

15.1.2017

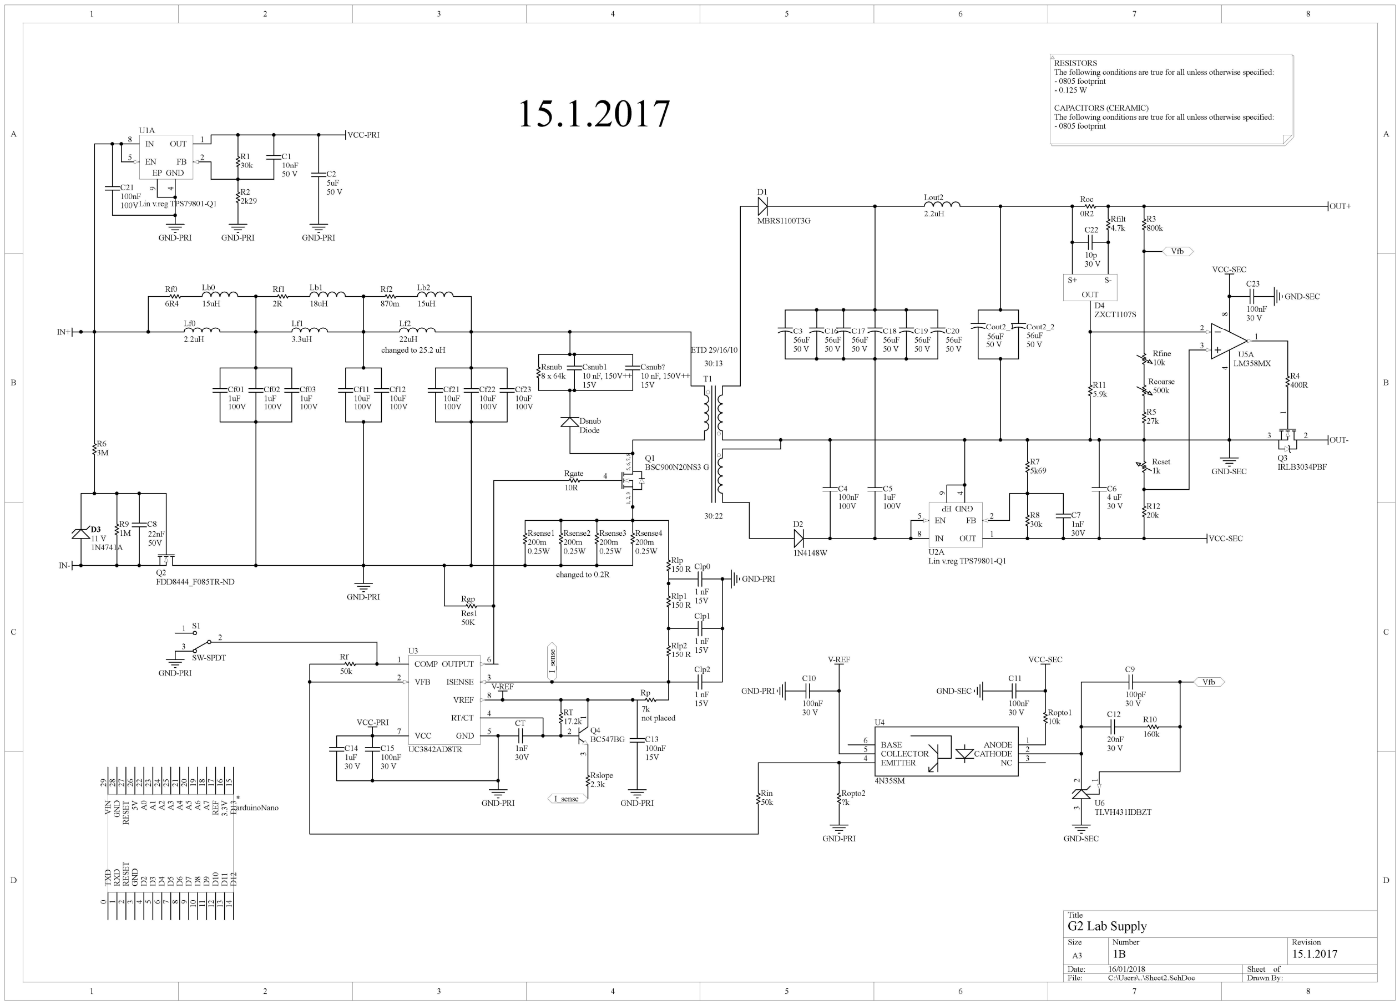
[picture p77: page 1]

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
Title

Size | Number | Revision
A3
Date: | 16/01/2018 | Sheet of
File: | C:\Users\..\Sheet2.SchDoc | Drawn By:

R6
3M

R9
1M
50V

C8
22nF

Q2
FDD8444_F085TR-ND

1N4741A

D3

### 11 V

Lf0
2.2uH

Lf1
3.3uH

Lf2
22uH

Lb0
15uH

Lb1
18uH

Lb2
15uH

Rf0
6R4

Rf1
2R

Rf2
870m

100V

Cf01
1uF
100V

Cf02
1uF
100V

Cf03
1uF
100V

Cf11
10uF

COMP 1

VFB 2

ISENSE | 3
RT/CT | 4
GND | 5
OUTPUT | 6

VCC 7

VREF 8

U3

UC3842AD8TR

Rgate
10R

GND-PRI

D1

MBRS1100T3G | R3 800k

R5
27k

OUT+

100V

C5
1uF

D2

1N4148W

R8
30k

R7
5k69

30V

C7
1nF

### 30 V

C6

### 4 uF

100V

C4
100nF

30:13

30:22

GND-SEC

ANODE | 1
CATHODE | 2
NC | 3 EMITTER 4

COLLECTOR 5

BASE 6

U4

4N35SM

Ropto1
10k

R1
30k

R2
2k29

### 50 V

C1
10nF

### 50 V

C2
5uF
OUT | 1
FB | 2 4

EN 5

IN 8

GND 9

EP

U1A

Lin v.reg TPS79801-Q1

GND-PRI | GND-PRI | GND-PRI

Ropto2
?k

GND-PRI

0.25W

Rsense4
200m

Rlp
150 R

15V

Clp0

### 1 nF

RT
17.2k

30V

CT

1nF

Rin
50k

Rf
50k

### 30 V

C15

100nF | 15V C13
| 100nF

### 30 V

C11

100nF

GND-SEC

### 30 V

C10

100nF

GND-PRI

## G2 Lab Supply

1B

ETD 29/16/10

VCC-SEC

IN+

IN-

2
3

### 1 S1

SW-SPDT
GND-PRI | 2

1

3

U6
TLVH431IDBZT

### 30 V

C14
1uF

100V

Cf12
10uF
100V

Cf21
10uF
100V

Cf22
10uF
100V

Cf23
10uF

0.25W

Rsense3
200m
0.25W

Rsense2
200m
0.25W

Rsense1
200m

VCC-PRI

T1

VCC-SEC

Rcoarse
500k

56uF

### 50 V

C3

OUT | 1
FB | 2 ⁴

EN 5

IN 8 | GND

### 9 EP

U2A
Lin v.reg TPS79801-Q1

GND-PRI

### 30 V

C12

20nF

### 30 V

C9

100pF

R10
160k

GND-PRI

VCC-PRI

56uF

### 50 V

C16
56uF

### 50 V

C17
56uF

### 50 V

C18
56uF

### 50 V

C19
56uF

### 50 V

C20 56uF 50 V

Cout2_1
56uF

### 50 V

Cout2_2

Lout2
2.2uH

7k

Rp

not placed

4 5, 6, 7, 8 1, 2, 3
Q1
BSC900N20NS3 G

100V

C21
100nF

50K

Rgp
Res1

R12
20k

Roc
0R2

Rcset
1k

Rfine
10k

OUT

S+ | S-
| D4 ZXCT1107S

R11
5.9k

### 2 ¹

3

Q3
IRLB3034PBF

R4
400R

### 30 V

C22

10p

3

2

### 1 ⁸ 4

U5A
LM358MX

GND-SEC

VCC-SEC

Rfilt
4.7k

OUT-

### 30 V

C23

100nF

GND-SEC

Vfb

Vfb TXD

### 0 RXD

### 1 RESET

### 2 GND

### 3 D2

### 4 D3

### 5 D4

### 6 D5

### 7 D6

### 8 D7

9 D8 10 D9 11 D10 12 D11 13 D12 14 D13 15 3.3V 16 REF 17 A7 18 A6 19 A5 20 A4 21 A0 22 A1 23 A2 24 A3 25 5V 26 RESET 27 GND 28 VIN 29
*
arduinoNano

## 15.1.2017 I_sense 1

2 3

Q4
BC547BG

2.3k

Rslope

I_sense

GND-PRI

Rlp1
150 R

15V

Clp1

### 1 nF Rlp2

150 R

15V

Clp2

### 1 nF

Dsnub
Diode

Rsnub

### 8 x 64k

15V

Csnub1

### 10 nF, 150V++

15V

Csnub?

### 10 nF, 150V++

V-REF

V-REF

changed to 0.2R

changed to 25.2 uH

RESISTORS
The following conditions are true for all unless otherwise specified:
- 0805 footprint
- 0.125 W

CAPACITORS (CERAMIC)
The following conditions are true for all unless otherwise specified:
- 0805 footprint
