ChristianLumby/Power2LabPowerSupply/picture_of_converter.png

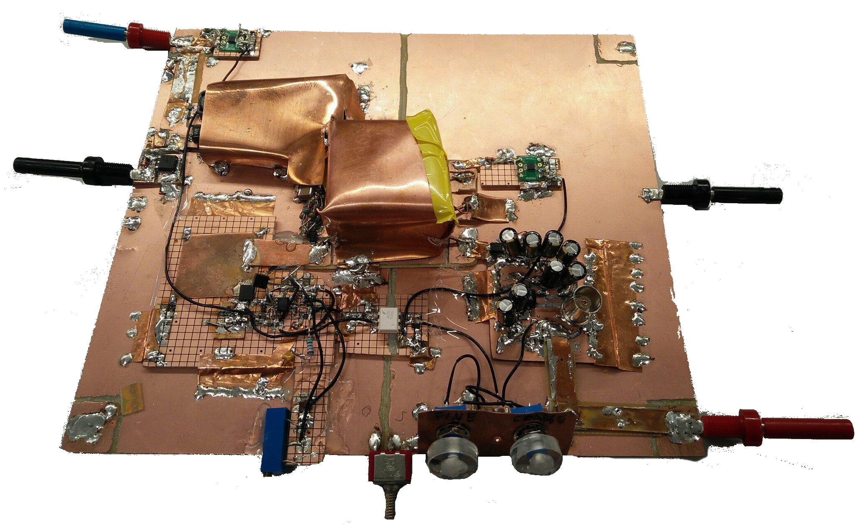
picture_of_converter.png
