ChristianLumby/Power2LabPowerSupply/picture_of_converter_no_edit.jpg

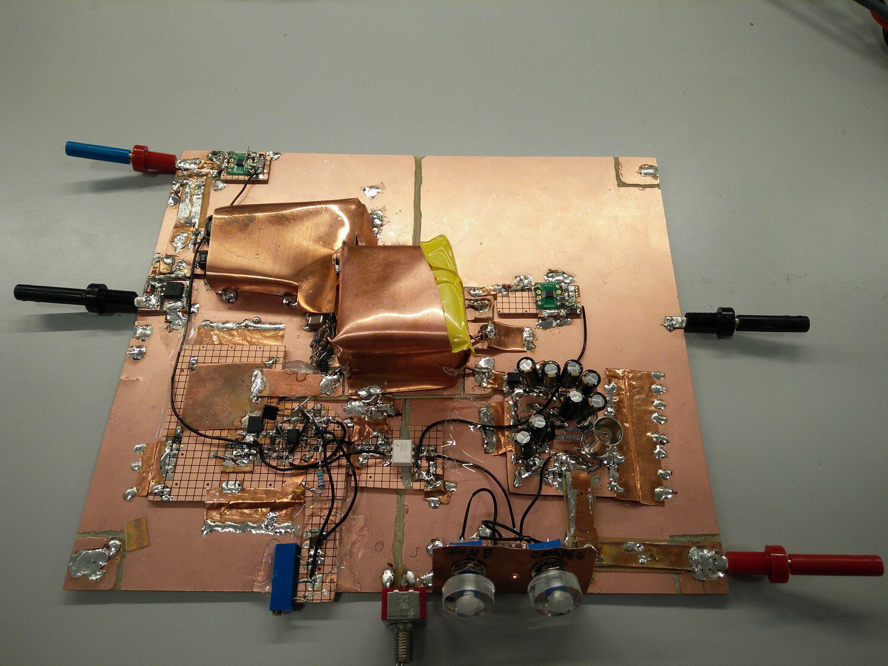
picture_of_converter_no_edit.jpg
