ChristianLumby/Power2LabPowerSupply/voltage_and_current_reference_arduino.jpg

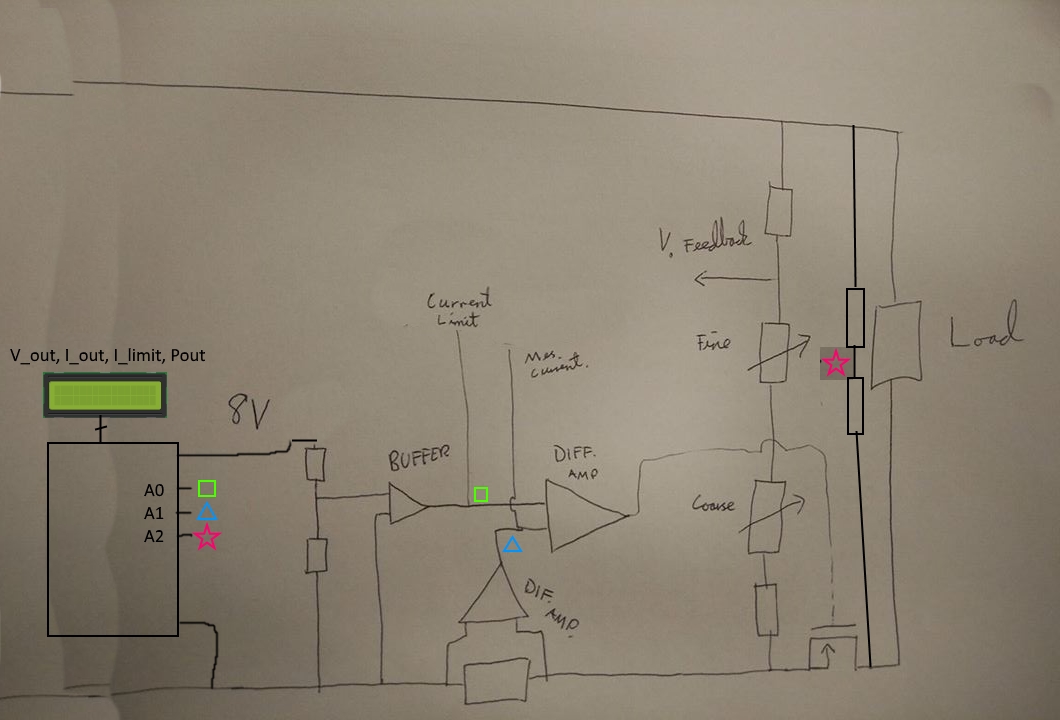
voltage_and_current_reference_arduino.jpg
