ChristianLumby/Power2LabPowerSupply/BOM.xlsx

BOM - 30 W Lab Power Supply
Circuit Block | Designator | Type | Value | Comment | Manufacturer | Manufacturer Part No. | Distributor | Distributor Part No. | Order Status | Received
Input Filter | Cf01 | Cap | 1 uF | 100V | TDK | C3216X7R2A105K160AA | RS | 740-7590 |  | 10
 | Cf02 | Cap | 1 uF | 100V | TDK | C3216X7R2A105K160AA | RS | 740-7590 |  | -
 | Cf03 | Cap | 1 uF | 100V | TDK | C3216X7R2A105K160AA | RS | 740-7590 |  | -
 | Cf11 | Cap | 10 uF | 100V | Murata | KCM55TR72A106MH01K | Mouser | 81-KCM55TR72A106MH1K
 | Cf12 | Cap | 10 uF | 100V | Murata | KCM55TR72A106MH01K | Mouser | 81-KCM55TR72A106MH1K
 | Cf21 | Cap | 10 uF | 100V | Murata | KCM55TR72A106MH01K | Mouser | 81-KCM55TR72A106MH1K
 | Cf22 | Cap | 10 uF | 100V | Murata | KCM55TR72A106MH01K | Mouser | 81-KCM55TR72A106MH1K
 | Cf23 | Cap | 10 uF | 100V | Murata | KCM55TR72A106MH01K | Mouser | 81-KCM55TR72A106MH1K
 | Lf0 | Ind | 2.2 uH |  | Wurth | 744316220 | RS |  |  | 2
 | Lf1 | Ind | 3.3 uH |  | Wurth | 7443340330 | RS |  |  | 2
 | Lf2 | Ind | 22 uH |  | J.W. Miller | PM5022S-220M-RC | Mouser | 542-PM5022S-220M-RC
 | Lb0 | Ind | 15 uH |  | Coilcraft |  | Lab stock |  |  | 2
 | Lb1 | Ind | 18 uH |  | Coilcraft |  | Lab stock |  |  | 2
 | Lb2 | Ind | 15 uH |  | Coilcraft |  | Lab stock |  |  | -
 | Rf0 | Res | 6.4 R |  | - | - | Lab stock | -
 | Rf1 | Res | 2 R |  | - | - | Lab stock | -
 | Rf2 | Res | 870 m |  | - | - | Lab stock | -
Output Filter | C3 | Cap | 56 uF | 50 V | Panasonic | EEU-FM1H560 | RS | 526-1711P |  | 50
 | C16 | Cap | 56 uF | 50 V | Panasonic | EEU-FM1H560 | RS | 526-1711P |  | -
 | C17 | Cap | 56 uF | 50 V | Panasonic | EEU-FM1H560 | RS | 526-1711P |  | -
 | C18 | Cap | 56 uF | 50 V | Panasonic | EEU-FM1H560 | RS | 526-1711P |  | -
 | C19 | Cap | 56 uF | 50 V | Panasonic | EEU-FM1H560 | RS | 526-1711P |  | -
 | C20 | Cap | 56 uF | 50 V | Panasonic | EEU-FM1H560 | RS | 526-1711P |  | -
 | Lout2 | Ind | 2.2 uH |  | Coilcraft |  | Lab stock
 | Cout2_1 | Cap | 56 uF | 50 V | Panasonic | EEU-FM1H560 | RS | 526-1711P |  | -
 | Cout2_2 | Cap | 56 uF | 50 V | Panasonic | EEU-FM1H560 | RS | 526-1711P |  | -
 | Rcoarse | Pot | 500 k | Single turn, linear | Bourns |  | RS | 522-0704 |  | 2
 | Rfine | Pot | 10 k | Single turn, linear | Bourns |  | RS | 522-0625 |  | 2
 | R3 | Res |  |  |  |  | Lab stock
 | R5 | Res |  |  |  |  | Lab stock
Inrush Limiter | D3 | Zener | 11V |  |  | 1N4741A | Mouser | 512-1N4741A
 | C8 | Cap | 22 nF | 50V | - | - | Lab stock | -
 | Q2 | FET | - | - | Fairchild | FDD8444_F085 | RS | 864-8111 |  | 5
 | R6 | Res | 3M |  | - | - | Lab stock | -
 | R9 | Res | 1M |  | - | - | Lab stock | -
Primary Regulator | U1A | Lin Reg | - | adj, used to give 18 V | TI | TPS79801QDGNRQ1 | Mouser | 595-TPS79801QDGNRQ1
 | R1 | Res | 30 k |  | - | - | Lab stock
 | R2 | Res | 2.29 k |  | - | - | Lab stock
 | C1 | Cap | 10 nF | 50 V | - | - | Lab stock
 | C2 | Cap | 100 nF | 50 V | - | - | Lab stock
 | C21 | Cap | 100 nF | 100 V | Murata |  | RS | 723-5058 |  | 10, but wrong part number
Secondary Regulator | U2A | Lin Reg | - | adj, used to give 18 V | TI | TPS79801QDGNRQ1 | Mouser | 595-TPS79801QDGNRQ1
 | D2 | Diode | - | Signal diode |  | 1N4148 | Lab stock
 | C4 | Cap | 100 nF | 100 V | Murata |  | RS | 723-5058 |  | -
 | C5 | Cap | 1 uF | 100 V | TDK | C3216X7R2A105K160AA | RS | 740-7590 |  | -
 | C7 | Cap | 10 nF | 30 V | - | - | Lab stock | -
 | C6 | Cap | 100 nF | 30 V | - | - | Lab stock
 | R7 | Res | 5.69 k |  | - | - | Lab stock | -
 | R8 | Res | 30 k |  | - | - | Lab stock | -
Power Stage | Q1 | FET | - | 200 V | Infineon | BSC900N20NS3 G | RS |  |  | 10
 | Core1 | Core | - | ETD 29/16/10, gapped, half | Epcos | FS-1ETD-2910-02 | RS | 840-7496
 | BOB1 | Bobbin |  | ETD 29/16/10 | Epcos | FS-2ETD-2910-20 | RS | 840-7333
 | W1 | Wire |  | Primary wire, 1.1mm cu | - | - | Lab stock | -
 | W2 | Wire |  | Secondary wire, 1.32mm cu | - | - | Lab stock | -
 | W3 | Wire |  | Tertiary wire, 0.70mm cu | - | - | Lab stock | -
 | Rgate | Res | 10 R |  | - | - | Lab stock | -
 | Rsense1 | Res | 200 m | 0.25 W | KOA Speer | SR732ATTDR200F | Mouser | 660-SR732ATTER200F
 | Rsense2 | Res | 200 m | 0.25 W | KOA Speer | SR732ATTDR200F | Mouser | 660-SR732ATTER200F
 | Rsense3 | Res | 200 m | 0.25 W | KOA Speer | SR732ATTDR200F | Mouser | 660-SR732ATTER200F
 | Rsense4 | Res | 200 m | 0.25 W | KOA Speer | SR732ATTDR200F | Mouser | 660-SR732ATTER200F
 | D1 | Diode |  | Output diode | ON Semi | MBRS1100T3G | RS | 545-2052 |  | 3
Feedback | C9 | Cap | 100 pF | 30 V | - | - | Lab stock | -
 | C12 | Cap | 20 nF | 30 V | - | - | Lab stock | -
 | C11 | Cap | 100 nF | 30 V | - | - | Lab stock | -
 | C10 | Cap | 100 nF | 30 V | - | - | Lab stock | -
 | R10 | Res | 160 k |  | - | - | Lab stock | -
 | Ropto1 | Res | 10 k |  | - | - | Lab stock | -
 | Ropto2 | Res | 10 k |  | - | - | Lab stock | -
 | U6 | Shunt. Reg | - | 1.24V ref | TI | TLVH431BCDBZT | RS | 661-9641
 | U4 | Opto | - | 50% CTR | Fairchild | 4N35SM | RS | 917-5447
 | U3 | Current ctrl. | - |  | TI | UC3842AD8 | RS | 661-5314
 | Rin | Res | 50 k |  | - | - | Lab stock | -
 | Rslope | Res | 24.3 k |  | - | - | Lab stock | -
 | RT | Res | 1 k |  | - | - | Lab stock | -
 | Rp | Res | - | not populated | - | - | Lab stock | -
 | Rlp | Res | 10 k |  | - | - | Lab stock | -
 | Rf | Res | 50 k |  | - | - | Lab stock | -
 | Clp | Cap | 50 pF | 15 V | - | - | Lab stock | -
 | C13 | Cap | 100 nF | 15 V | - | - | Lab stock | -
 | CT | Cap | 17.2 nF | 30 V | - | - | Lab stock | -
 | C15 | Cap | 100 nF | 30 V | - | - | Lab stock | -
 | C14 | Cap | 1 uF | 30 V | - | - | Lab stock | -
Snubber
Current limiting circuit
 | Roc | Res | 0.2 R | Sense resistor at output | KOA Speer | SR732ATTDR200F | Mouser | 660-SR732ATTER200F
 | D4 | Current sensor IC |  |  | Diodes INC | ZXCT1109SA-7 | Mouser | 522-ZXCT1109SA-7
 | U5A | Op AMP |  | LM358 | - | - | Lab stock | -
 | Rcset | Pot | 1 k |  | Bourns | PTV09A-4225F-B102 | RS | 737-7821 |  | 2
 | Q3 | MOSFET |  | IRLB4030PbF | - | - | Lab stock | -
 | C22 | Cap | 10 pF |  | - | - | Lab stock | -
 | C23 | Cap | 100 nF |  | - | - | Lab stock | -
 | Rfilt | Res | 4.7 k |  | - | - | Lab stock | -
 | R4 | Res | 400 R |  | - | - | Lab stock | -
 | R12 | Res | 20 k |  | - | - | Lab stock | -
General | B1 | Connector |  | Banana jack | - | - | Lab stock | -
 | B2 | Connector |  | Banana jack | - | - | Lab stock | -
 | B3 | Connector |  | Banana jack | - | - | Lab stock | -
 | B4 | Connector |  | Banana jack | - | - | Lab stock | -
 | H1 | Heatsink | 3 K/W | Heatsink |  | FA-T220-64E | RS | 893-4942
 | S1 | Switch |  | Enable, |  |  | Lab stock
