ChristianLumby/Power2LabPowerSupply/31352_Flyback/arduino-nano--1.snapshot.4/arduino nano290313/reset button.SLDASM

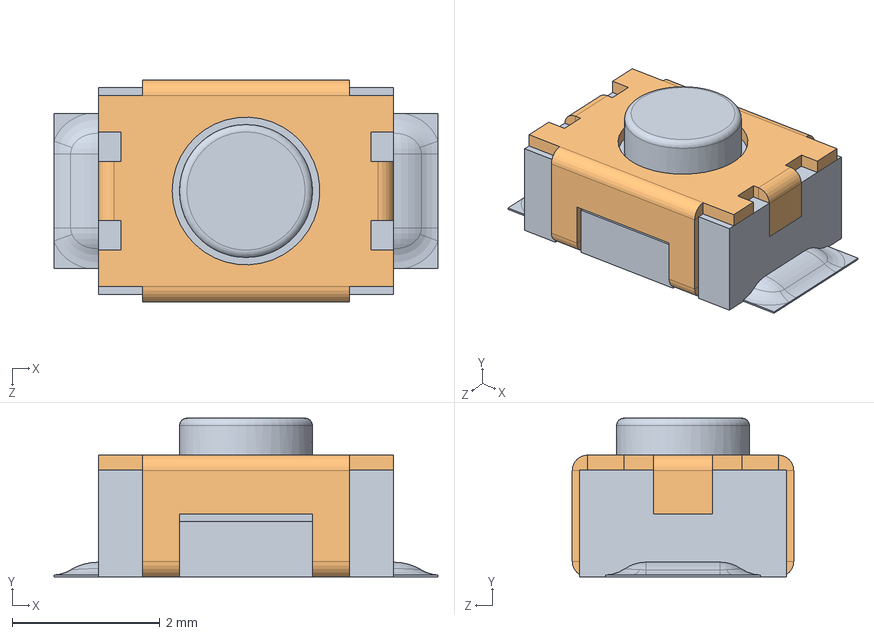
[picture p82: CAD file, 2018-01-09]
31352_Flyback/arduino-nano--1.snapshot.4/arduino nano290313/reset button.SLDASM
5.20 x 2.15 x 3.00 mm
reset core
reset shell
