ChristianLumby/Power2LabPowerSupply/31352_Flyback/3D/LCD/LCD/LCD.SLDASM

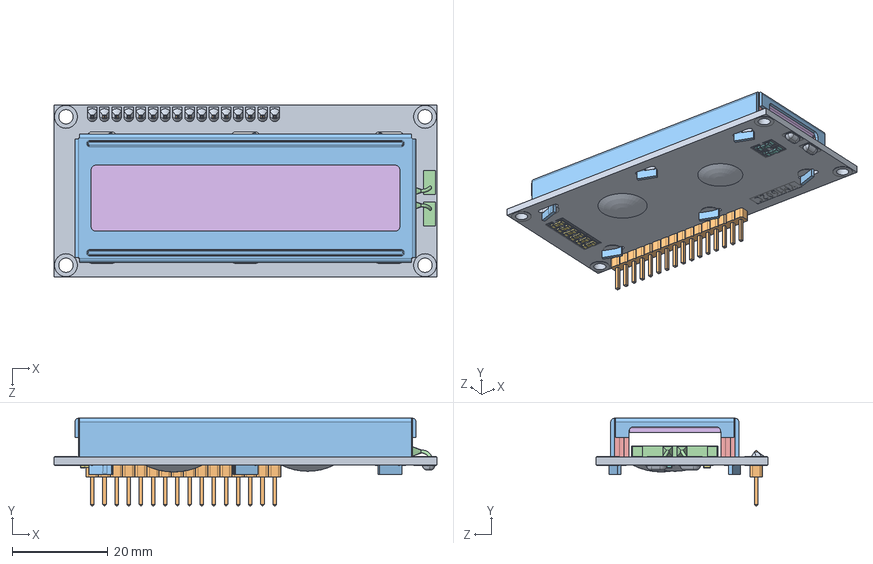
[picture p83: CAD file, 2018-01-25]
31352_Flyback/3D/LCD/LCD/LCD.SLDASM
80.0 x 18.3 x 36.0 mm
pcbboard
16pin_header__
lcd window
backlight
conductor x 2
liquid crystal grabcad
smt_resistor222 x 6
smt_resistor101 x 2
