ChristianLumby/Power2LabPowerSupply/31352_Flyback/arduino-nano--1.snapshot.4/arduino nano290313/MINIUSB - MEASURED.SLDASM

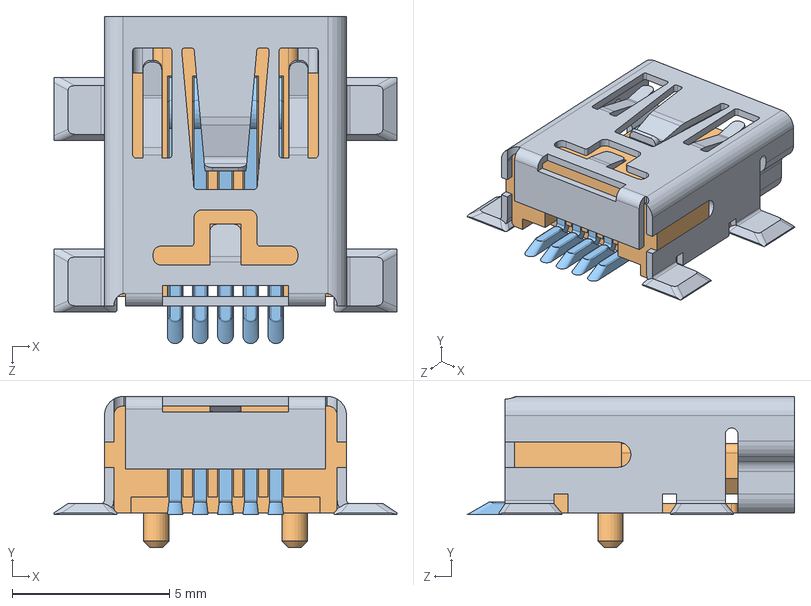
[picture p84: CAD file, 2018-01-09]
31352_Flyback/arduino-nano--1.snapshot.4/arduino nano290313/MINIUSB - MEASURED.SLDASM
10.9 x 4.80 x 10.4 mm
MINIUSBSHELL
MINIUSBCORE
MINI USB CONTACT x 5
