ChristianLumby/Power2LabPowerSupply/31352_Flyback/3D/LCD/LCD/conductor.SLDPRT

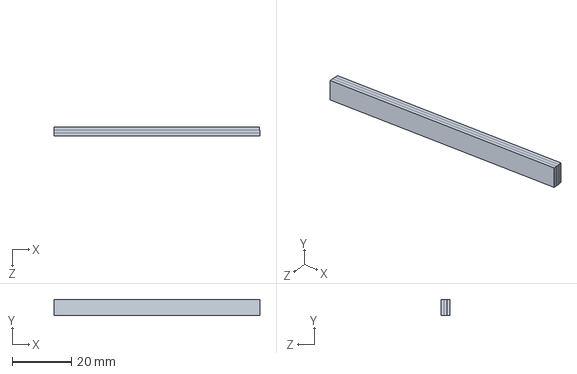
[picture p85: CAD file, 2018-01-25]
31352_Flyback/3D/LCD/LCD/conductor.SLDPRT
69.7 x 5.50 x 3.00 mm
