ChristianLumby/Power2LabPowerSupply/31352_Flyback/arduino-nano--1.snapshot.4/arduino nano290313/smt_resistor222.sldprt

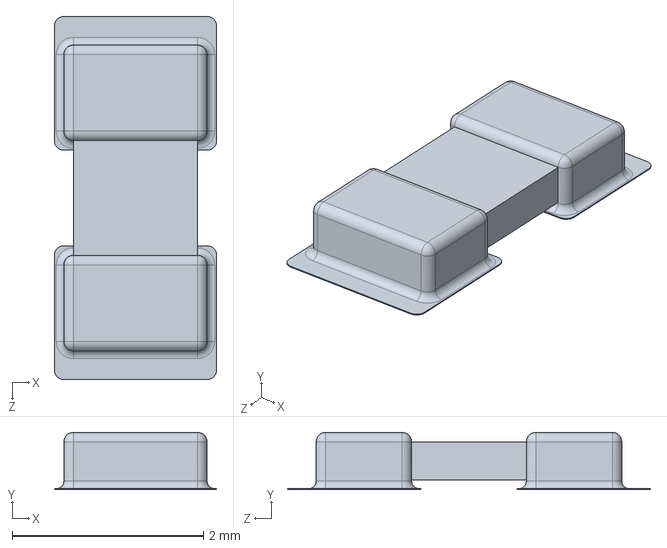
[picture p86: CAD file, 2018-01-09]
31352_Flyback/arduino-nano--1.snapshot.4/arduino nano290313/smt_resistor222.sldprt
1.70 x 0.6 x 3.80 mm
