ChristianLumby/Power2LabPowerSupply/31352_Flyback/3D/LCD/LCD/smt_resistor222.sldprt

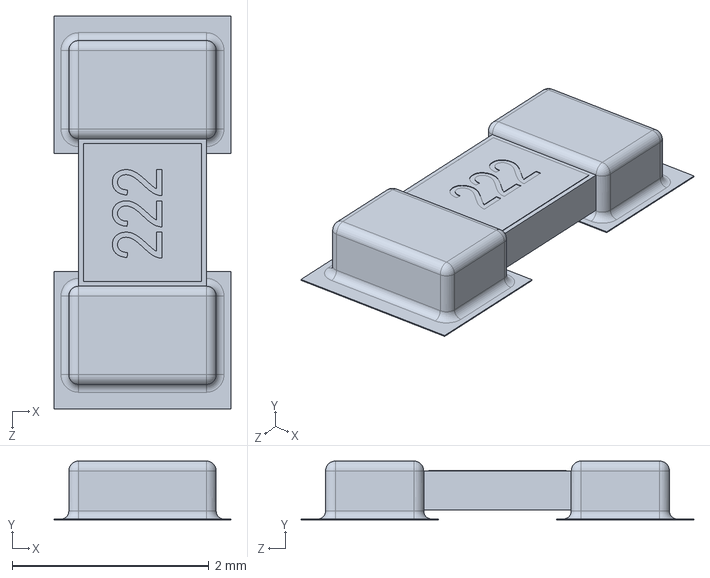
[picture p87: CAD file, 2018-01-25]
31352_Flyback/3D/LCD/LCD/smt_resistor222.sldprt
1.80 x 0.6 x 4.00 mm
