ChristianLumby/Power2LabPowerSupply/31352_Flyback/3D/Pot_10k_fine.SLDPRT

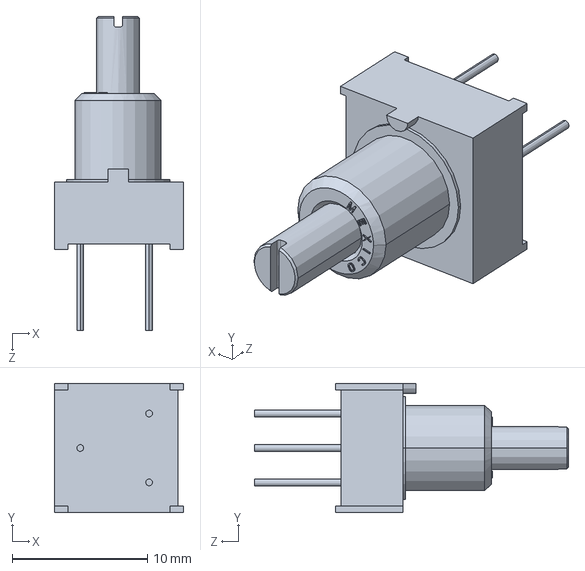
[picture p88: CAD file, 2018-01-16]
31352_Flyback/3D/Pot_10k_fine.SLDPRT
9.53 x 9.53 x 23.2 mm
