ChristianLumby/Power2LabPowerSupply/31352_Flyback/3D/LCD/LCD/lcd window.SLDPRT

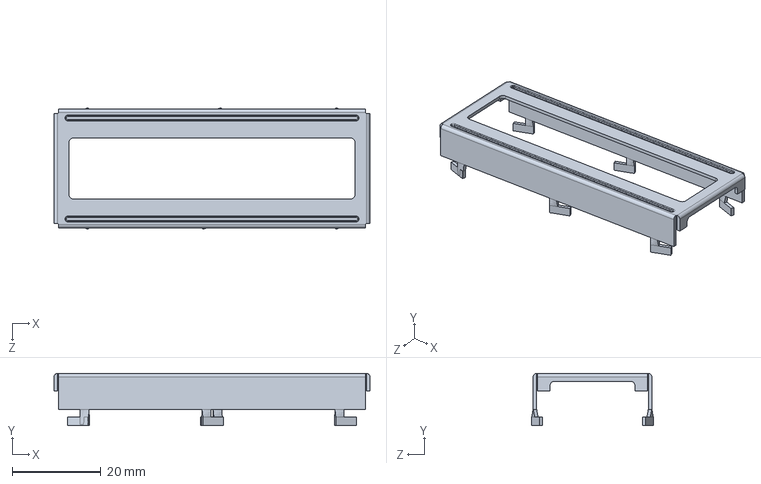
[picture p89: CAD file, 2018-01-25]
31352_Flyback/3D/LCD/LCD/lcd window.SLDPRT
71.3 x 11.8 x 27.4 mm
