ChristianLumby/Power2LabPowerSupply/31352_Flyback/3D/Pot_1k_curr.SLDPRT

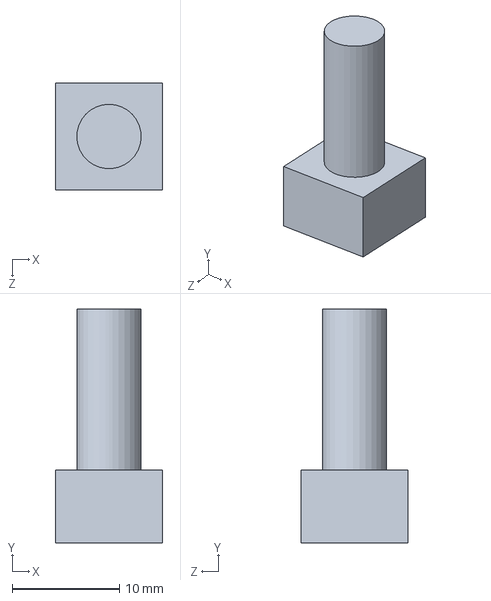
[picture p90: CAD file, 2018-01-16]
31352_Flyback/3D/Pot_1k_curr.SLDPRT
10.0 x 21.8 x 10.0 mm
