ChristianLumby/Power2LabPowerSupply/31352_Flyback/3D/LCD/LCD/smt_resistor101.sldprt

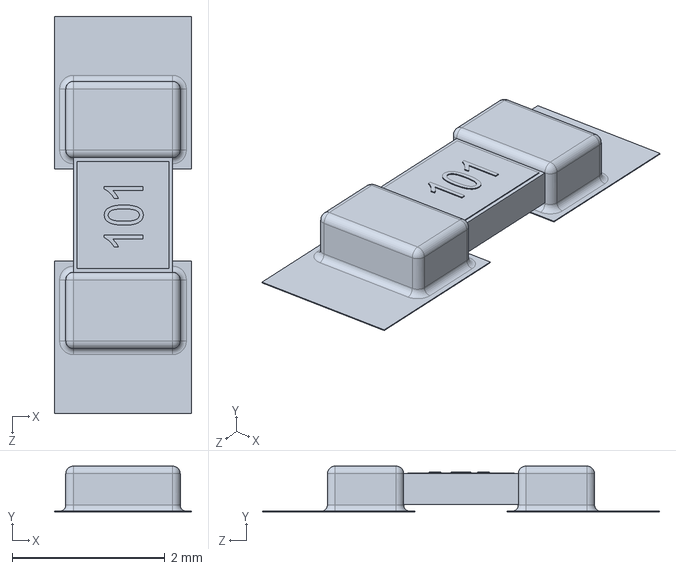
[picture p91: CAD file, 2018-01-25]
31352_Flyback/3D/LCD/LCD/smt_resistor101.sldprt
1.80 x 0.6 x 5.20 mm
