ChristianLumby/Power2LabPowerSupply/31352_Flyback/arduino-nano--1.snapshot.4/arduino nano290313/MINI USB CONTACT.SLDPRT

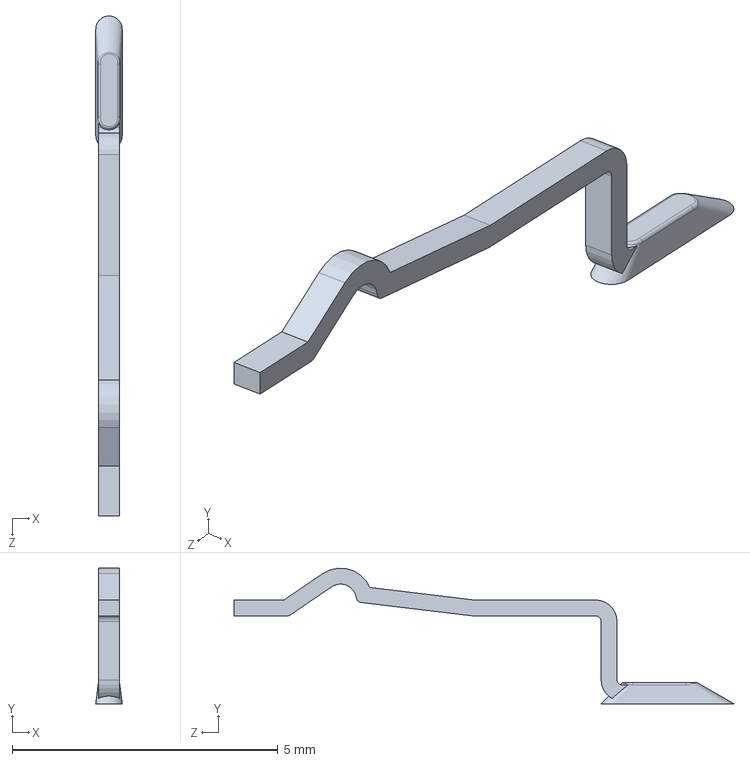
[picture p92: CAD file, 2018-01-09]
31352_Flyback/arduino-nano--1.snapshot.4/arduino nano290313/MINI USB CONTACT.SLDPRT
0.5 x 2.55 x 9.40 mm
