ChristianLumby/Power2LabPowerSupply/31352_Flyback/3D/Banana_jack_black.STEP

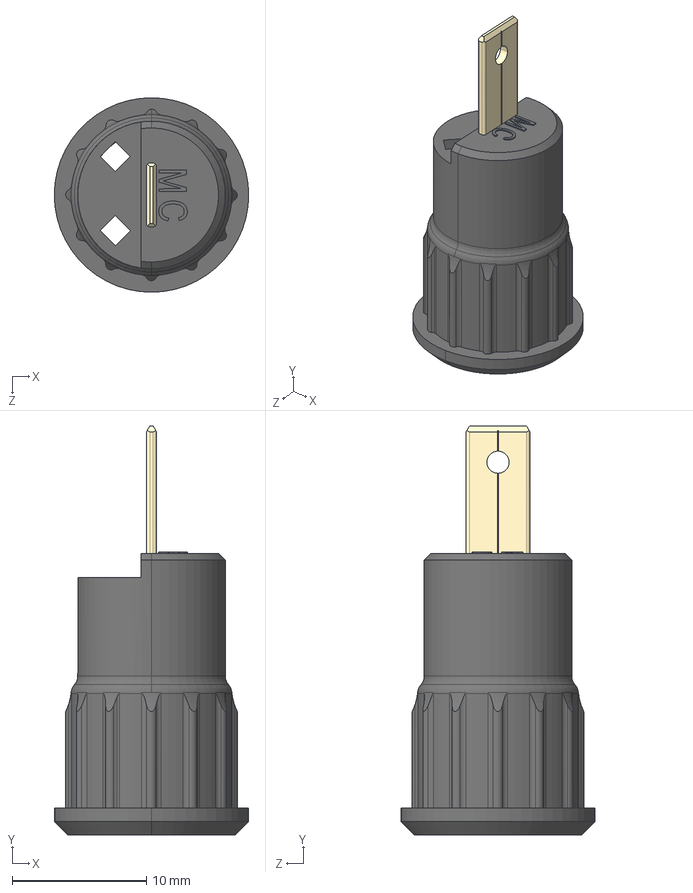
[picture p93: CAD file, 2018-01-16]
31352_Flyback/3D/Banana_jack_black.STEP
14.5 x 30.5 x 14.5 mm
