ChristianLumby/Power2LabPowerSupply/31352_Flyback/arduino-nano--1.snapshot.4/arduino nano290313/189 RESISTOR PACK.SLDPRT

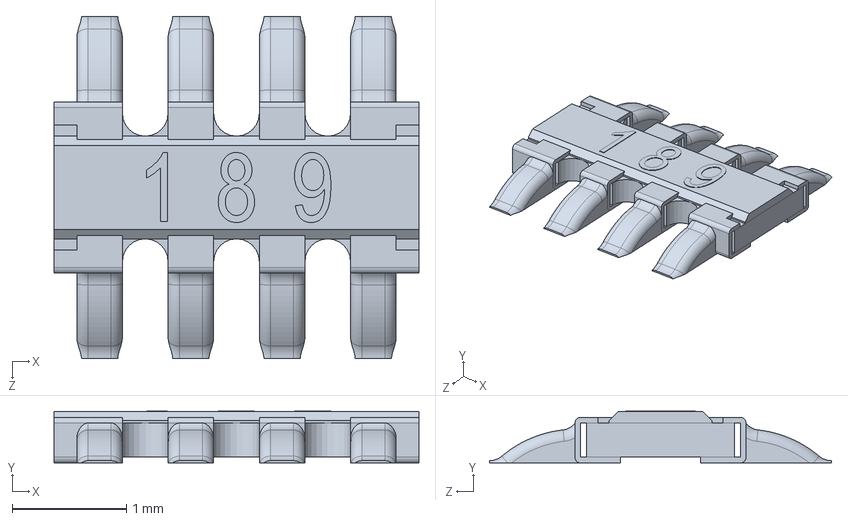
[picture p94: CAD file, 2018-01-09]
31352_Flyback/arduino-nano--1.snapshot.4/arduino nano290313/189 RESISTOR PACK.SLDPRT
3.20 x 0.455 x 3.00 mm
