ChristianLumby/Power2LabPowerSupply/31352_Flyback/3D/LCD/LCD/backlight.SLDPRT

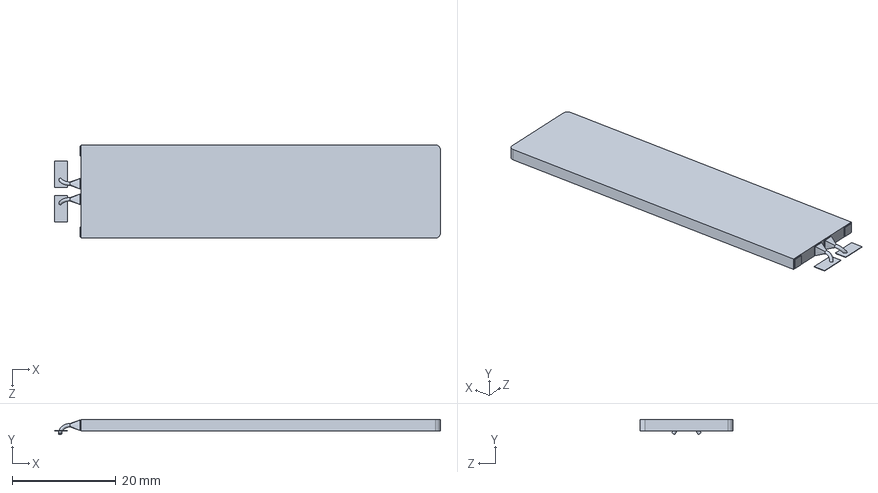
[picture p95: CAD file, 2018-01-25]
31352_Flyback/3D/LCD/LCD/backlight.SLDPRT
74.4 x 2.98 x 18.0 mm
