ChristianLumby/Power2LabPowerSupply/31352_Flyback/arduino-nano--1.snapshot.4/arduino nano290313/MINIUSBCORE.SLDPRT

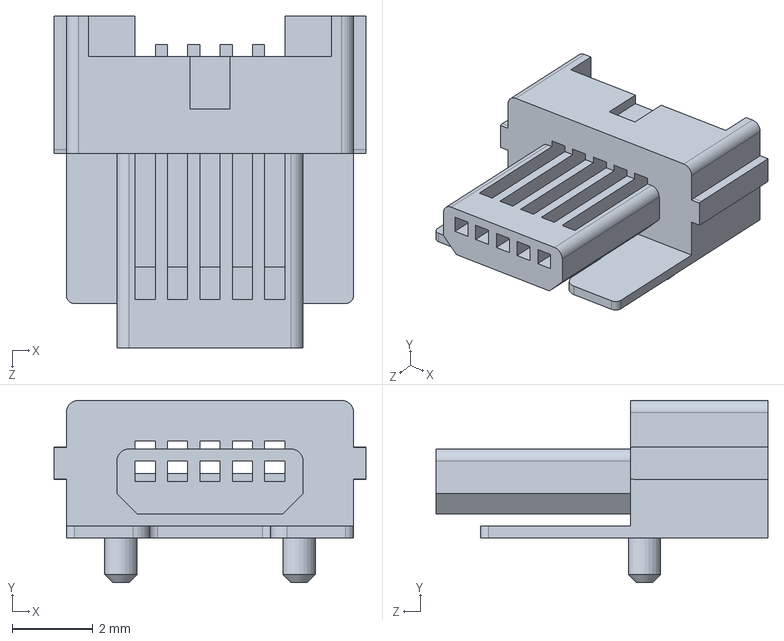
[picture p96: CAD file, 2018-01-09]
31352_Flyback/arduino-nano--1.snapshot.4/arduino nano290313/MINIUSBCORE.SLDPRT
7.70 x 4.50 x 8.20 mm
