ChristianLumby/Power2LabPowerSupply/31352_Flyback/3D/LCD/LCD/16pin_header__.sldprt

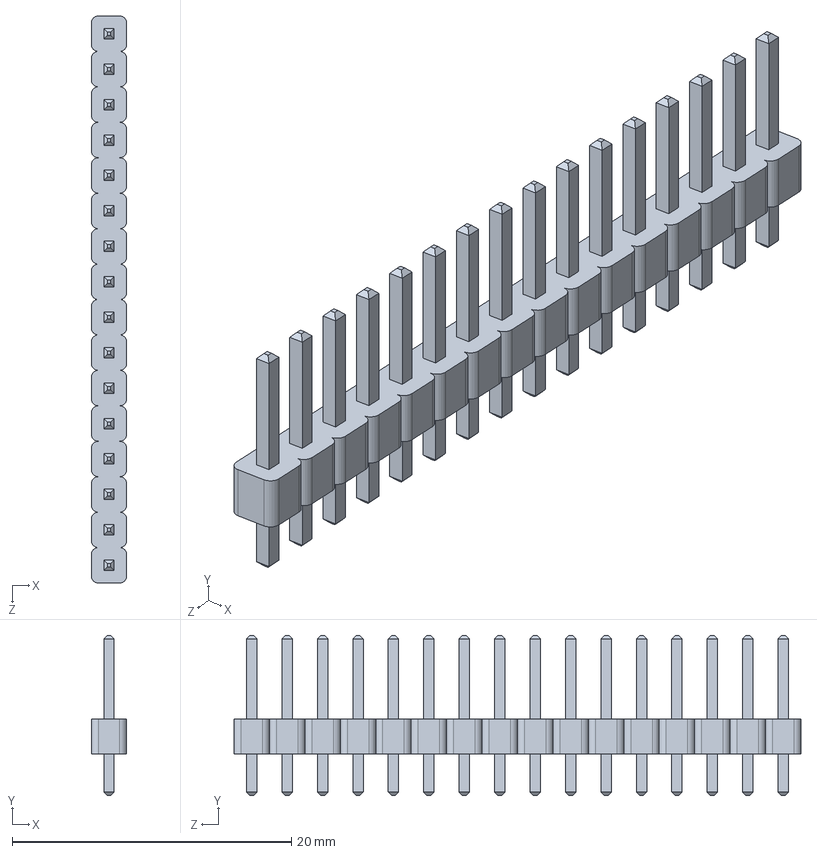
[picture p97: CAD file, 2018-01-25]
31352_Flyback/3D/LCD/LCD/16pin_header__.sldprt
2.54 x 11.5 x 40.6 mm
