ChristianLumby/Power2LabPowerSupply/31352_Flyback/arduino-nano--1.snapshot.4/arduino nano290313/nano-board.SLDPRT

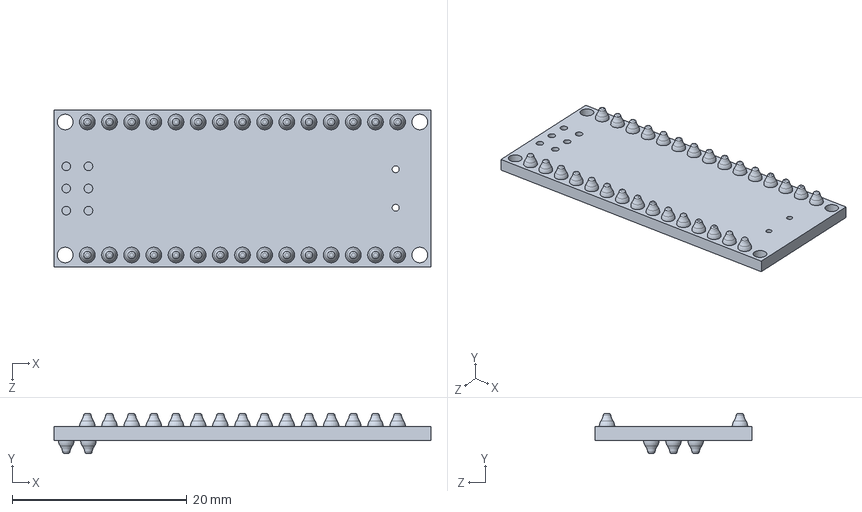
[picture p98: CAD file, 2018-01-09]
31352_Flyback/arduino-nano--1.snapshot.4/arduino nano290313/nano-board.SLDPRT
43.2 x 4.60 x 18.0 mm
