ChristianLumby/Power2LabPowerSupply/31352_Flyback/3D/LCD/LCD/pcbboard.SLDPRT

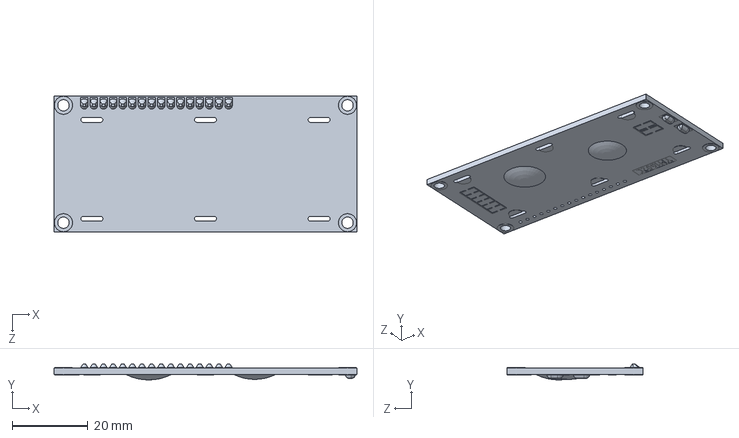
[picture p99: CAD file, 2018-01-25]
31352_Flyback/3D/LCD/LCD/pcbboard.SLDPRT
80.0 x 4.19 x 36.0 mm
