ChristianLumby/Power2LabPowerSupply/31352_Flyback/arduino-nano--1.snapshot.4/arduino nano290313/reset core.SLDPRT

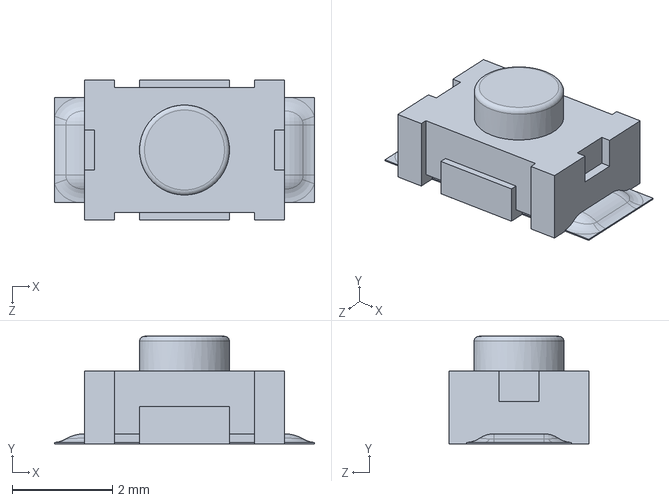
[picture p100: CAD file, 2018-01-09]
31352_Flyback/arduino-nano--1.snapshot.4/arduino nano290313/reset core.SLDPRT
5.20 x 2.15 x 2.80 mm
