ChristianLumby/Power2LabPowerSupply/31352_Flyback/arduino-nano--1.snapshot.4/arduino nano290313/cap106C.SLDPRT

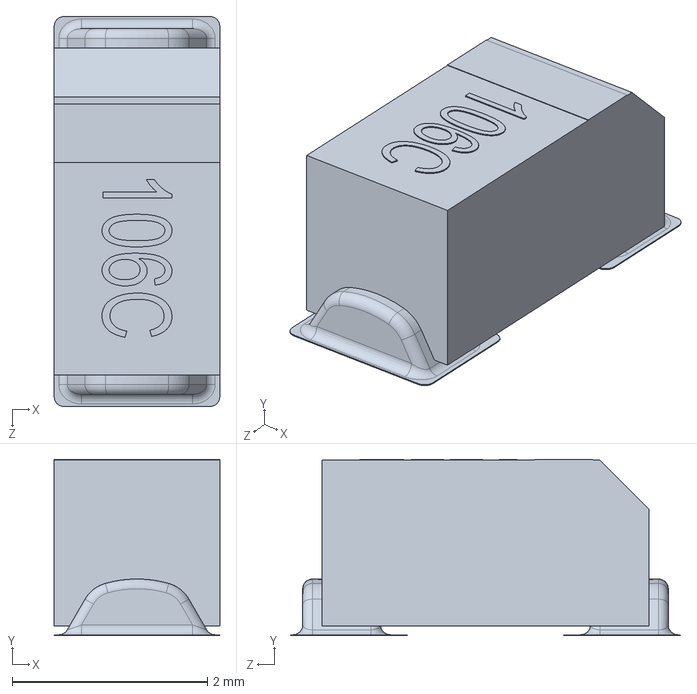
[picture p101: CAD file, 2018-01-09]
31352_Flyback/arduino-nano--1.snapshot.4/arduino nano290313/cap106C.SLDPRT
1.70 x 1.81 x 4.00 mm
