ChristianLumby/Power2LabPowerSupply/31352_Flyback/arduino-nano--1.snapshot.4/arduino nano290313/reset shell.SLDPRT

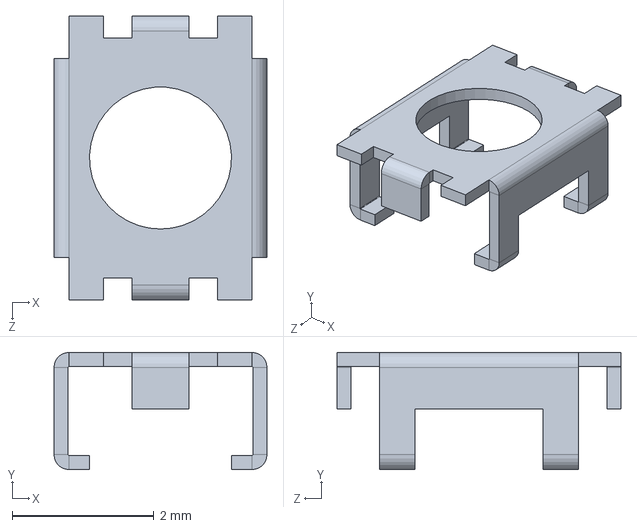
[picture p102: CAD file, 2018-01-09]
31352_Flyback/arduino-nano--1.snapshot.4/arduino nano290313/reset shell.SLDPRT
3.00 x 1.65 x 4.00 mm
