ChristianLumby/Power2LabPowerSupply/31352_Flyback/arduino-nano--1.snapshot.4/arduino nano290313/led.SLDPRT

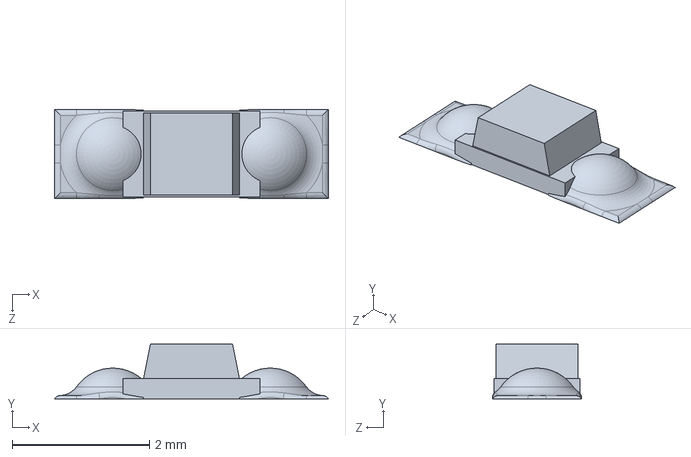
[picture p103: CAD file, 2018-01-09]
31352_Flyback/arduino-nano--1.snapshot.4/arduino nano290313/led.SLDPRT
4.00 x 0.8 x 1.30 mm
