ChristianLumby/Power2LabPowerSupply/31352_Flyback/arduino-nano--1.snapshot.4/arduino nano290313/nano - reg.SLDPRT

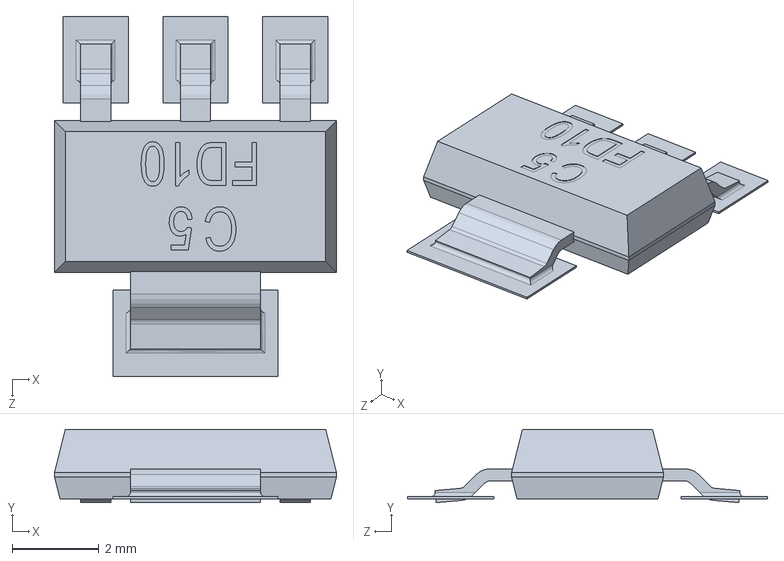
[picture p104: CAD file, 2018-01-09]
31352_Flyback/arduino-nano--1.snapshot.4/arduino nano290313/nano - reg.SLDPRT
6.50 x 1.69 x 8.30 mm
