ChristianLumby/Power2LabPowerSupply/31352_Flyback/arduino-nano--1.snapshot.4/arduino nano290313/NANO DIODE.SLDPRT

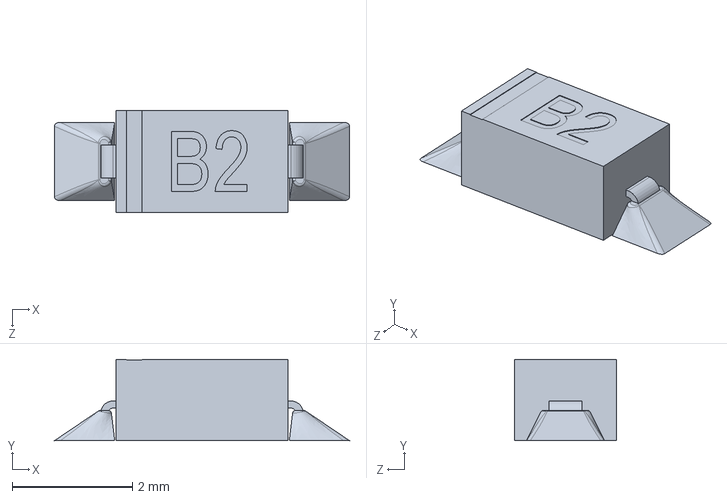
[picture p105: CAD file, 2018-01-09]
31352_Flyback/arduino-nano--1.snapshot.4/arduino nano290313/NANO DIODE.SLDPRT
4.90 x 1.35 x 1.70 mm
