ChristianLumby/Power2LabPowerSupply/31352_Flyback/arduino-nano--1.snapshot.4/arduino nano290313/2pin_header__02.sldprt

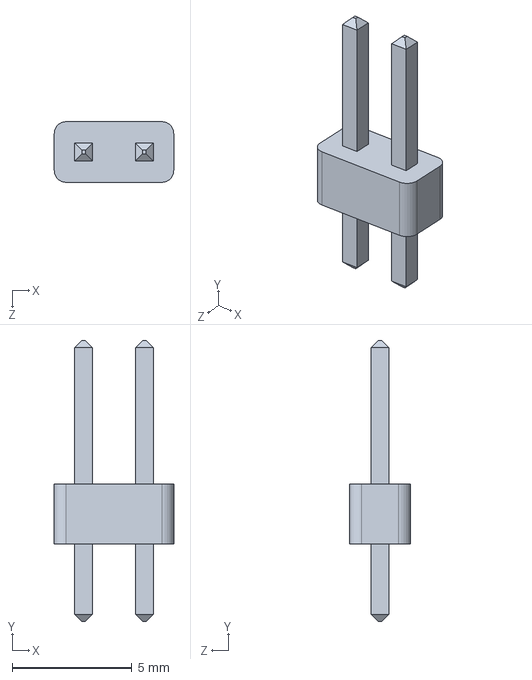
[picture p106: CAD file, 2018-01-09]
31352_Flyback/arduino-nano--1.snapshot.4/arduino nano290313/2pin_header__02.sldprt
5.00 x 11.8 x 2.54 mm
