ChristianLumby/Power2LabPowerSupply/31352_Flyback/arduino-nano--1.snapshot.4/arduino nano290313/ftdi FT232rl.SLDPRT

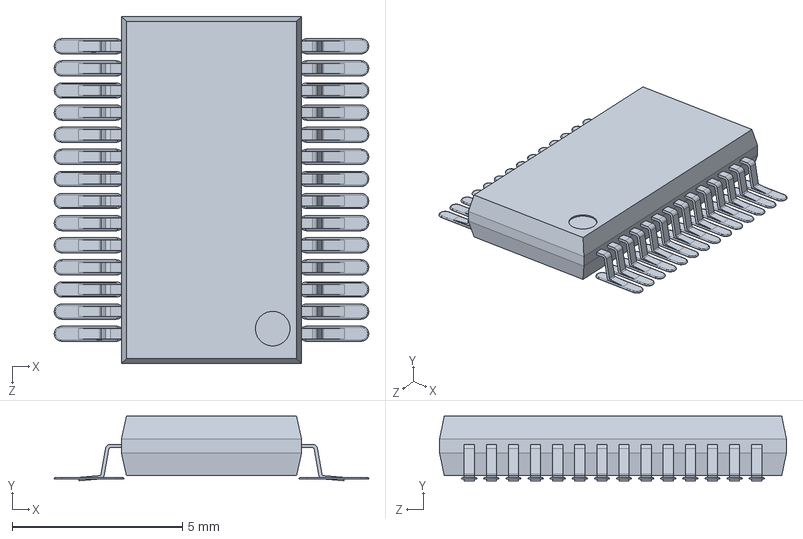
[picture p107: CAD file, 2018-01-09]
31352_Flyback/arduino-nano--1.snapshot.4/arduino nano290313/ftdi FT232rl.SLDPRT
9.25 x 1.90 x 10.2 mm
