ChristianLumby/Power2LabPowerSupply/31352_Flyback/arduino-nano--1.snapshot.4/arduino nano290313/MINI USB SOLDER.SLDPRT

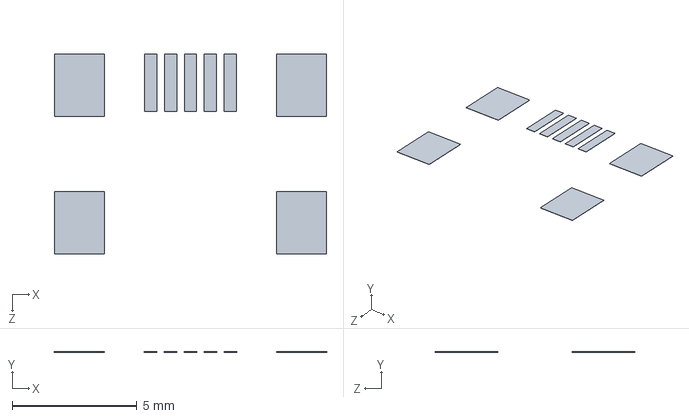
[picture p108: CAD file, 2018-01-09]
31352_Flyback/arduino-nano--1.snapshot.4/arduino nano290313/MINI USB SOLDER.SLDPRT
10.9 x 0.01 x 8.00 mm
