ChristianLumby/Power2LabPowerSupply/31352_Flyback/arduino-nano--1.snapshot.4/arduino nano290313/15pin_header__.sldprt

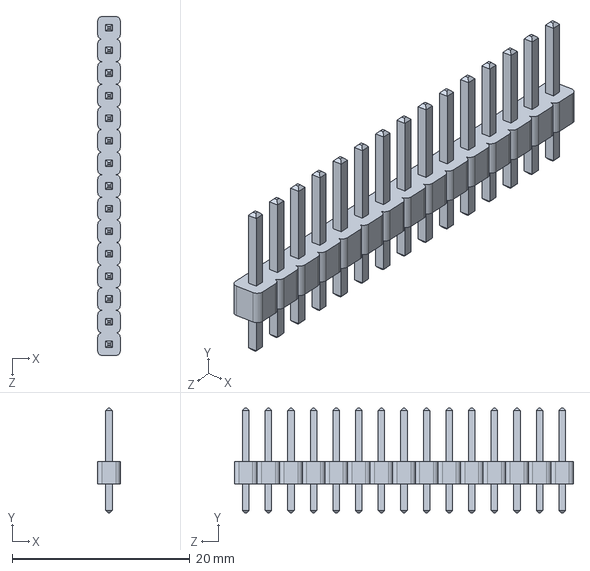
[picture p109: CAD file, 2018-01-09]
31352_Flyback/arduino-nano--1.snapshot.4/arduino nano290313/15pin_header__.sldprt
2.54 x 11.8 x 38.1 mm
