ChristianLumby/Power2LabPowerSupply/31352_Flyback/arduino-nano--1.snapshot.4/arduino nano290313/MINIUSBSHELL.SLDPRT

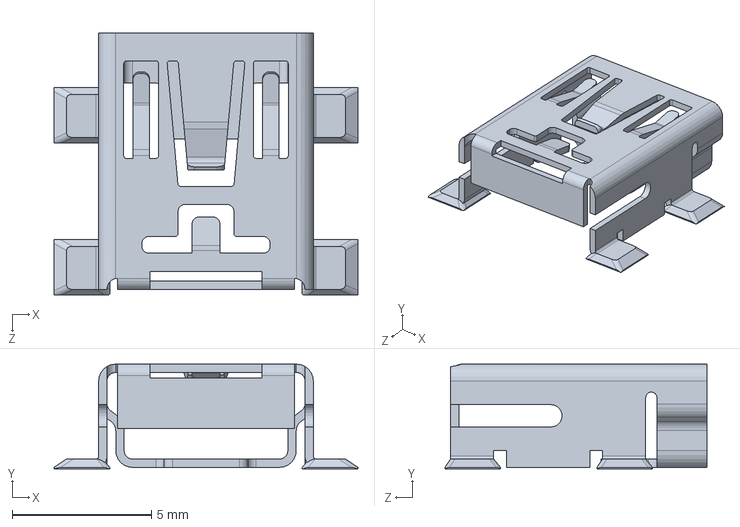
[picture p110: CAD file, 2018-01-09]
31352_Flyback/arduino-nano--1.snapshot.4/arduino nano290313/MINIUSBSHELL.SLDPRT
10.9 x 3.75 x 9.40 mm
