ChristianLumby/Power2LabPowerSupply/31352_Flyback/arduino-nano--1.snapshot.4/arduino nano290313/16mhz crystal - measured.SLDPRT

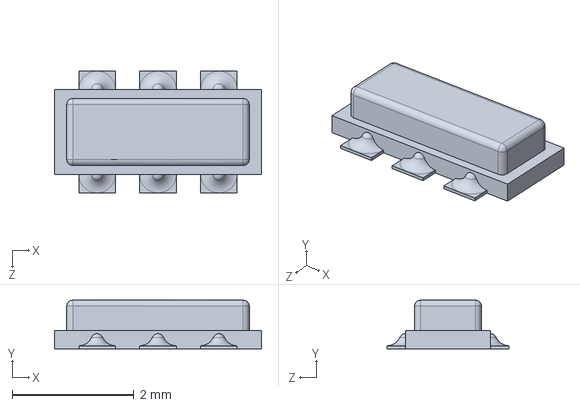
[picture p111: CAD file, 2018-01-09]
31352_Flyback/arduino-nano--1.snapshot.4/arduino nano290313/16mhz crystal - measured.SLDPRT
3.40 x 0.8 x 2.00 mm
