ChristianLumby/Power2LabPowerSupply/(list of files, cad)

Other CAD files:
31352_Flyback/3D/LCD.SLDPRT
31352_Flyback/3D/Pot_500k_coarse.SLDPRT
31352_Flyback/3D/Banana_jack_red.STEP
31352_Flyback/3D/3310y-001.stp
31352_Flyback/arduino-nano--1.snapshot.4/arduino nano290313/102 RESISTOR PACK.SLDPRT
31352_Flyback/3D/Banana_jack_black.SLDPRT
31352_Flyback/3D/Banana_jack_red.SLDPRT
