ChristianLumby/Power2LabPowerSupply/Measurements/Load step/fig1.png

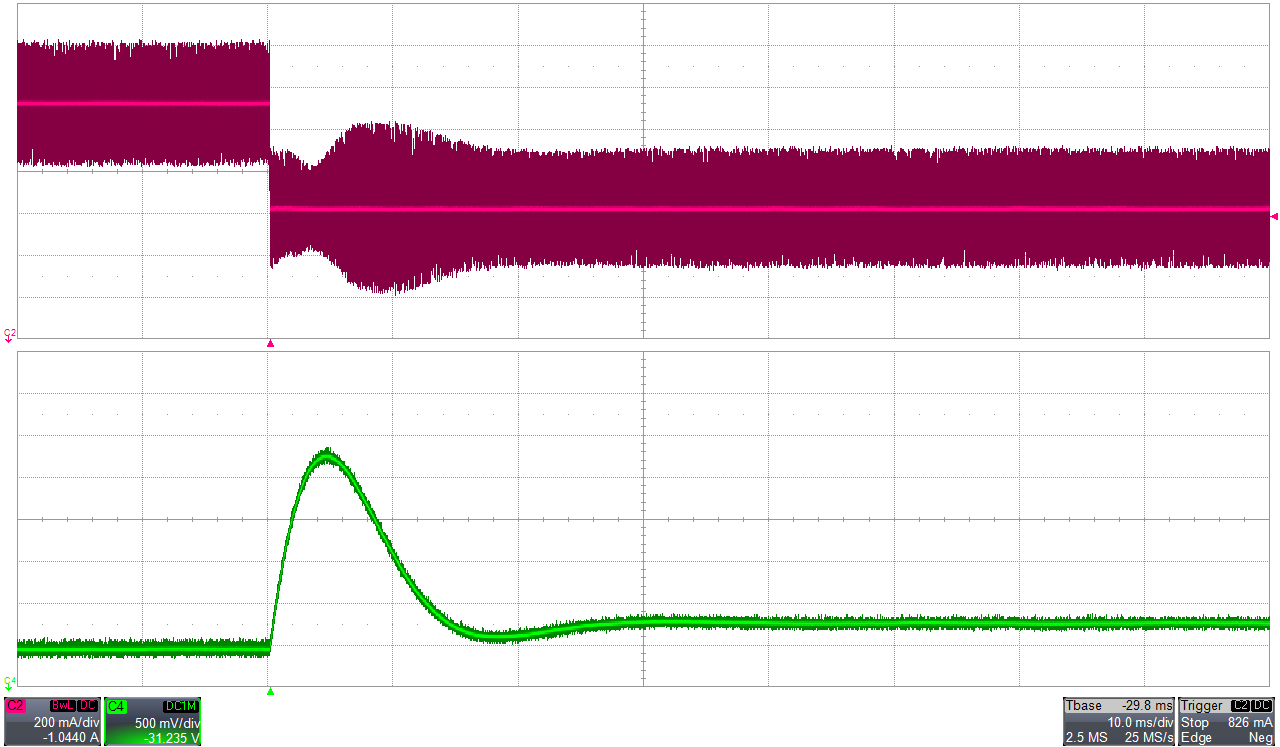
Measurements/Load step/fig1.png
