ChristianLumby/Power2LabPowerSupply/Measurements/Load step/fig.png

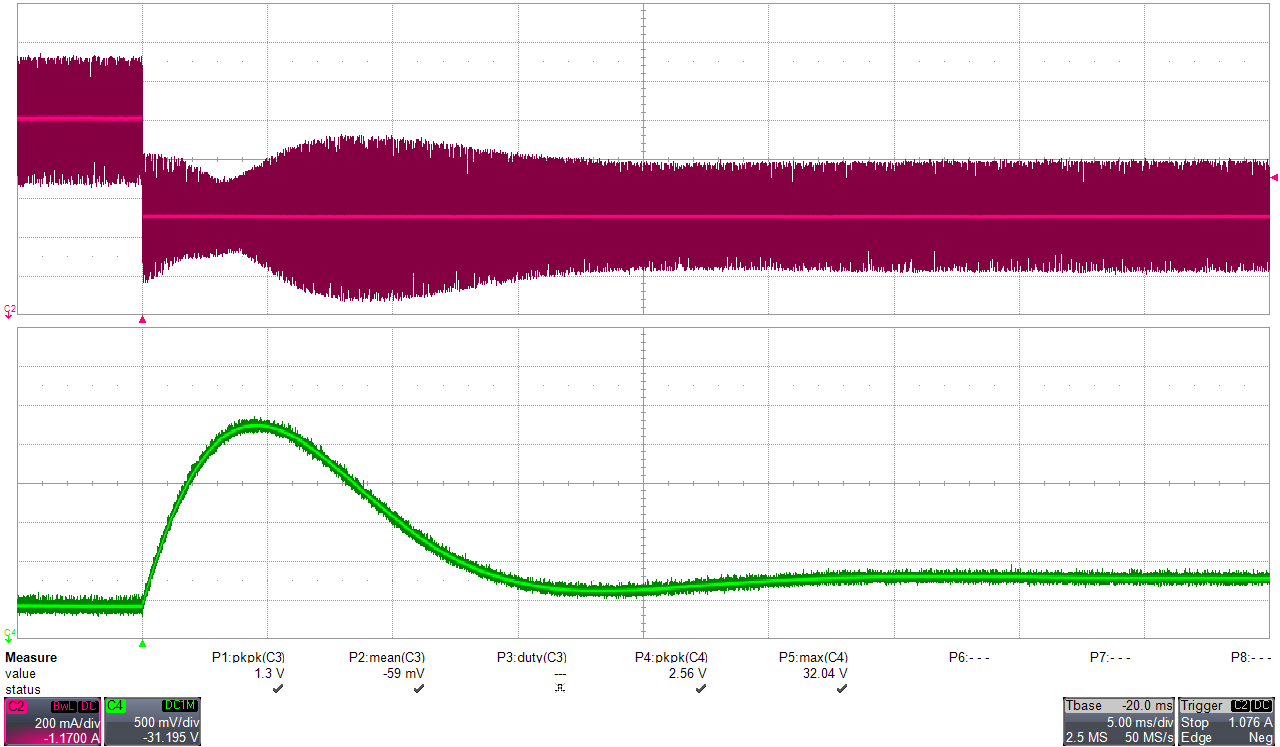
Measurements/Load step/fig.png
