ChristianLumby/Power2LabPowerSupply/31352_Flyback/IDFReport_PCB2_test.html

Altium customize

# IDF File Translation Report

Date: | | 08/01/2018
Time: | | 11.56.18
Elapsed Time: | | 00:00:00
PCB Filename | : | C:\Users\Sjefen\OneDrive - Danmarks Tekniske Universitet\Skole\Effektelektronik 2\Power2LabPowerSupply\31352_Flyback\PCB2.PcbDoc
IDF Board Filename | : | C:\Users\Sjefen\OneDrive - Danmarks Tekniske Universitet\Skole\Effektelektronik 2\Power2LabPowerSupply\31352_Flyback\PCB2_test.brd
IDF Library Filename | : | C:\Users\Sjefen\OneDrive - Danmarks Tekniske Universitet\Skole\Effektelektronik 2\Power2LabPowerSupply\31352_Flyback\PCB2_test.pro

Errors

Back to top

Warnings

Back to top

Save Warnings

Back to top

Save Errors

Back to top

Export Warnings

Library Component CAPR5-4X5 is missing Comment, resulting in missing Part Number. Suggest using 'Replace Blank Component Fields With' Export IDF option.

Back to top

Export Errors

Back to top
