ChristianLumby/Power2LabPowerSupply/Measurements/Effeciency/Effeciency Closed Loop 16-01-2018.xlsx

Sheet: Ark1
Input |  |  |  | Output |  |  | Effeciency
Voltage [V] | Current [A] | Logic [W] | Power [W] | Voltage [V] | Current [A] | Power [W] | Effeciency [%]
30 | 0.066 | 0.253 | 2.233 | 15 | 0.1 | 1.5 | 67.17
30 | 0.131 | 0.253 | 4.183 | 15 | 0.2 | 3 | 71.72
30 | 0.196 | 0.253 | 6.133 | 15 | 0.3 | 4.5 | 73.37
30 | 0.223 | 0.253 | 6.943 | 15 | 0.4 | 6 | 86.42
30 | 0.25 | 0.253 | 7.753 | 15 | 0.45 | 6.75 | 87.06
30 | 0.278 | 0.253 | 8.593 | 15 | 0.5 | 7.5 | 87.28
30 | 0.306 | 0.253 | 9.433 | 15 | 0.55 | 8.25 | 87.46
30 | 0.334 | 0.253 | 10.273 | 15 | 0.6 | 9 | 87.61
30 | 0.39 | 0.253 | 11.953 | 15 | 0.7 | 10.5 | 87.84
30 | 0.447 | 0.253 | 13.663 | 15 | 0.8 | 12 | 87.83
30 | 0.504 | 0.253 | 15.373 | 15 | 0.9 | 13.5 | 87.82
30 | 0.561 | 0.253 | 17.083 | 15 | 1 | 15 | 87.81
30 | 0.618 | 0.253 | 18.793 | 15 | 1.1 | 16.5 | 87.80
30 | 0.676 | 0.253 | 20.533 | 15 | 1.2 | 18 | 87.66
30 | 0.735 | 0.253 | 22.303 | 15 | 1.3 | 19.5 | 87.43
30 | 0.794 | 0.253 | 24.073 | 15 | 1.4 | 21 | 87.23
30 | 0.854 | 0.253 | 25.873 | 15 | 1.5 | 22.5 | 86.96
Input |  |  |  | Output |  |  | Effeciency
Voltage [V] | Current [A] | Logic [W] | Power [W] | Voltage [V] | Current [A] | Power [W] | %
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
