ChristianLumby/Power2LabPowerSupply/Measurements/Effeciency/matlab/effeciency_closed_loop_20-30.csv

Power [W] | Effeciency [%]
3 | 69.44
6 | 79.58
9 | 83.33
12 | 84.99
15 | 85.62
18 | 85.96
21 | 86.00
24 | 85.71
27 | 85.23
30 | 84.36
