ChristianLumby/Power2LabPowerSupply/Measurements/Effeciency/matlab/effeciency_closed_loop_30-15.csv

Input |  |  | Output |  |  | Effeciency
Voltage [V] | Current [A] | Power [W] | Voltage [V] | Current [A] | Power [W] | Effeciency [%]
30 | 0.0775 | 2.325 | 15 | 0.1 | 1.5 | 64.52
30 | 0.134 | 4.02 | 15 | 0.2 | 3 | 74.63
30 | 0.189 | 5.67 | 15 | 0.3 | 4.5 | 79.37
30 | 0.243 | 7.29 | 15 | 0.4 | 6 | 82.30
30 | 0.298 | 8.94 | 15 | 0.5 | 7.5 | 83.89
30 | 0.353 | 10.59 | 15 | 0.6 | 9 | 84.99
30 | 0.409 | 12.27 | 15 | 0.7 | 10.5 | 85.57
30 | 0.465 | 13.95 | 15 | 0.8 | 12 | 86.02
30 | 0.521 | 15.63 | 15 | 0.9 | 13.5 | 86.37
30 | 0.579 | 17.37 | 15 | 1 | 15 | 86.36
30 | 0.636 | 19.08 | 15 | 1.1 | 16.5 | 86.48
30 | 0.694 | 20.82 | 15 | 1.2 | 18 | 86.46
30 | 0.75 | 22.5 | 15 | 1.3 | 19.5 | 86.67
30 | 0.809 | 24.27 | 15 | 1.4 | 21 | 86.53
30 | 0.868 | 26.04 | 15 | 1.5 | 22.5 | 86.41
Input |  |  | Output |  |  | Effeciency
Voltage [V] | Current [A] | Power [W] | Voltage [V] | Current [A] | Power [W] | Effeciency [%]
20 | 0.216 | 4.32 | 30 | 0.1 | 3 | 69.44
20 | 0.377 | 7.54 | 30 | 0.2 | 6 | 79.58
20 | 0.54 | 10.8 | 30 | 0.3 | 9 | 83.33
20 | 0.706 | 14.12 | 30 | 0.4 | 12 | 84.99
20 | 0.876 | 17.52 | 30 | 0.5 | 15 | 85.62
20 | 1.047 | 20.94 | 30 | 0.6 | 18 | 85.96
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
