ChristianLumby/Power2LabPowerSupply/Measurements/Inrush/C2inrush-wo00000.csv

LECROYWR640Zi | 0 | Waveform
Segments | 1 | SegmentSize | 12502
Segment | TrigTime | TimeSinceSegment1
#1 | 17-Jan-2018 19:34:01 | 0
Time | Ampl
-0.0001250329 | 0.43762
-0.0001249929 | 0.43762
-0.0001249529 | 1.10181
-0.0001249129 | -0.226567
-0.0001248729 | 0.43762
-0.0001248329 | 0.105526
-0.0001247929 | 0.43762
-0.0001247529 | 0.43762
-0.0001247129 | 0.105526
-0.0001246729 | 0.769713
-0.0001246329 | 0.769713
-0.0001245929 | 0.43762
-0.0001245529 | 0.769713
-0.0001245129 | 0.769713
-0.0001244729 | 1.10181
-0.0001244329 | 0.43762
-0.0001243929 | 0.105526
-0.0001243529 | 0.43762
-0.0001243129 | 0.769713
-0.0001242729 | 0.43762
-0.0001242329 | 0.43762
-0.0001241929 | 0.43762
-0.0001241529 | 0.769713
-0.0001241129 | 0.43762
-0.0001240729 | 0.769713
-0.0001240329 | 0.43762
-0.0001239929 | 0.769713
-0.0001239529 | 0.105526
-0.0001239129 | 0.43762
-0.0001238729 | 0.43762
-0.0001238329 | 1.10181
-0.0001237929 | -0.226567
-0.0001237529 | 0.43762
-0.0001237129 | 0.43762
-0.0001236729 | 0.769713
-0.0001236329 | 0.43762
-0.0001235929 | 0.105526
-0.0001235529 | 0.43762
-0.0001235129 | 1.10181
-0.0001234729 | 0.105526
-0.0001234329 | 0.105526
-0.0001233929 | 0.769713
-0.0001233529 | 0.769713
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
