ChristianLumby/Power2LabPowerSupply/Measurements/Effeciency/Effeciency Open Loop 13-01-2018.xlsx

Input |  |  |  | Output |  |  | Effeciency
Voltage [V] | Current [A] | Logic [W] | Power [W] | Voltage [V] | Current [A] | Power [W]
20 | 0.022 | 0.3 | 0.74 | 10.3 | 0.031 | 0.3193 | 43.14864865
20 | 0.051 | 0.3 | 1.32 | 10.7 | 0.074 | 0.7918 | 59.98484848
20 | 0.04 | 0.3 | 1.1 | 10.6 | 0.057 | 0.6042 | 54.92727273
20 | 0.023 | 0.3 | 0.76 | 10.3 | 0.032 | 0.3296 | 43.36842105
30 | 0.011 | 0.3 | 0.63 | 5.4 | 0.034 | 0.1836 | 29.14285714
30 | 0.015 | 0.3 | 0.75 | 5.7 | 0.063 | 0.3591 | 47.88
30 | 0.02 | 0.3 | 0.9 | 5.8 | 0.079 | 0.4582 | 50.91111111
30 | 0.083 | 0.3 | 2.79 | 6.5 | 0.316 | 2.054 | 73.62007168
30 | 0.09 | 0.3 | 3 | 5.05 | 0.427 | 2.15635 | 71.87833333
30 | 0.098 | 0.3 | 3.24 | 5.05 | 0.466 | 2.3533 | 72.63271605
30 | 0.108 | 0.3 | 3.54 | 5.06 | 0.512 | 2.59072 | 73.18418079
30 | 0.13 | 0.3 | 4.2 | 5.07 | 0.613 | 3.10791 | 73.99785714
30 | 0.162 | 0.3 | 5.16 | 5.08 | 0.753 | 3.82524 | 74.13255814
30 | 0.185 | 0.3 | 5.85 | 5.09 | 0.858 | 4.36722 | 74.65333333
30 | 0.199 | 0.3 | 6.27 | 5.1 | 0.916 | 4.6716 | 74.50717703
30 | 0.239 | 0.3 | 7.47 | 5.12 | 1.09 | 5.5808 | 74.70950469
30 | 0.304 | 0.3 | 9.42 | 5.14 | 1.35 | 6.939 | 73.66242038
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
