ChristianLumby/Power2LabPowerSupply/Measurements/circuit nodes/30vin_5Vout_540mIout.png

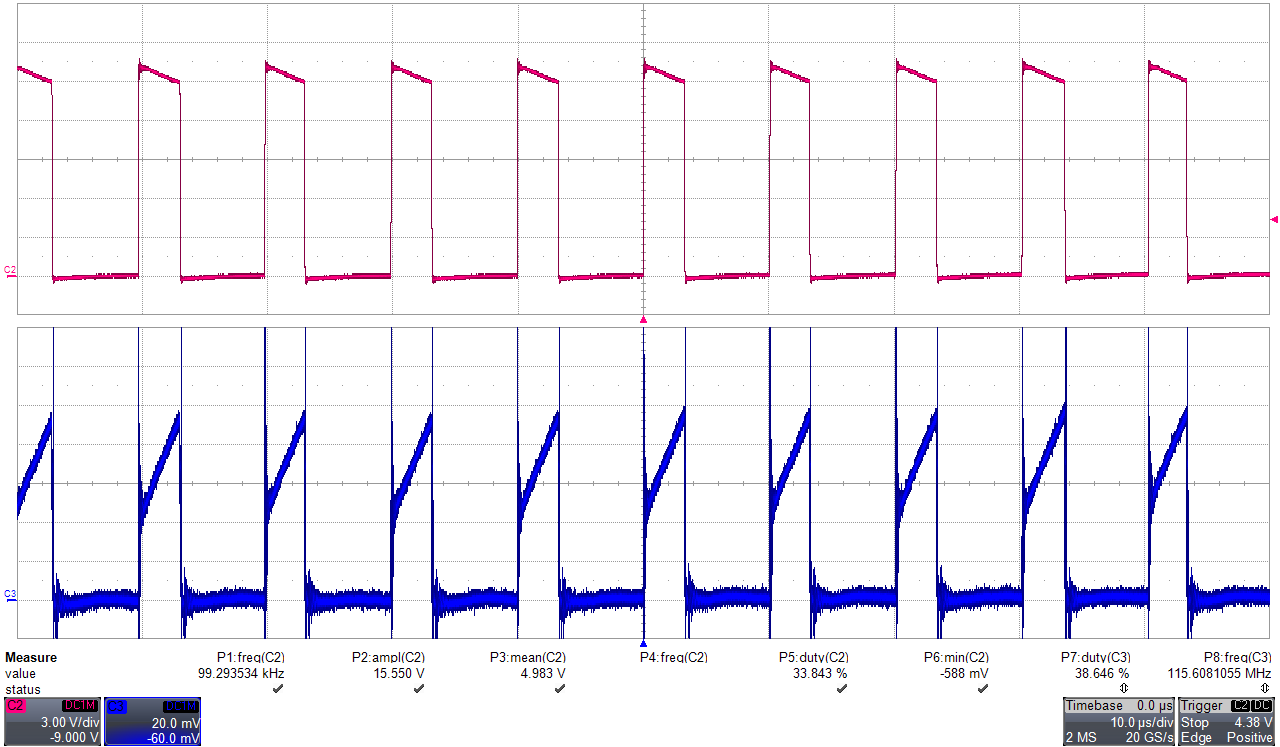
Measurements/circuit nodes/30vin_5Vout_540mIout.png
