ChristianLumby/Power2LabPowerSupply/Measurements/Inrush/fig2.png

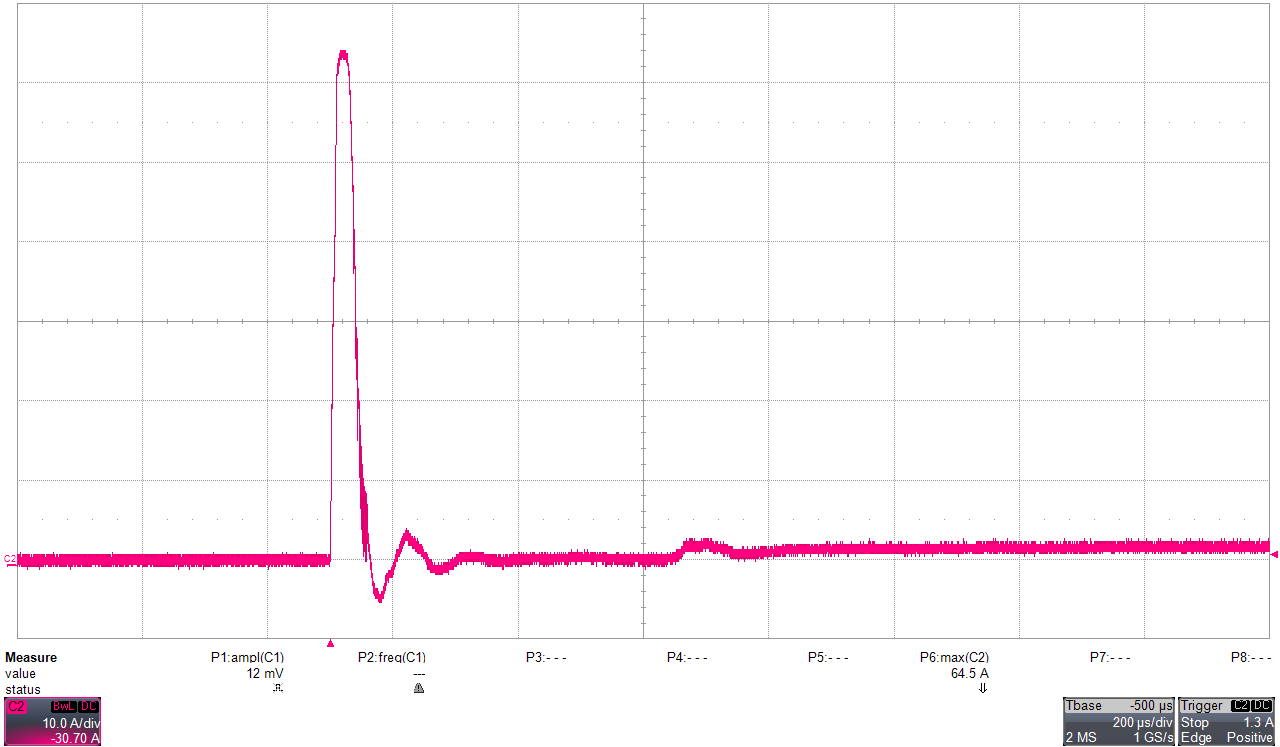
Measurements/Inrush/fig2.png
