ChristianLumby/Power2LabPowerSupply/Measurements/Inrush/fig3.png

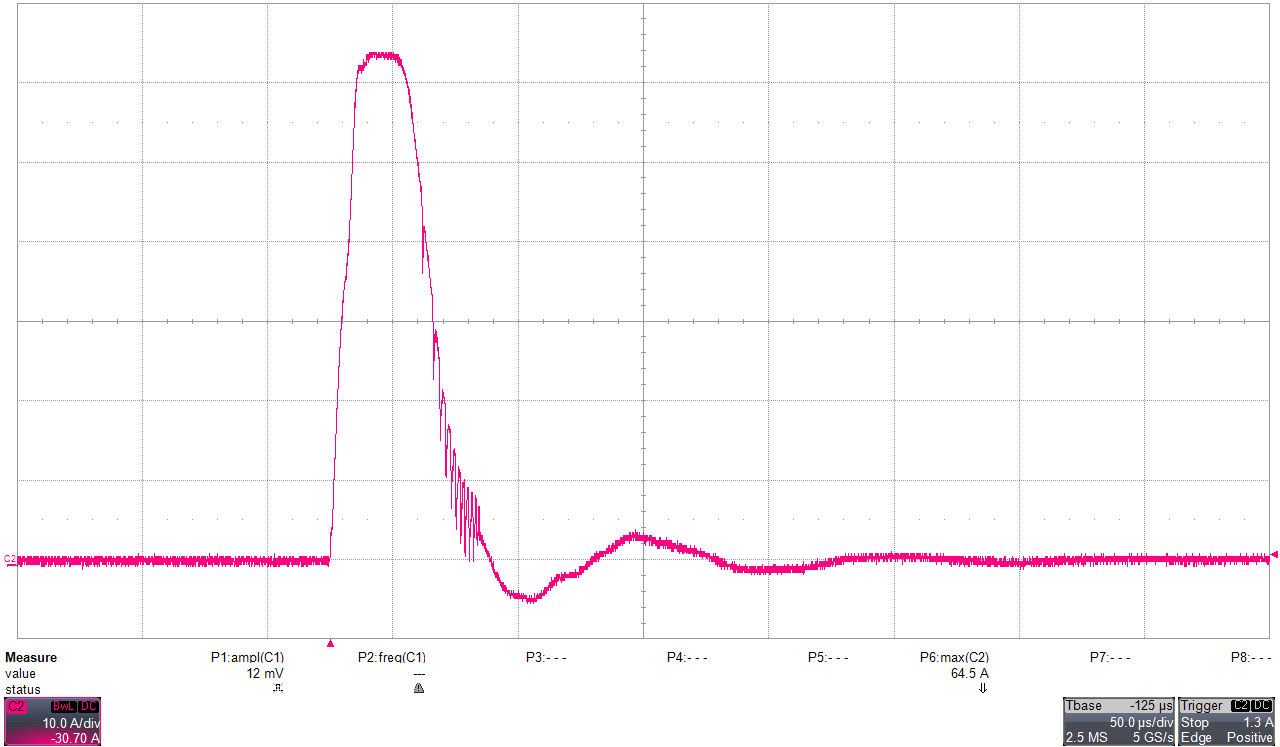
Measurements/Inrush/fig3.png
