ChristianLumby/Power2LabPowerSupply/Measurements/Transformer Inductances/Inductance_measurements_first_core_shitty_quality.PNG

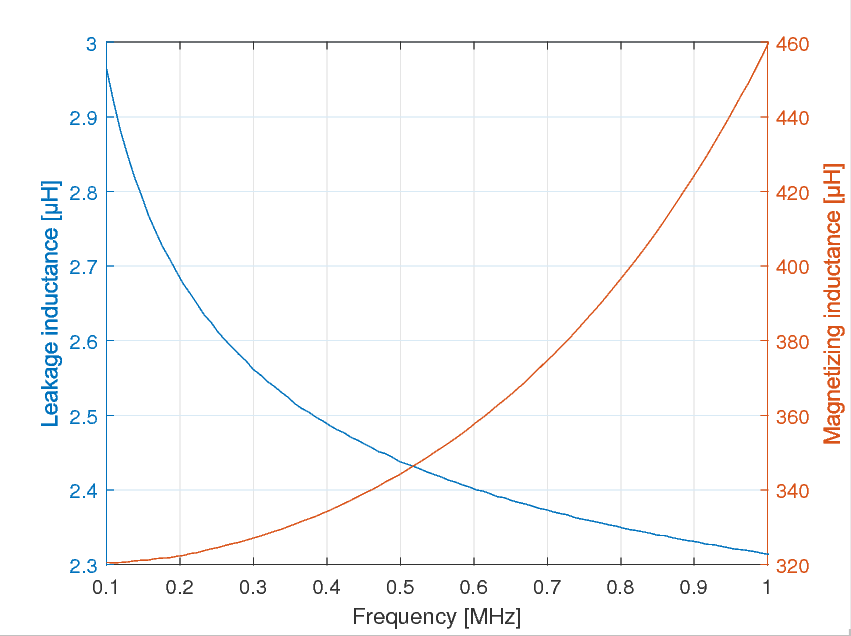
Measurements/Transformer Inductances/Inductance_measurements_first_core_shitty_quality.PNG
