ChristianLumby/Power2LabPowerSupply/Measurements/circuit nodes/problem_1.png

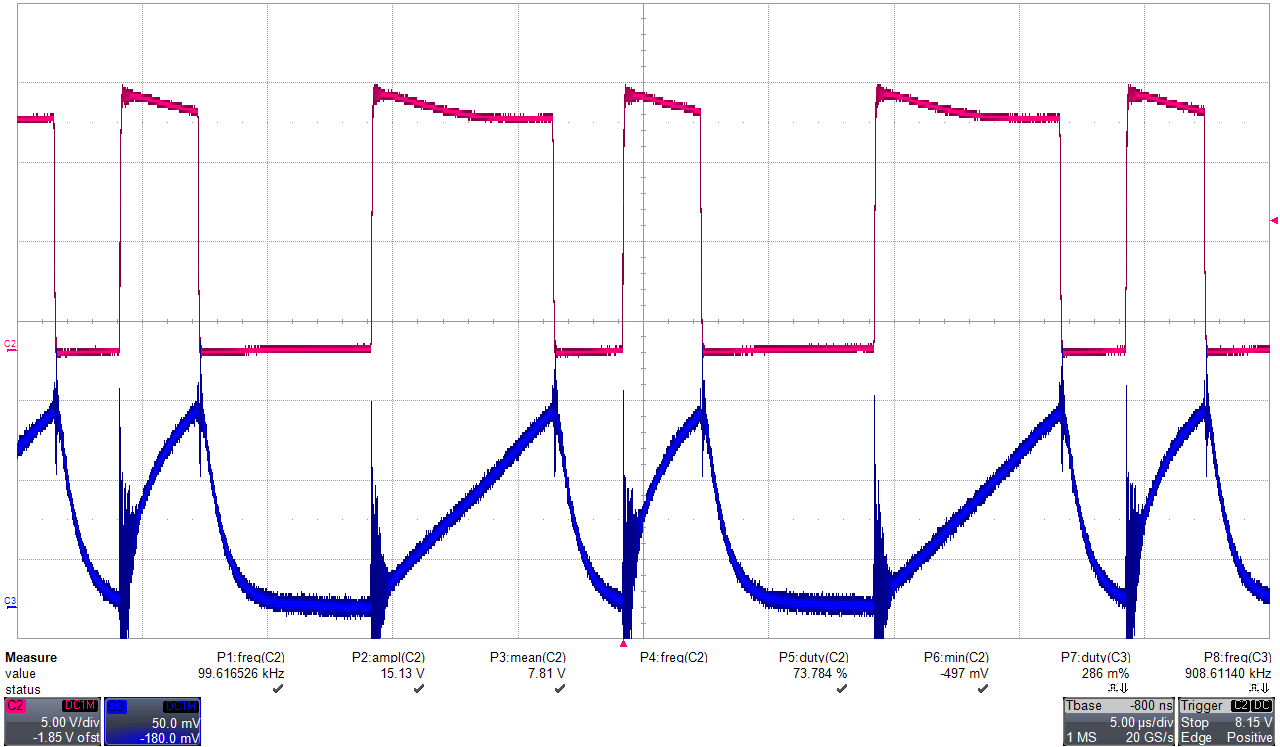
Measurements/circuit nodes/problem_1.png
