ChristianLumby/Power2LabPowerSupply/Measurements/circuit nodes/problem_2.png

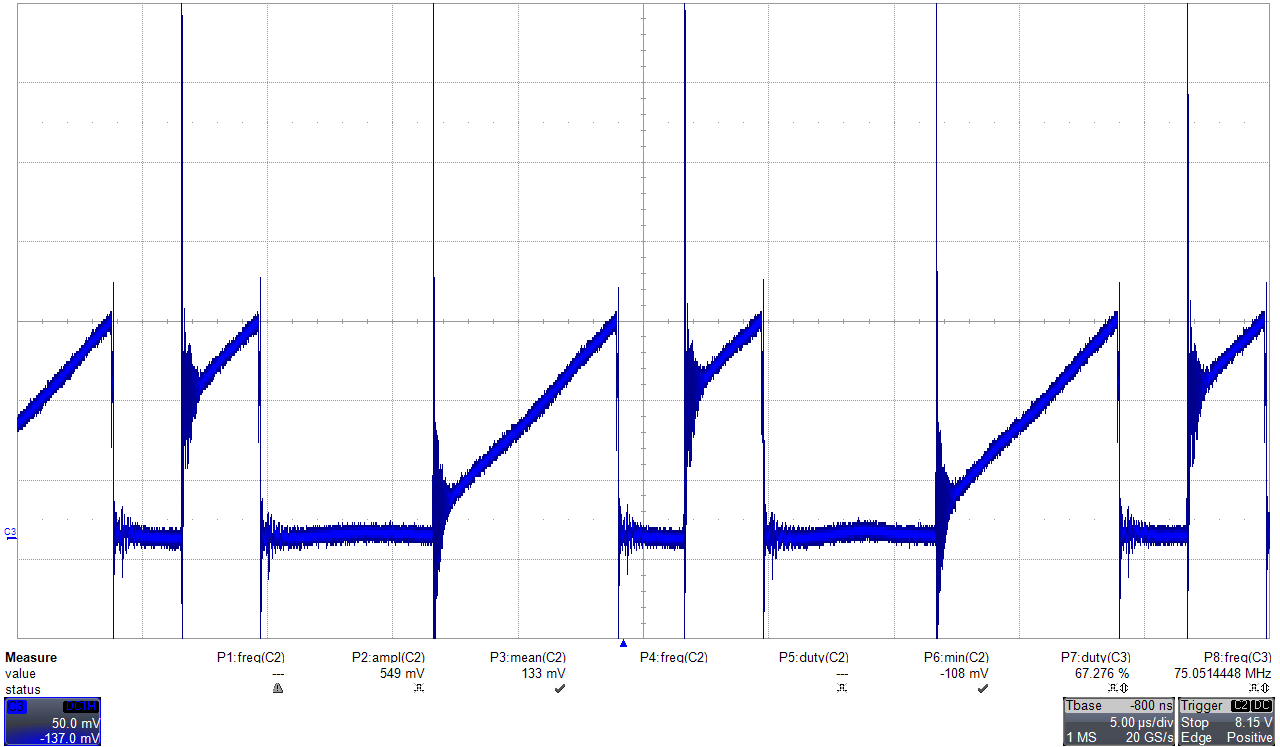
Measurements/circuit nodes/problem_2.png
