ChristianLumby/Power2LabPowerSupply/31353_Power_Electronics_2_Poster_GP4.pdf

✐

✐

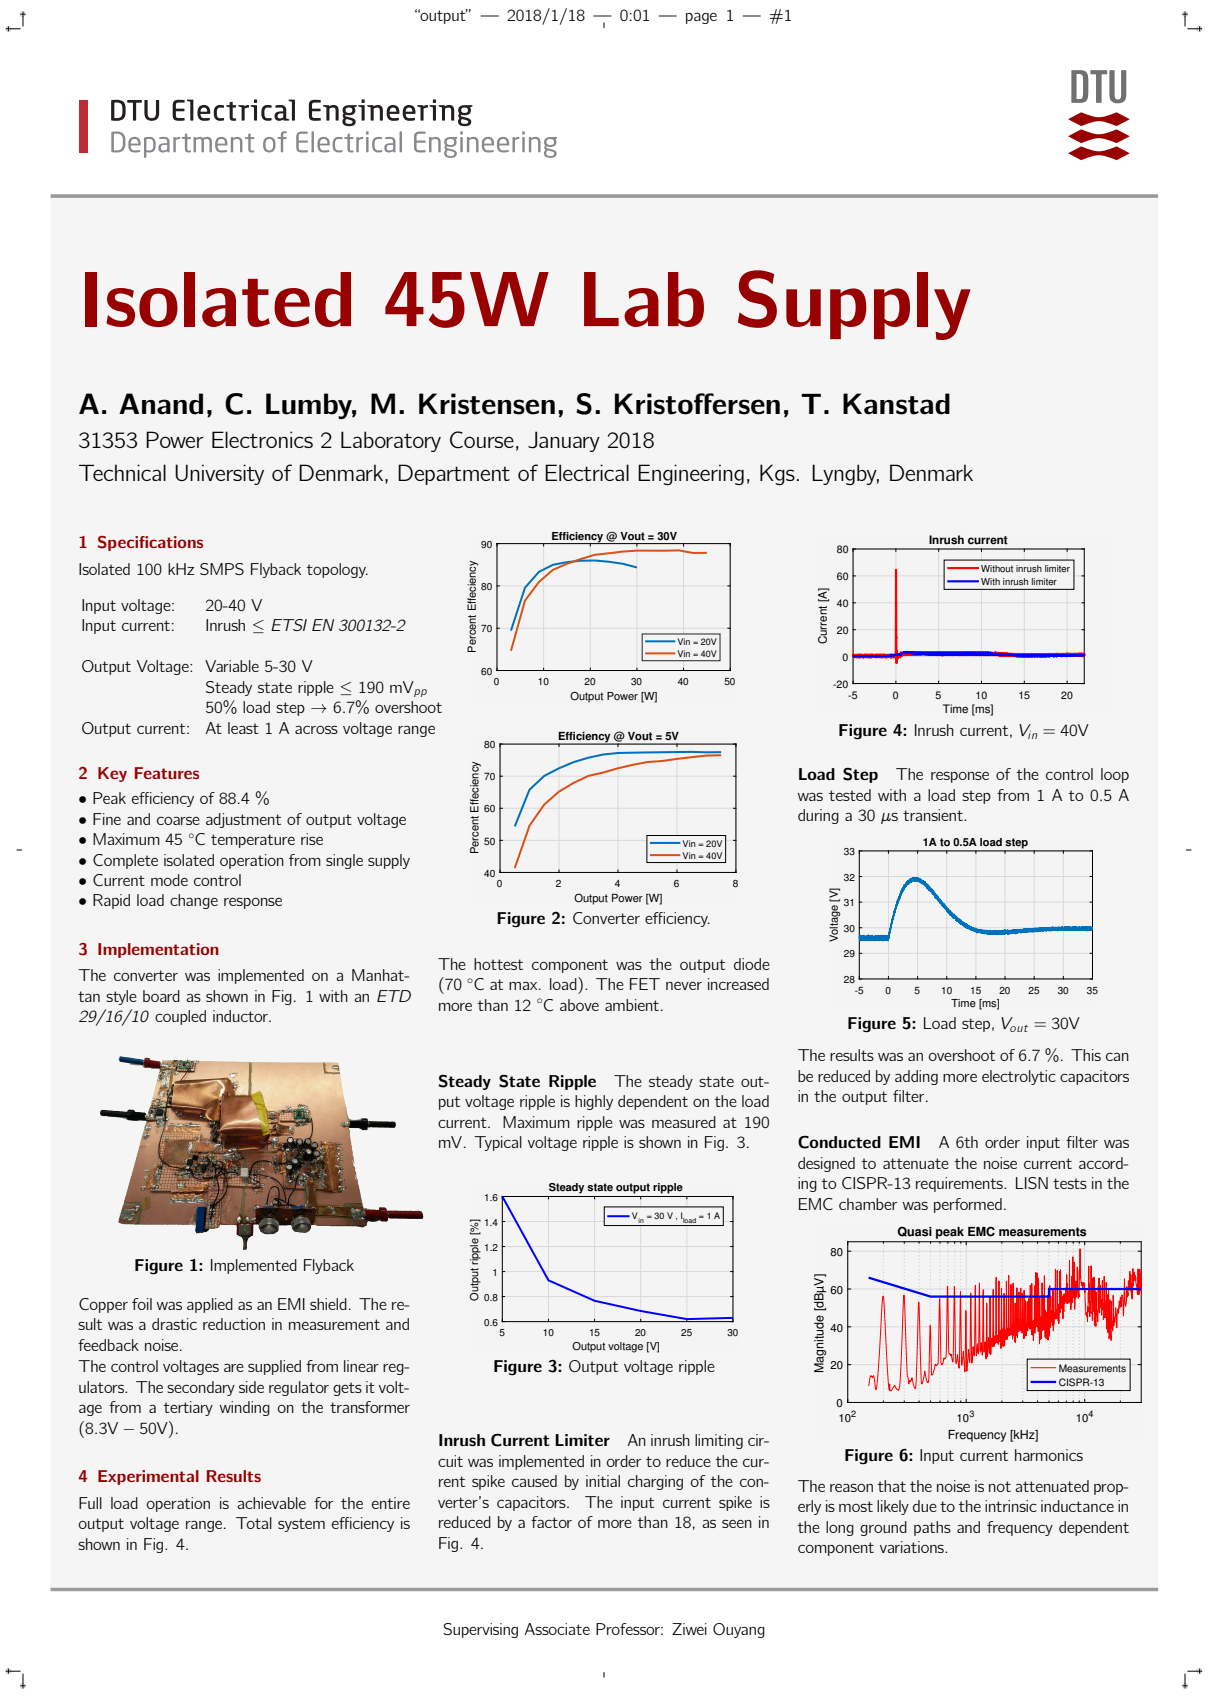
[picture p121: page 1]
“output” — 2018/1/18 — 0:01 — page 1 — #1; Input voltage:; Input current:; Inrush ≤ ETSI EN 300132-2; Output Power [W]; Percent Effeciency; Efficiency @ Vout = 30V; Vin = 20V Vin = 40V; Efficiency @ Vout = 5V; ◦C above ambient.; Output voltage [V]; Output ripple [%]; Vin = 30 V , Iload = 1 A; Time [ms]; Current [A]; Inrush current; Voltage [V]; Frequency [kHz]; Magnitude [dBµV]; Measurements CISPR-13

Isolated 45W Lab Supply

A. Anand, C. Lumby, M. Kristensen, S. Kristoffersen, T. Kanstad

31353 Power Electronics 2 Laboratory Course, January 2018
Technical University of Denmark, Department of Electrical Engineering, Kgs. Lyngby, Denmark

1 Specifications
Isolated 100 kHz SMPS Flyback topology.

Without inrush limiter
With inrush limiter

Output Voltage: Variable 5-30 V

Steady state ripple ≤ 190 mVpp
50% load step → 6.7% overshoot

Output current: At least 1 A across voltage range

Figure 4: Inrush current, Vin = 40V

2 Key Features
• Peak efficiency of 88.4 %
• Fine and coarse adjustment of output voltage
• Maximum 45 ◦C temperature rise
• Complete isolated operation from single supply
• Current mode control
• Rapid load change response

Load Step The response of the control loop
was tested with a load step from 1 A to 0.5 A
during a 30 µs transient.

1A to 0.5A load step

Figure 2: Converter efficiency.

3 Implementation
The converter was implemented on a Manhat-
tan style board as shown in Fig. 1 with an ETD
29/16/10 coupled inductor.

The hottest component was the output diode
(70 ◦C at max. load). The FET never increased
more than 12

Figure 5: Load step, Vout = 30V

The results was an overshoot of 6.7 %. This can
be reduced by adding more electrolytic capacitors
in the output filter.

Steady State Ripple The steady state out-
put voltage ripple is highly dependent on the load
current. Maximum ripple was measured at 190
mV. Typical voltage ripple is shown in Fig. 3.

Conducted EMI A 6th order input filter was
designed to attenuate the noise current accord-
ing to CISPR-13 requirements. LISN tests in the
EMC chamber was performed.

Steady state output ripple

Quasi peak EMC measurements

Figure 1: Implemented Flyback

Copper foil was applied as an EMI shield. The re-
sult was a drastic reduction in measurement and
feedback noise.
The control voltages are supplied from linear reg-
ulators. The secondary side regulator gets it volt-
age from a tertiary winding on the transformer

Figure 3: Output voltage ripple

Inrush Current Limiter An inrush limiting cir-
cuit was implemented in order to reduce the cur-
rent spike caused by initial charging of the con-
verter’s capacitors. The input current spike is
reduced by a factor of more than 18, as seen in
Fig. 4.

Figure 6: Input current harmonics

4 Experimental Results
Full load operation is achievable for the entire
output voltage range. Total system efficiency is
shown in Fig. 4.

The reason that the noise is not attenuated prop-
erly is most likely due to the intrinsic inductance in
the long ground paths and frequency dependent
component variations.

Supervising Associate Professor: Ziwei Ouyang
