ChristianLumby/Power2LabPowerSupply/31352_Flyback/altium_schematic.pdf

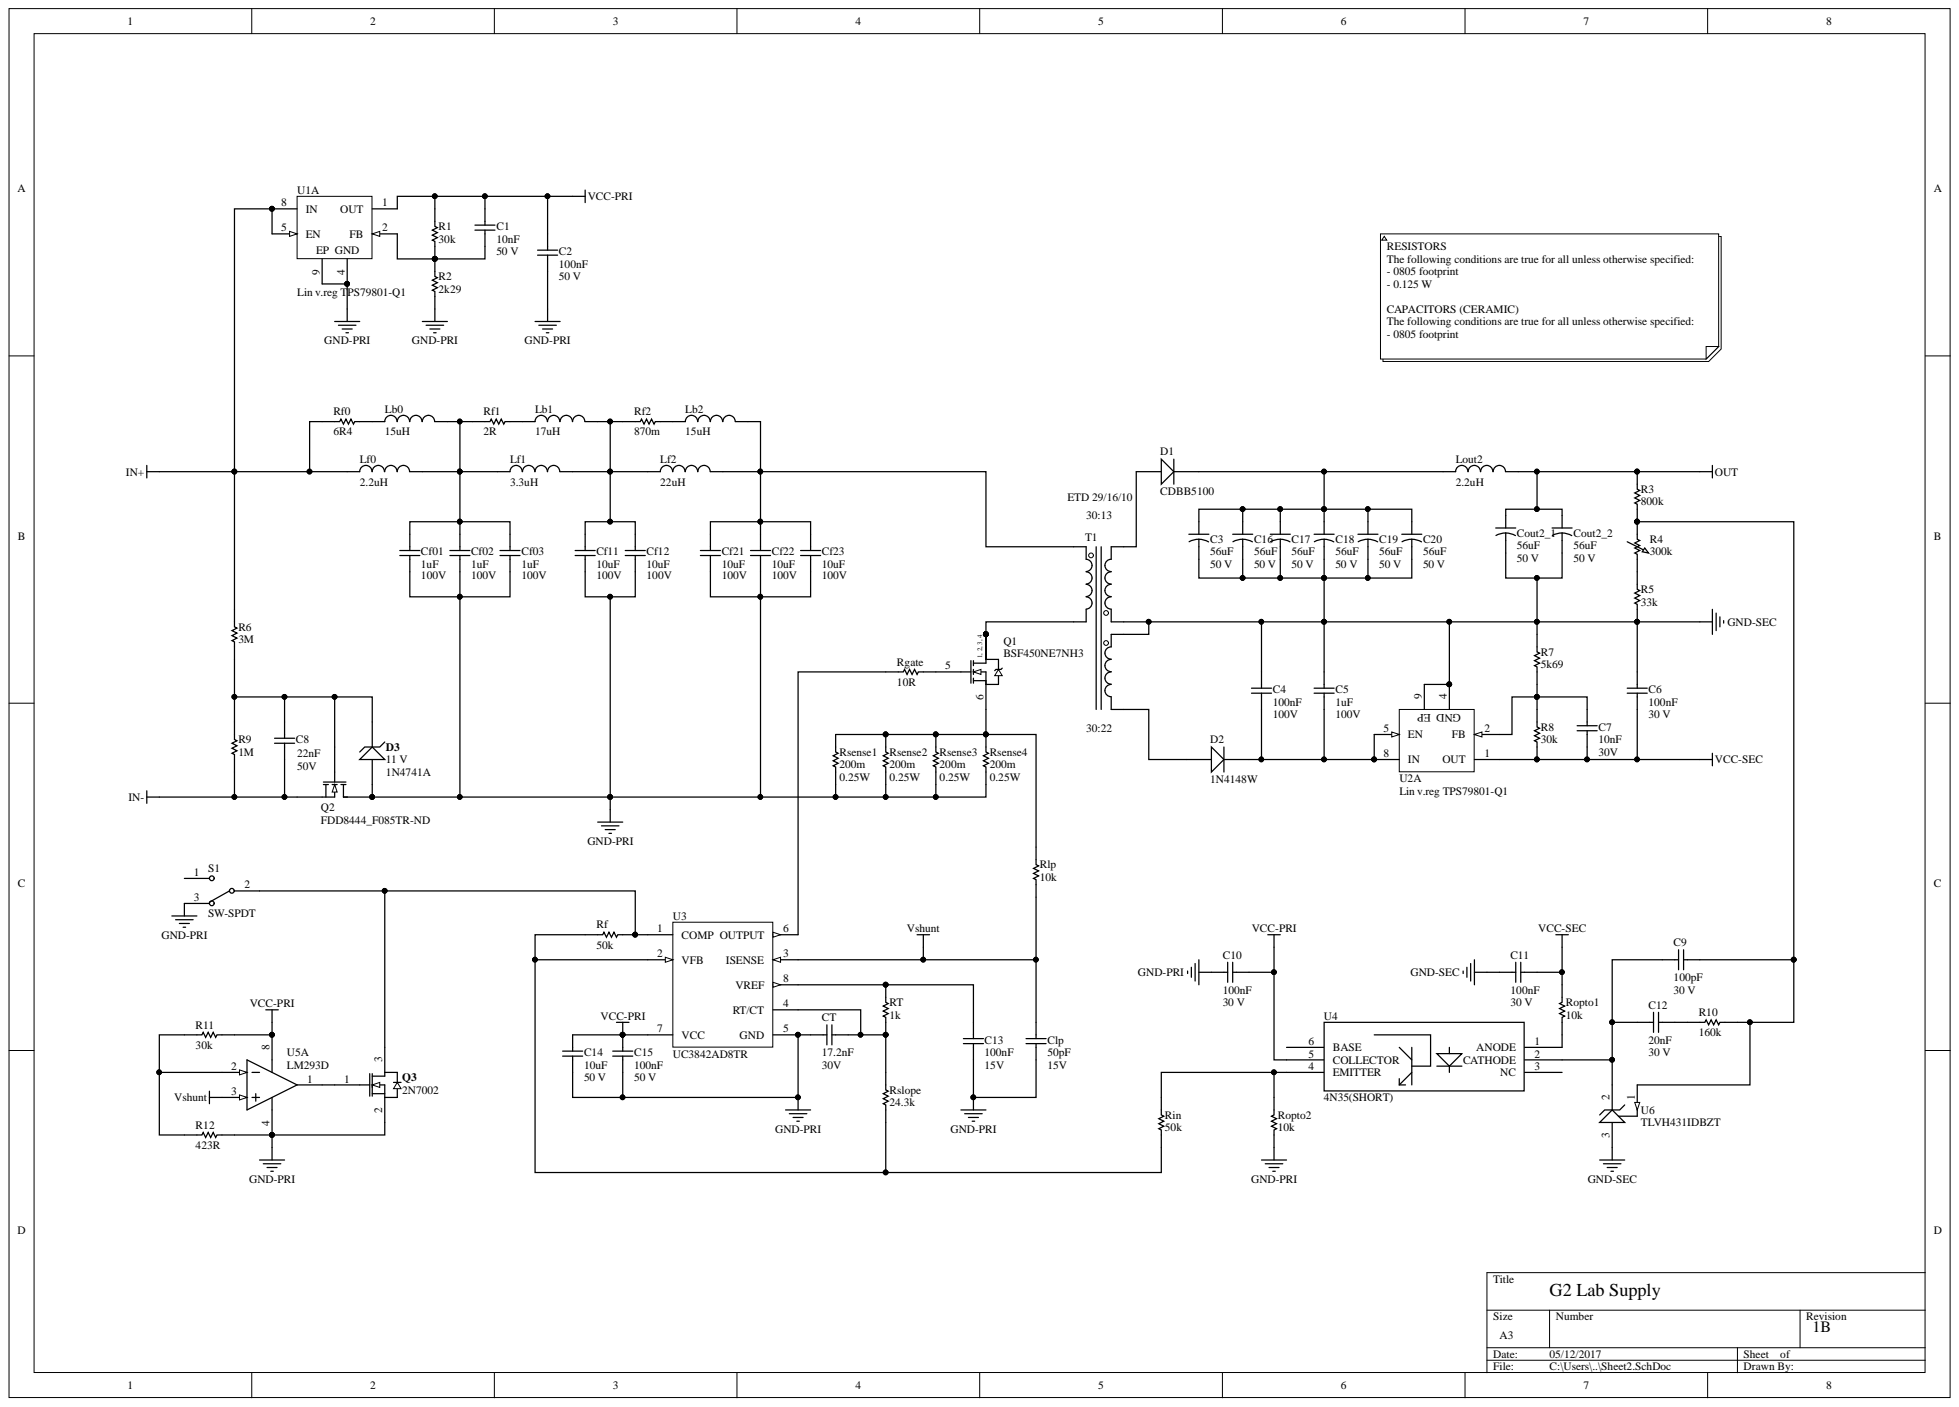
[picture p122: page 1]

RESISTORS
The following conditions are true for all unless otherwise specified:
- 0805 footprint

CAPACITORS (CERAMIC)

Rf
50k
