ChristianLumby/Power2LabPowerSupply/31352_Flyback/layout_print_3_1.pdf

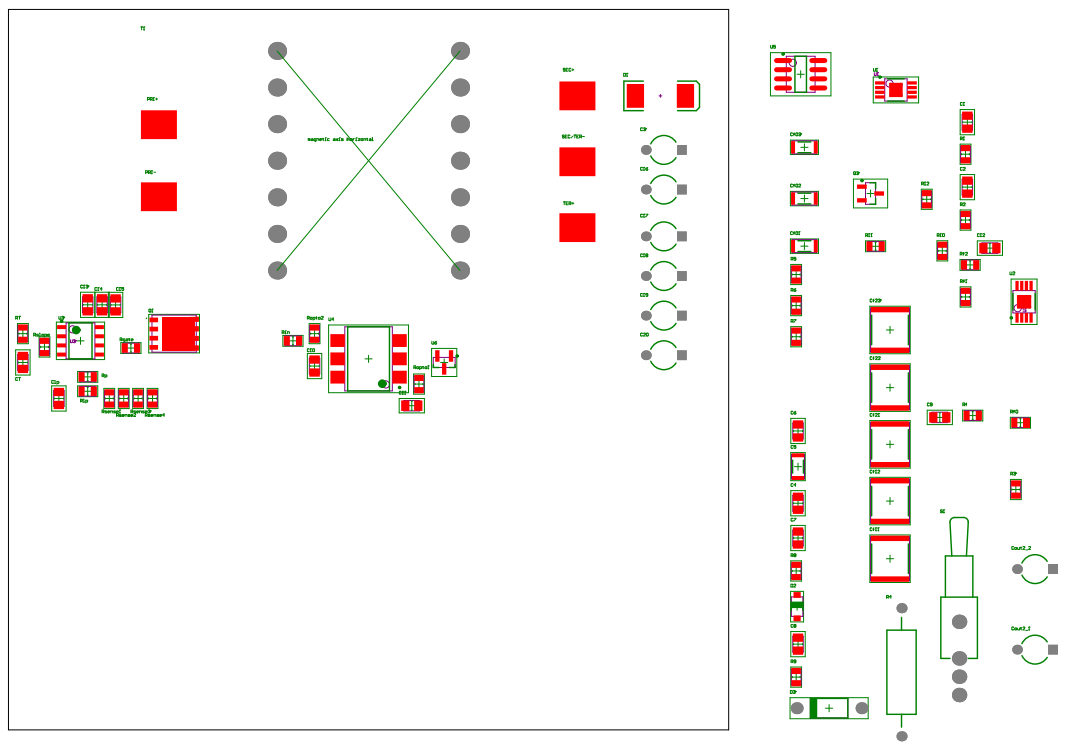
[picture p123: page 1]
