ChristianLumby/Power2LabPowerSupply/Measurements/EMC/EMC_QP.pdf

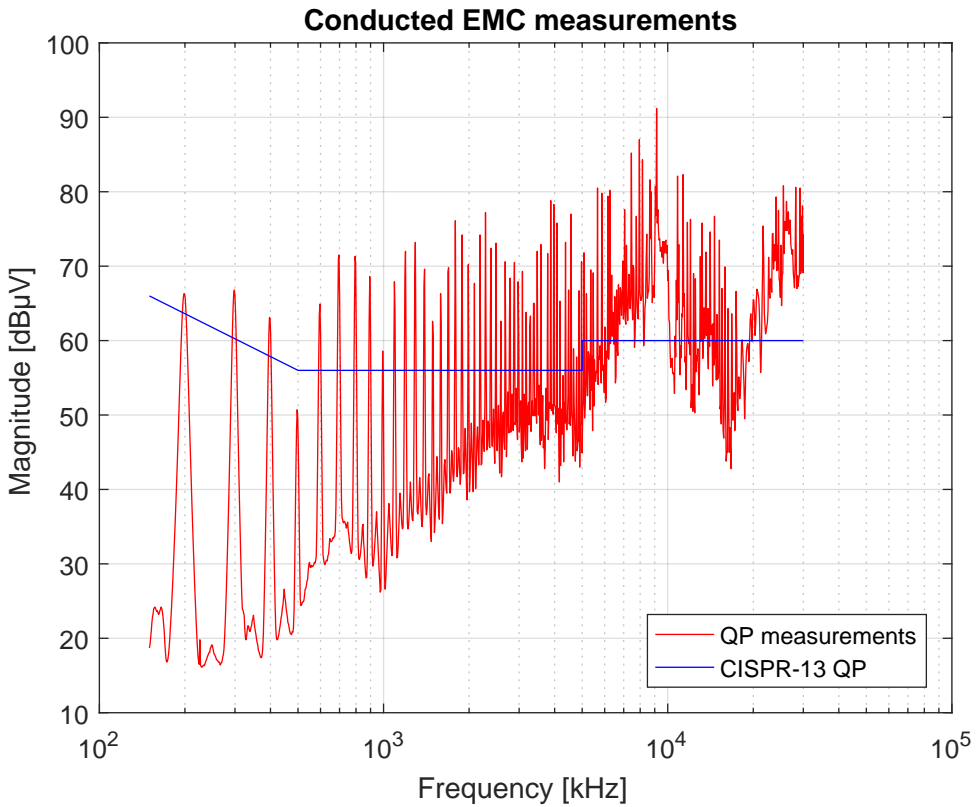
[picture p124: page 1]
Frequency [kHz]; Magnitude [dBµV]

Conducted EMC measurements

QP measurements
CISPR-13 QP
