ChristianLumby/Power2LabPowerSupply/Simulations/Snupper_simulation.asc

C1: cap; 100µ
C4: cap; 200n
D1: schottky; 1N5819
D2: schottky; MBRS340
L1: ind2; 320µ
L2: ind2; 60µ
L3: ind; 4µ
M1: nmos; BSB014N04LX3
R1: res; 30
R4: res; 309
V1: voltage; 20
V2: voltage; PULSE(0 10 0 10n 10n 0.00000776 0.00001)
Named nets: 0
K1 L1 L2 1
.tran 0 0.05 0
.ic V(n002)=30
