ChristianLumby/Power2LabPowerSupply/(list of files, drawings)

Other design files:
31352_Flyback/4N35_model/AltiumDesigner.PcbLib
31352_Flyback/4N35_model/AltiumDesigner.SchLib
31352_Flyback/Banana_jacks.PcbLib
31352_Flyback/Banana_jacks.SchLib
31352_Flyback/Flyback.SchLib
31352_Flyback/Flyback_lab_supply.PrjPcb
31352_Flyback/Library-Arduino-Nano-Altium-master/arduinoNano.PcbLib
31352_Flyback/Library-Arduino-Nano-Altium-master/arduinoNanocop.PcbLib
31352_Flyback/Library-Arduino-Nano-Altium-master/nanoArduino.SchLib
31352_Flyback/PCB2.PcbDoc
31352_Flyback/PcbLib1.PcbLib
31352_Flyback/Sheet2.SchDoc
