ChristianLumby/Power2LabPowerSupply/(commit log)

2017-12-22 Test file removed
    [1_TOP.gbr]
2018-01-03 Added BOM template
    [BOM.xlsx]
2018-01-03 BOM file closed
    [BOM.xlsx]
2018-01-03 BOM excel file
    [BOM.xlsx]
2018-01-03 updated altium files
    [AltiumDesigner.PcbLib, Flyback_lab_supply.PrjPcb, PCB2.CSV, PCB2.PcbDoc, Sheet2.SchDoc]
2018-01-04 BOM updated.
    [BOM.xlsx]
2018-01-04 altium schematic changed
    [Sheet2.SchDoc]
2018-01-04 BOM updated
    [BOM.xlsx]
2018-01-04 schematic update
    [Flyback.SchLib, Sheet2.SchDoc]
2018-01-04 beautified schematic
    [Sheet2.SchDoc]
2018-01-05 BOM and schematic update
    altium
    [BOM.xlsx, Flyback_lab_supply.PrjPcb, Sheet2.SchDoc]
2018-01-08 matlab plots new values
    [PCB2_test.brd]
2018-01-09 arduino stuff
    [102 RESISTOR PACK.SLDPRT, 15pin_header__.sldprt, 16mhz crystal - measured.SLDPRT, 189 RESISTOR PACK.SLDPRT, 2pin_header__02.sldprt, MINI USB CONTACT.SLDPRT, MINI USB SOLDER.SLDPRT, MINIUSB - MEASURED.SLDASM]
2018-01-09 recieved parts BOM update
    [BOM.xlsx]
2018-01-10 altium update and input filter measurements
    [3310y-001.stp, Flyback_lab_supply.PrjPcb, LCD.SLDPRT, Pot_10k_fine.SLDPRT, Pot_1k_curr.SLDPRT, Pot_500k_coarse.SLDPRT, Sheet2.SchDoc]
2018-01-13 effeciency open loop added
    [Effeciency Open Loop 13-01-2017.xlsx]
2018-01-15 final report from prev. course
    [Banana_jack_black.SLDPRT, Banana_jack_black.STEP, Banana_jack_red.SLDPRT, Banana_jack_red.STEP, LCD.SLDPRT, Pot_10k_fine.SLDPRT, Pot_1k_curr.SLDPRT, Pot_500k_coarse.SLDPRT]
2018-01-17 Effeciency updated
    [Effeciency CLosed Loop Lin Reg Included 17-01-2018.xlsx, Effeciency Closed Loop 16-01-2018.xlsx, Effeciency Open Loop 13-01-2018.xlsx]
2018-01-17 EMC plot
    [BOM.xlsx]
2018-01-22 pcb update
    [Sheet2.SchDoc]
2018-01-25 Schematic and footprint update
    [16pin_header__.sldprt, AltiumDesigner.PcbLib, AltiumDesigner.SchLib, Flyback.SchLib, Flyback_lab_supply.PrjPcb, LCD.SLDASM, Sheet2.SchDoc, arduinoNano.PcbLib]
